mdrndesigns/pegboardlab/plan/layout_v2.pdf

# P E G B O A R D L A B · S T U D I O L A Y O U T P L A N v 2

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

## A · IMPE RI A L · c hi p b o a r d 1 9 · 1 : 7. 5

31 × 50 · Ø7.6 · 23.876 square · studs Ø7.8 × 18 · 30 × 50 holes

Tool bag

HL

End
nippers

HD

Spring clamp L
×2

HD

Spring
clamp S ×2

HD

Combination
square

HJ

GWS 12V grinder

HS

Drill bit case

TR

GKS 12V circular saw HS | Bits · small parts TR

Accessory box

TR

Glue
pen

HD

GSR 12V drill

HS

GRO 12V
rotary

HS

Chisels ×3 +
gouge

RK

Screwdrivers
×2

RK

Marking
knife
HJ

Tool-Check Plus

TR

Ratchet

HJ

Hex keys ×9

RK

Laser level TR | Future Wera ×6 RK

Pliers ×6 + crimper slot

RK

Work light tube

HD

Aviation
snips

HJ

Scissors

HJ

Wrenches ×2 + spare RK | Multitool TR | Spare J ×2 (knife · cutter) HJ

5 M E A S U R E · M A R K ( n e a r e s t t h e b e n c h )
Rules 150 · 300 MG | Digital caliper HS | Micrometer HJ | Protractor HJ | Tape measure HS | Pens · markers ×8 RK | Test leads · cable CL | Zone labels ×6 PL

Spare J
×2
(quick-draw)

HJ

Scriber · feelers RK | Spare (future measure) HJ

### 1 C L A M P S · S Q U A R E · B A G

2 B O S C H 1 2 V S Y S T EM | 3 I RW I N H A N D T O O L S | 4 W E R A · D R I V E · L E V E L

### 6 C U T · G R I P · P OW E R

### 7 B E N C H B I N S ( e x i s t i n g )

C L E A R

## C · M E T RI C · p o r t r ai t ? · 1 : 7. 5

450 × 1850 ? · Ø4.9 · 27.44 / 13.72 · confirm · 16 × 133 holes

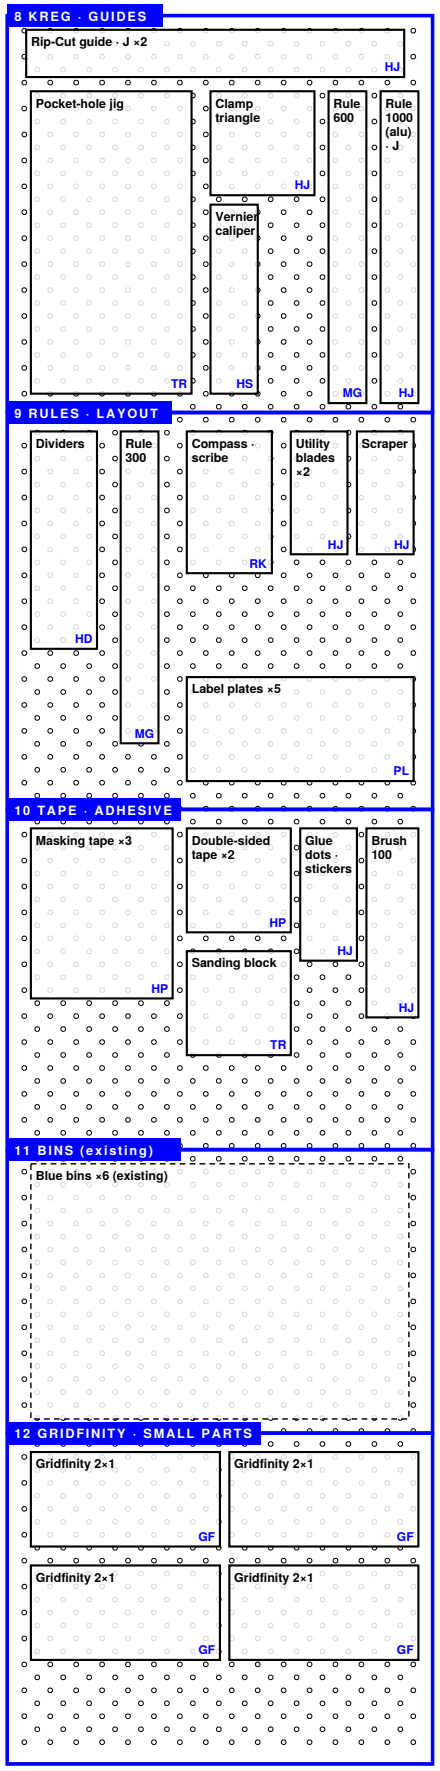
[picture p1: figure]
Rip-Cut guide · J ×2; Pocket-hole jig; Clamp triangle; Vernier caliper; Rule 600; Rule 1000 (alu) · J; Dividers; Rule 300; Compass · scribe; Utility blades ×2; Scraper; Label plates ×5; Masking tape ×3 HP; Double-sided tape ×2 HP; Glue dots · stickers HJ; Brush 100 HJ; Sanding block; Blue bins ×6 (existing); Gridfinity 2×1

1 2 G RI D F I N I T Y · S M A L L P A R T S

## B · M E T RI C · l a n d s c a p e 4 mm · 1 : 1 0

2100 × 530 · Ø4.9 · 27.44 / 13.72 lattice · right 700 kept for the filament boxes ? · 76 × 36 holes

F-clamps ×4

HJ

Straightedge 1000
HJ

Pull saw · hand saws

HJ

Extension cord

HR

Label plates ×3
PL

Gridfinity 4×1

GF

Gridfinity 4×1

GF

Gridfinity 4×1

GF

Gridfinity 4×1

GF

Gridfinity 4×1

GF

Gridfinity 4×1

GF

Gridfinity 4×1

GF

1 3 L O N G T O O L S · S AW S · C L A M P S

1 4 G R I D F I NI T Y S H E L F R OW · h a r d w a r e

F I L A M E N T B O X E S ( b e n c h ) ?

## A C CES S O R Y C O DES

HS Holster · saddle | holster · hs_type=saddle | HR Holster · ring | holster · hs_type=ring
HJ Hook · J | hook · hk_type=j | HD Hook · double prong | hook · hk_type=double
HL Hook · loop | hook · hk_type=loop | HP Hook · peg (rolls) | hook · hk_type=peg
RK Rack · holes / slots | rack · rk_type=… | TR Tray / bin | tray · tr_type=…
MG Magnet strip | magstrip · mg_mode=embed | CL Clip · cables | clip · cl_type=snap
GF Gridfinity shelf | gridfinity · gf_nx × gf_ny | PL Label plate | plate · pl_w × pl_h

## P L A CEME N T R U LE S

Brand clusters: Bosch 12V left column of A (holsters, one grab, no tilt) · Irwin centre · Wera right · Kreg on C.
Reach: measuring nearest the bench (A rows 36–45), then pliers · cutters · drivers · knives above (rows 24–36); clamps and the bag up top. Stability: two-part holders - a spine with ≥2 sized studs (Ø7.8 on A) or a J-hook + stop (C / B), the holder screwed to it with
Ø3.5 × 15 countersunk drywall screws; on A the screws run on into the studs and expand them in their holes. No steel hooks remain. Quick draw: holsters and J-hooks lift straight up; racks open to the front; nothing is stacked behind anything else.
Put-back: every holder carries its label plate (item name, brand) so an empty slot says what is missing.
Board B: long tools and a Gridfinity shelf row for small parts; right 700 mm stays bench space while the filament lives there.
To measure before printing: board C size and lattice, bench height under A (reach), fan / power-strip keep-out on A.

## P RI N T C O U N T ( h ol d e r s )

### 20 Hook · J 11 Gridfinity shelf 9 Rack · holes / slots 8 Tray / bin 7 Holster · saddle 6 Hook · double prong 3 Magnet strip 3 Label plate 2 Hook · peg (rolls) 1 Hook · loop 1 Clip · cables 1 existing / keep 1 Holster · ring

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
