mdrndesigns/pegboardlab/plan/bosch12v/bosch12v_sheet.pdf

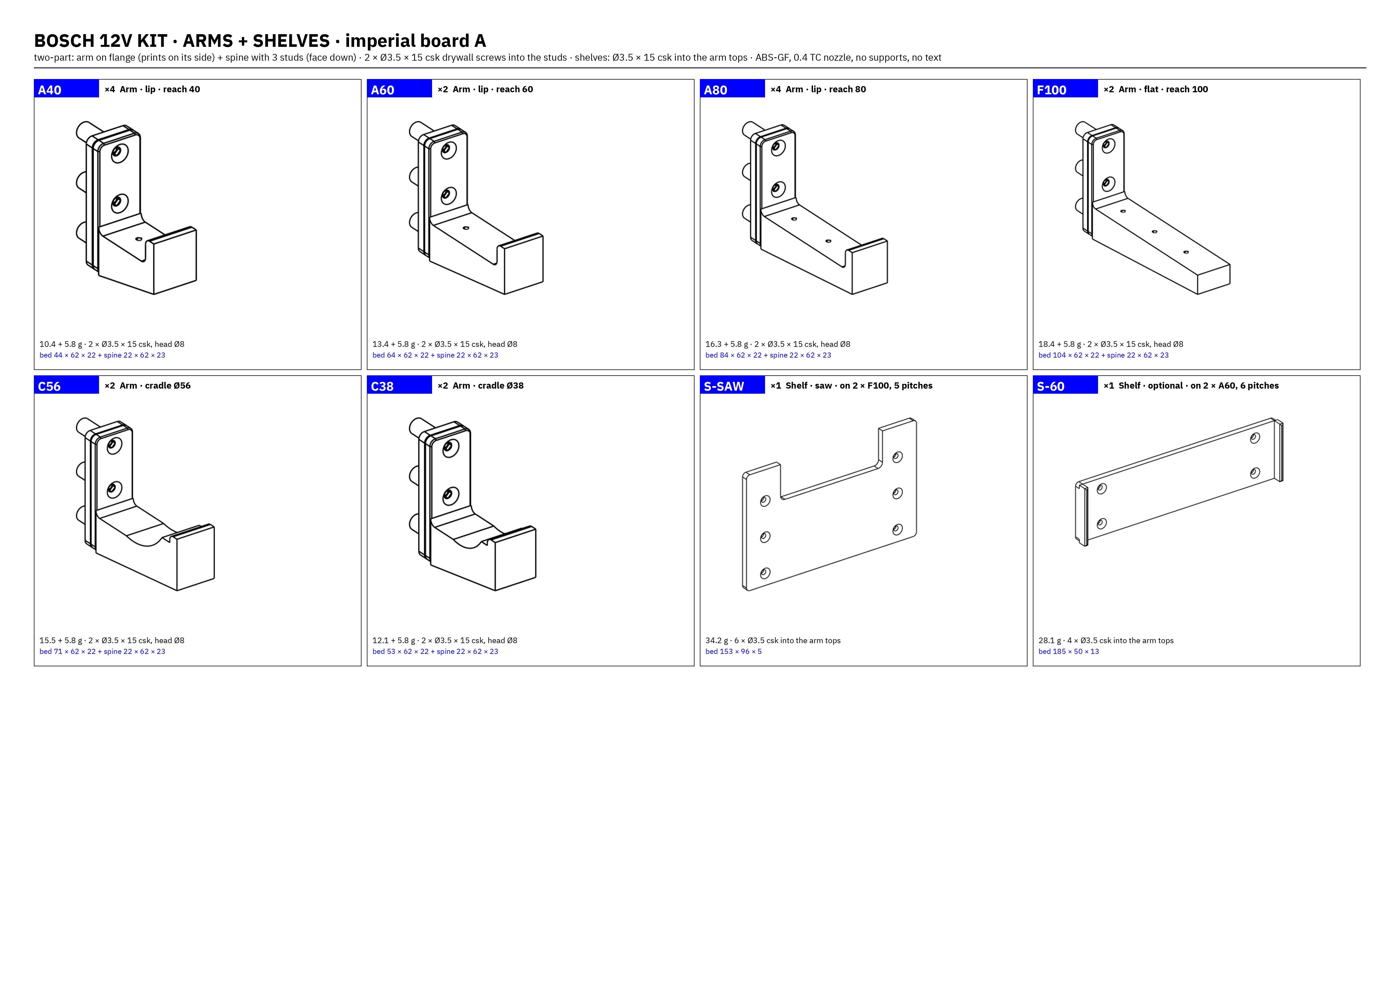
[picture p2: page 1]
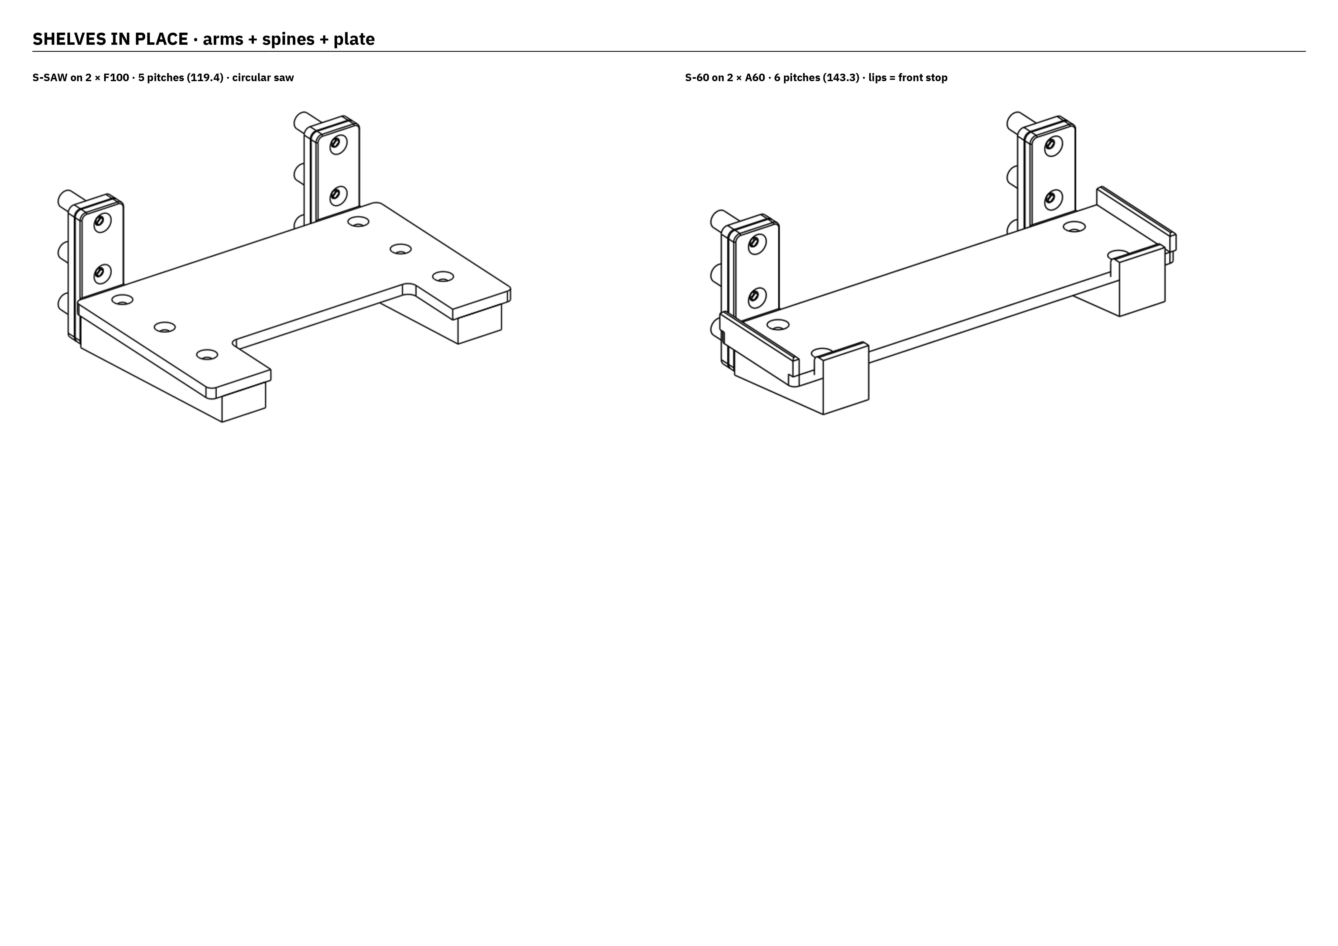
[picture p3: page 2]
