mdrndesigns/pegboardlab/plan/handtools/handtools_sheet.pdf

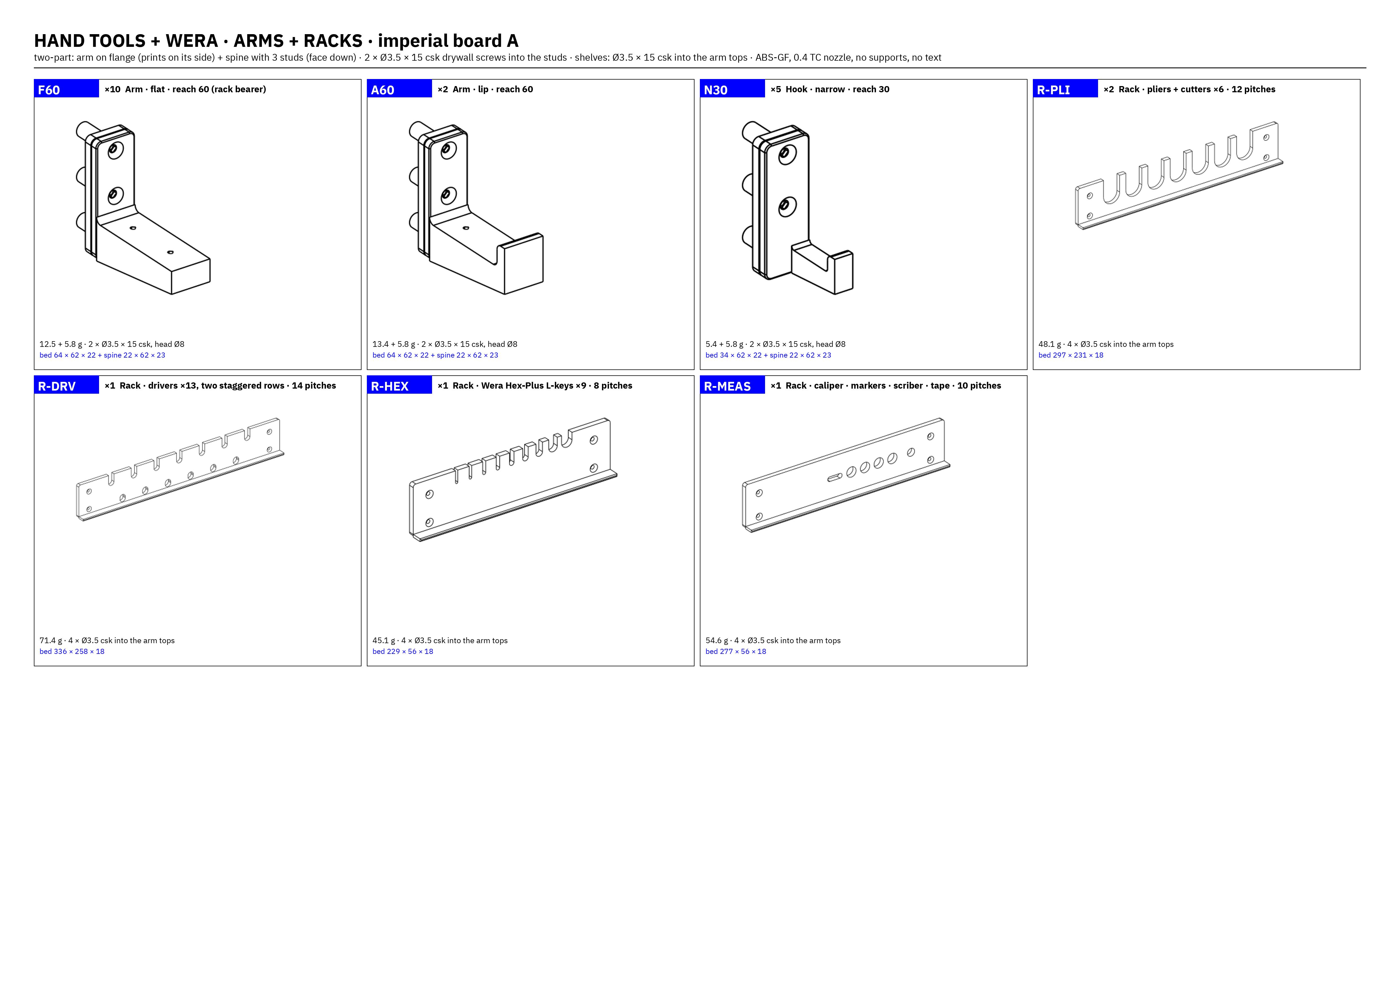
[picture p4: page 1]
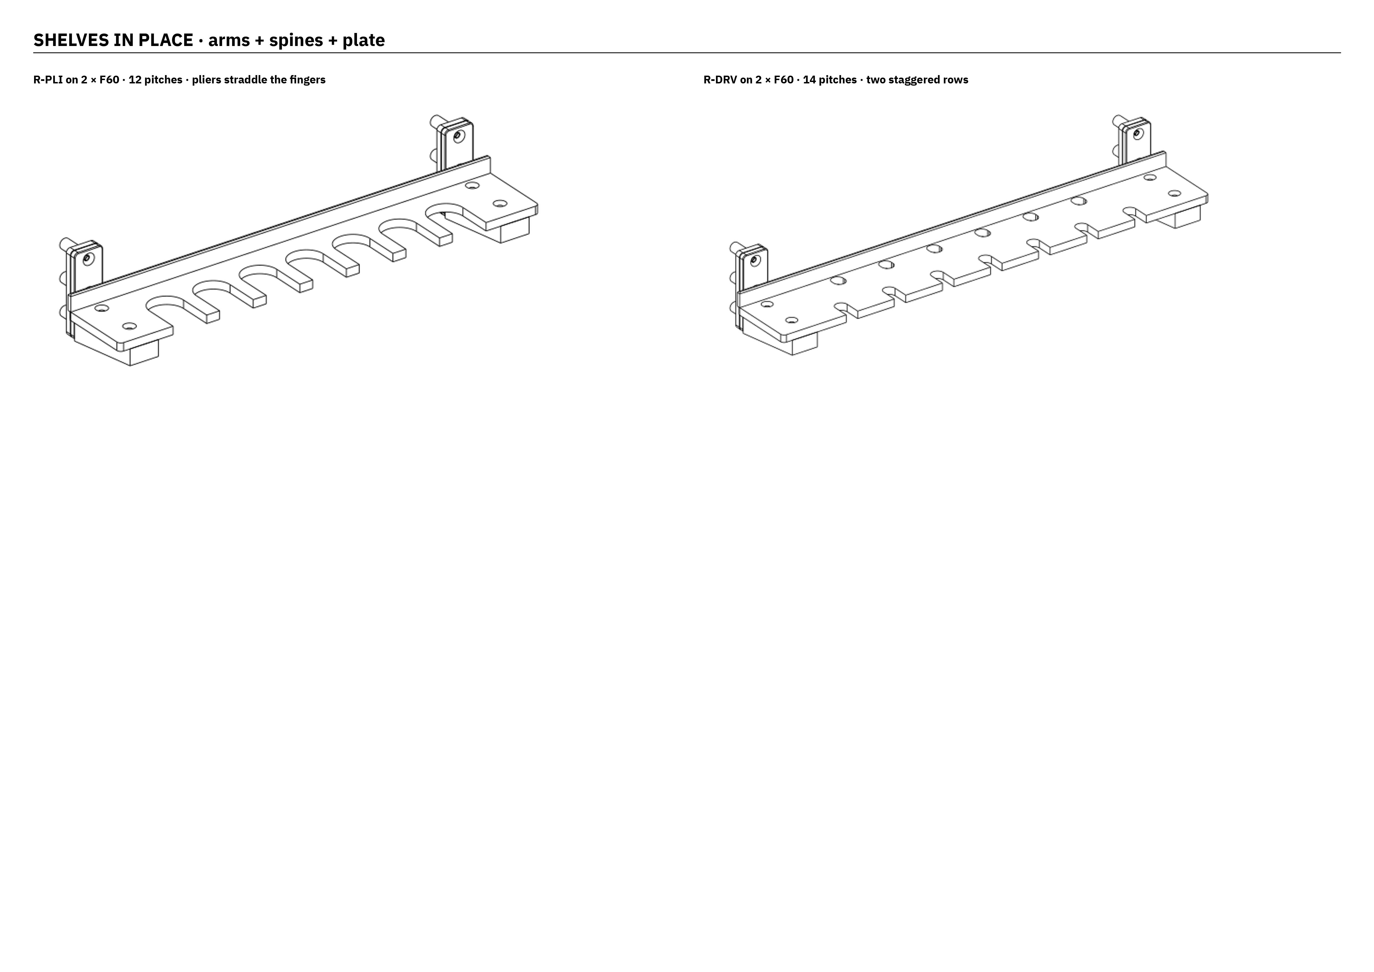
[picture p5: page 2]
