mdrndesigns/pegboardlab/plan/precision/precision_sheet.pdf

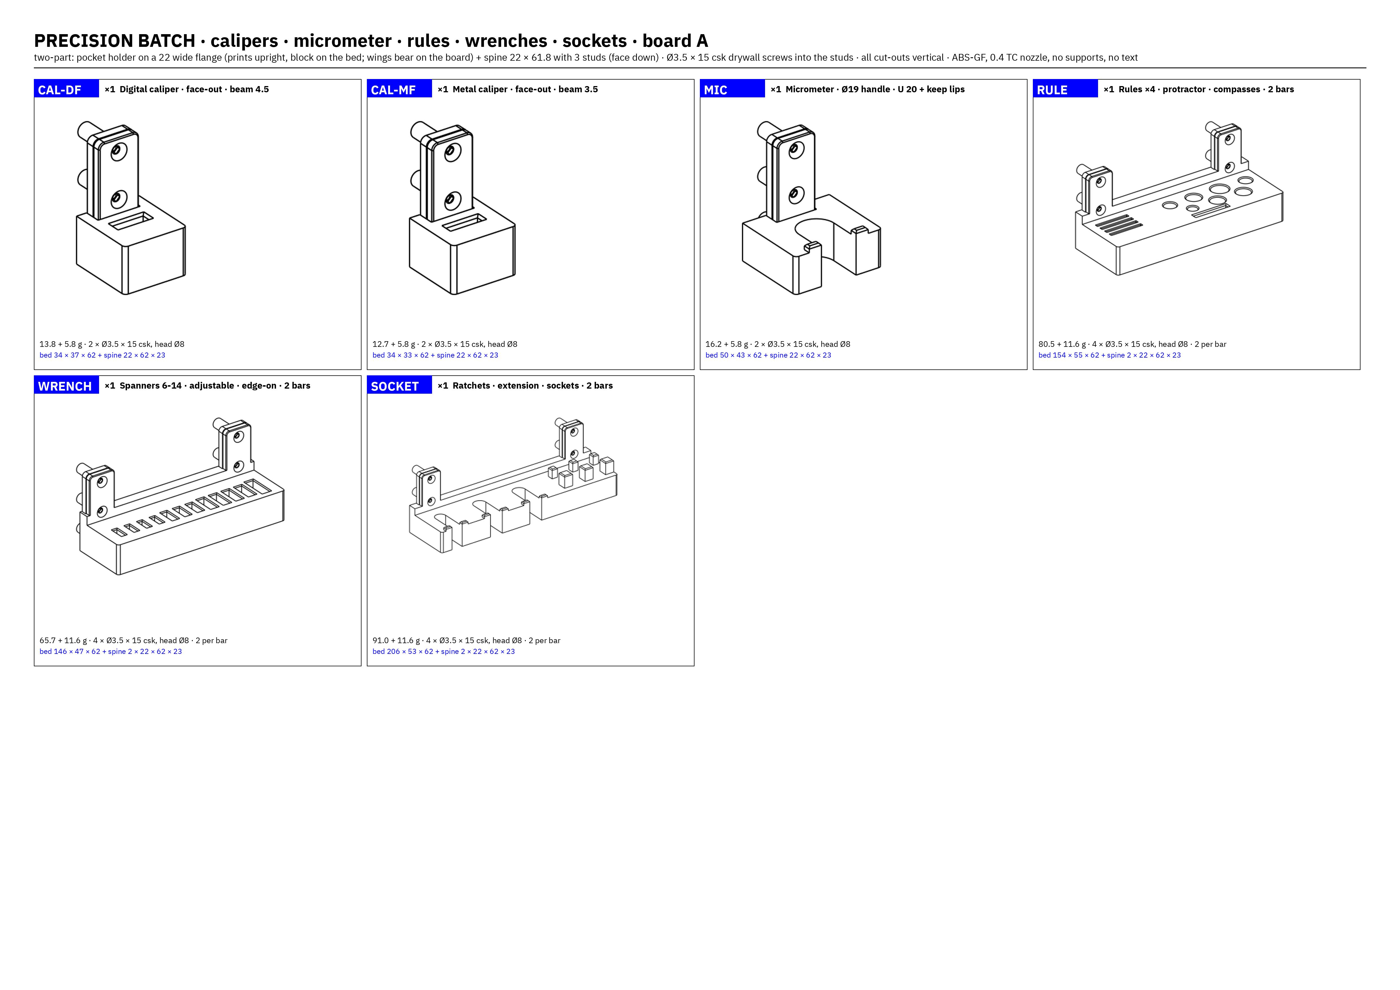
[picture p6: page 1]
