mdrndesigns/pegboardlab/plan/precision_v1_superseded/precision_sheet.pdf

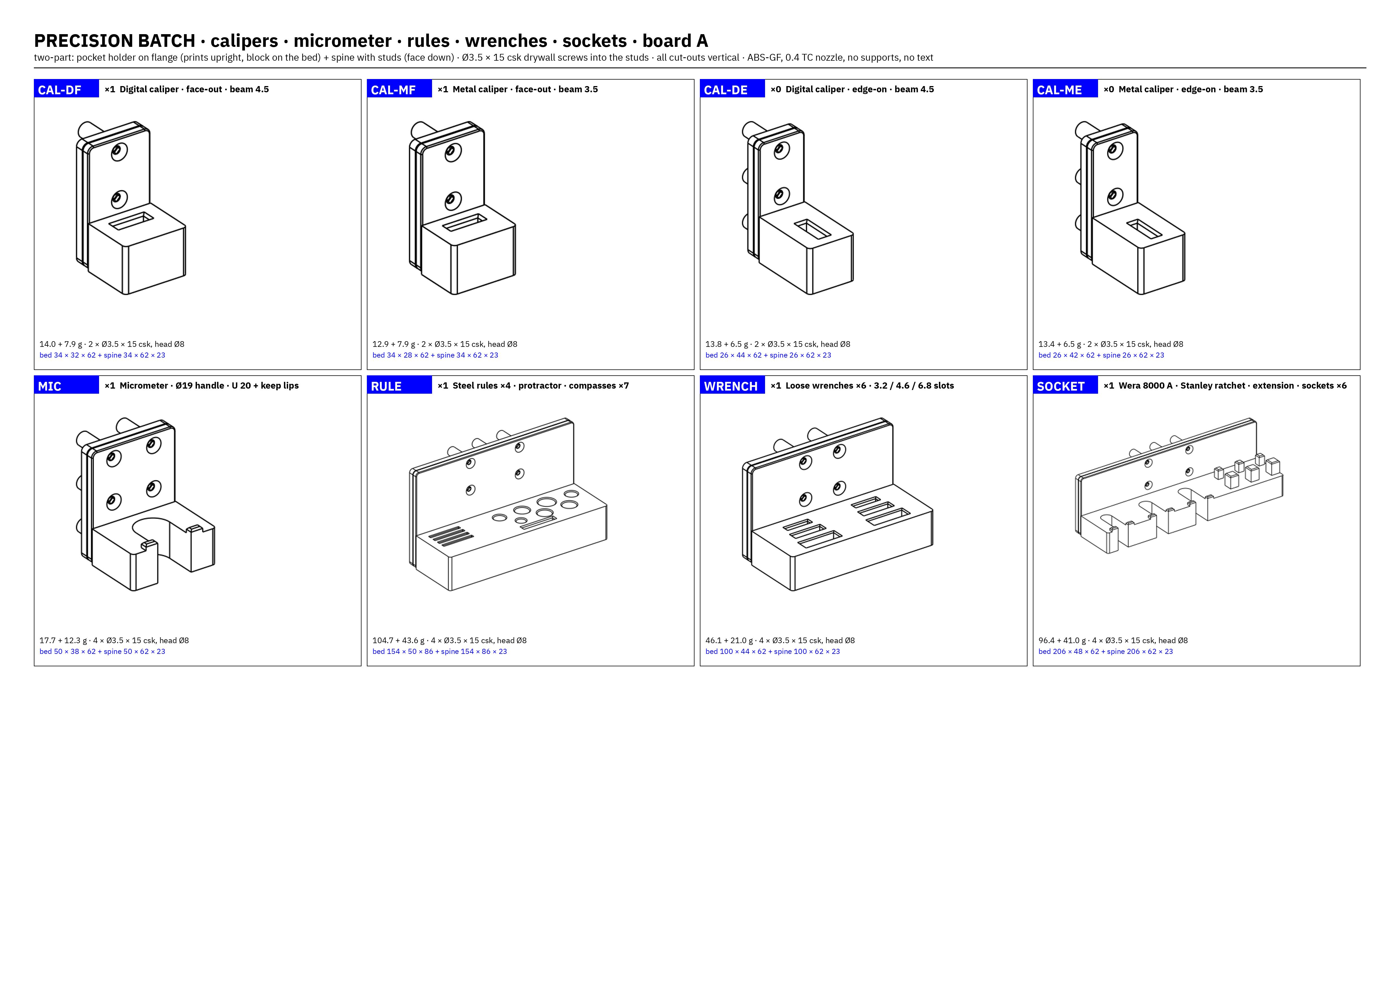
[picture p7: page 1]
