mdrndesigns/pegboardlab/plan/precision_v2_superseded/precision_sheet.pdf

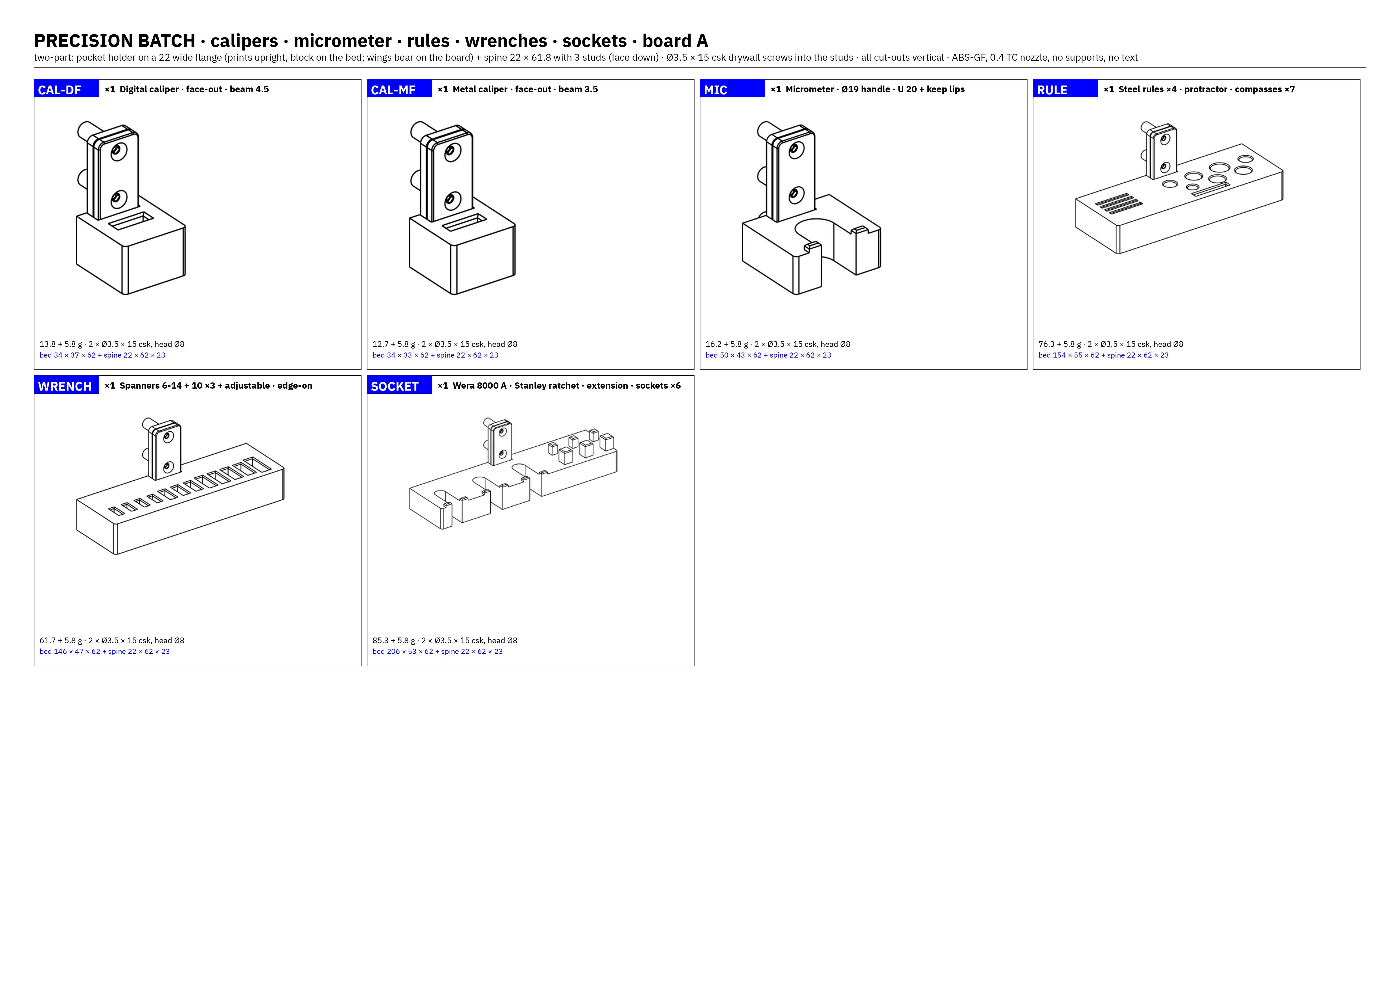
[picture p8: page 1]
