mdrndesigns/pegboardlab/plan/boardA/boardA_map.png

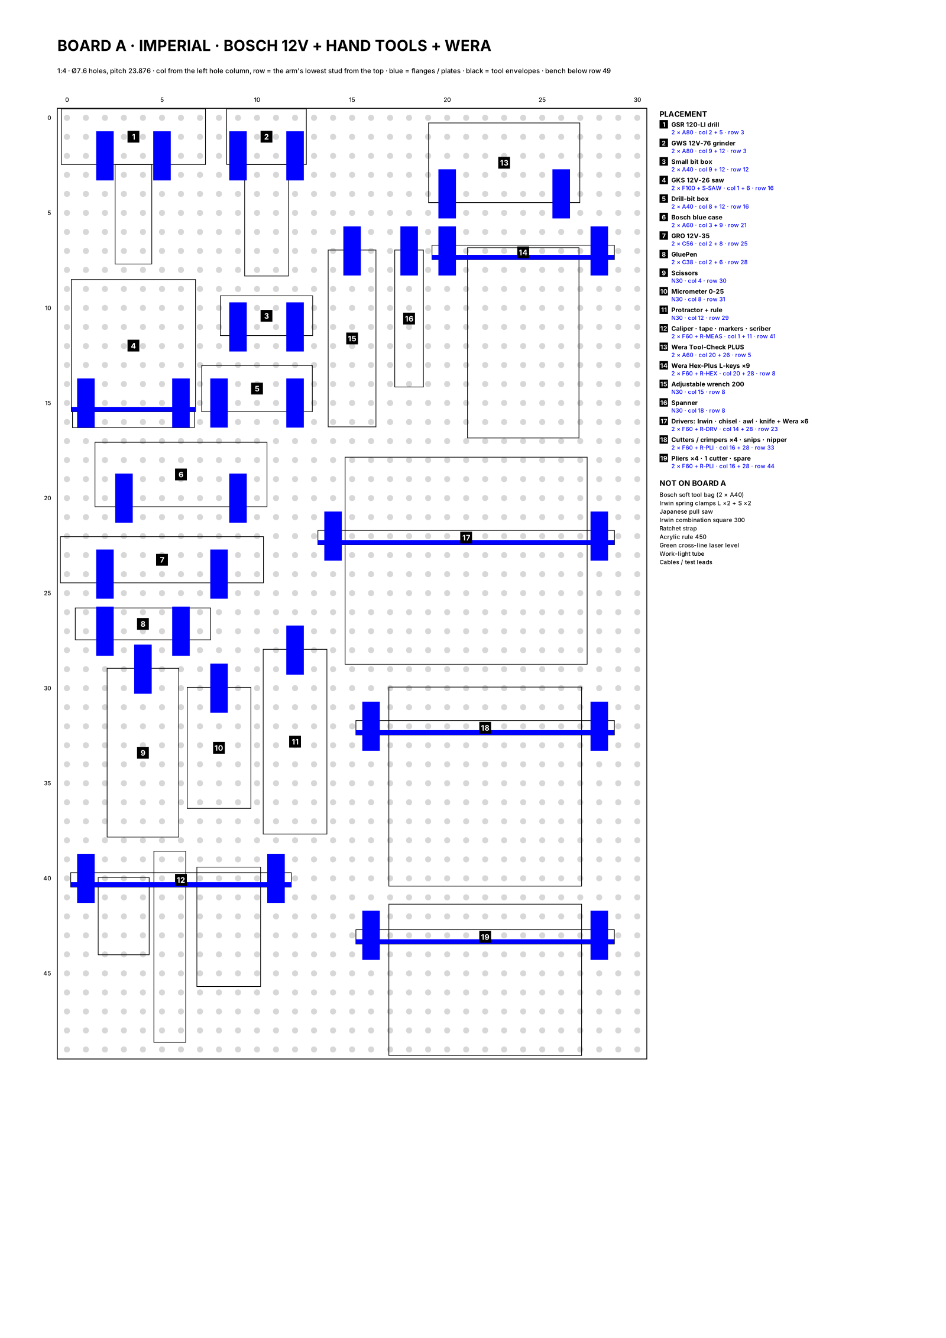
plan/boardA/boardA_map.png
