mdrndesigns/pegboardlab/plan/bosch12v/A40.png

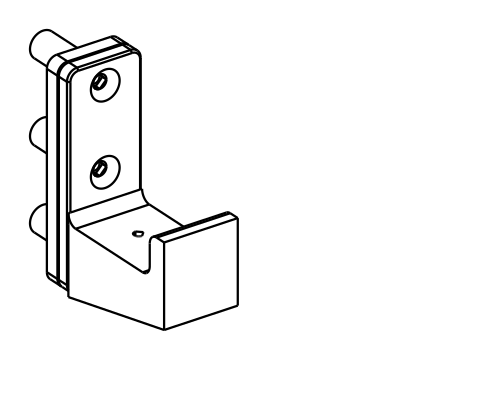
plan/bosch12v/A40.png
