mdrndesigns/pegboardlab/plan/bosch12v/A60.png

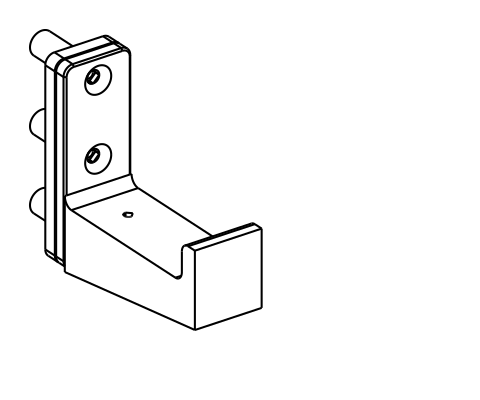
plan/bosch12v/A60.png
