mdrndesigns/pegboardlab/plan/bosch12v/A80.png

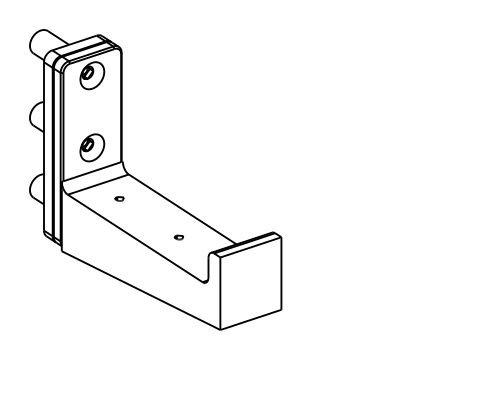
plan/bosch12v/A80.png
