mdrndesigns/pegboardlab/plan/bosch12v/bosch12v_map.png

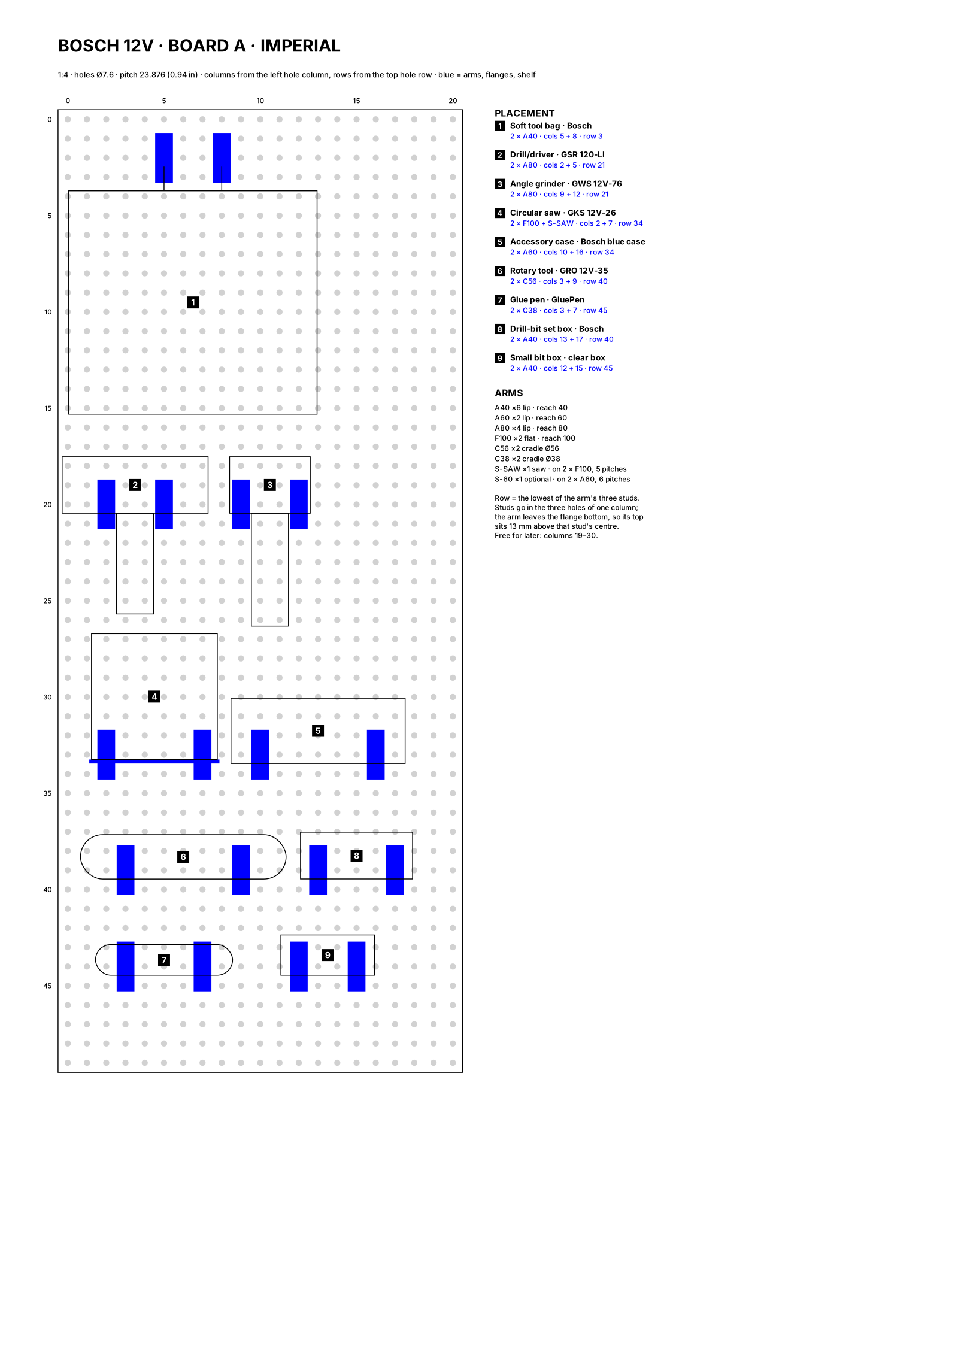
plan/bosch12v/bosch12v_map.png
