mdrndesigns/pegboardlab/plan/bosch12v/C56.png

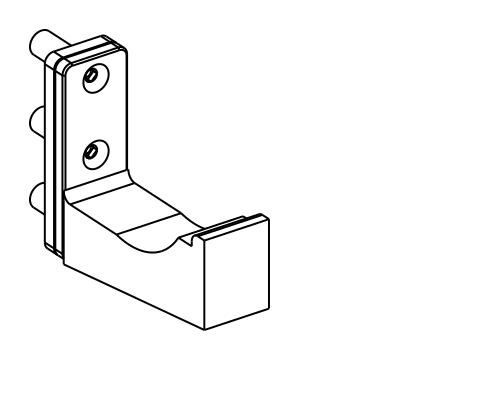
plan/bosch12v/C56.png
