mdrndesigns/pegboardlab/plan/bosch12v/S-60.png

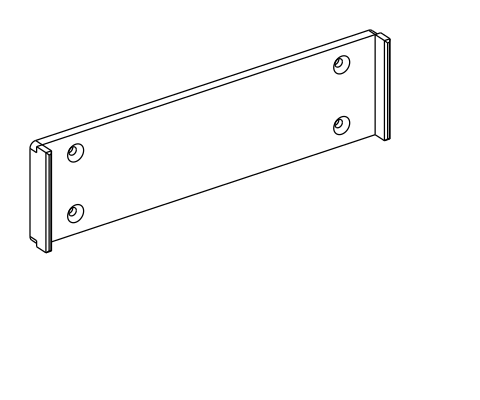
plan/bosch12v/S-60.png
