mdrndesigns/pegboardlab/plan/bosch12v/S-SAW.png

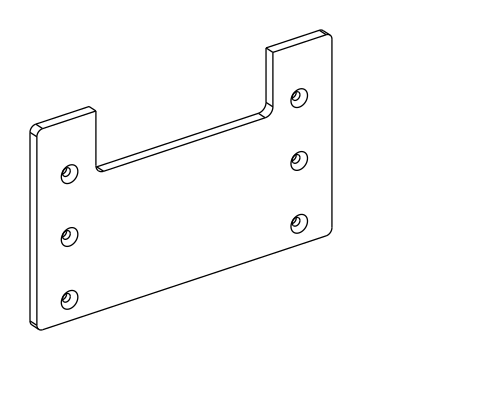
plan/bosch12v/S-SAW.png
