mdrndesigns/pegboardlab/plan/handtools/R-DRV.png

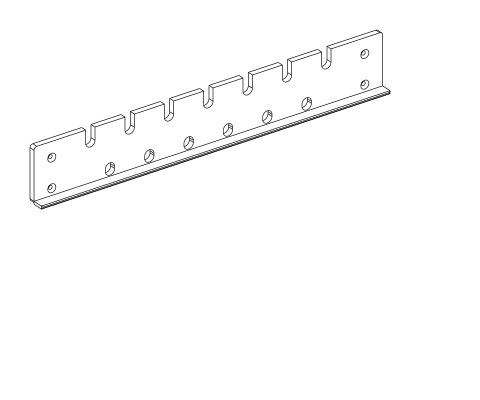
plan/handtools/R-DRV.png
