mdrndesigns/pegboardlab/plan/handtools/R-HEX.png

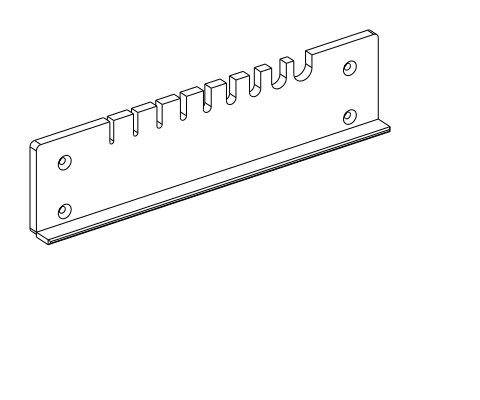
plan/handtools/R-HEX.png
