mdrndesigns/pegboardlab/plan/handtools/R-MEAS.png

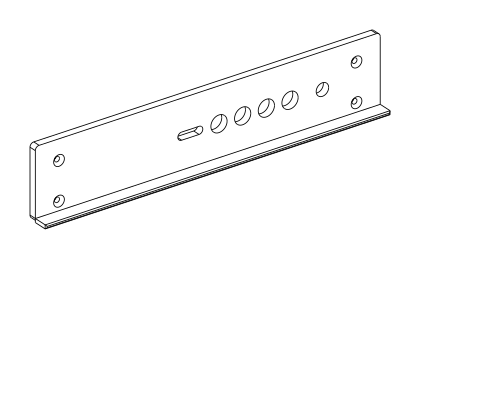
plan/handtools/R-MEAS.png
