mdrndesigns/pegboardlab/plan/handtools/R-PLI.png

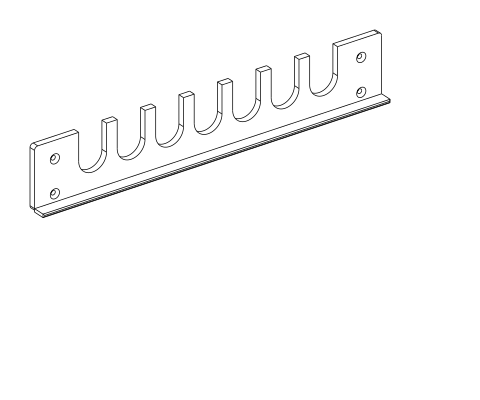
plan/handtools/R-PLI.png
