mdrndesigns/pegboardlab/plan/layout_v1.png

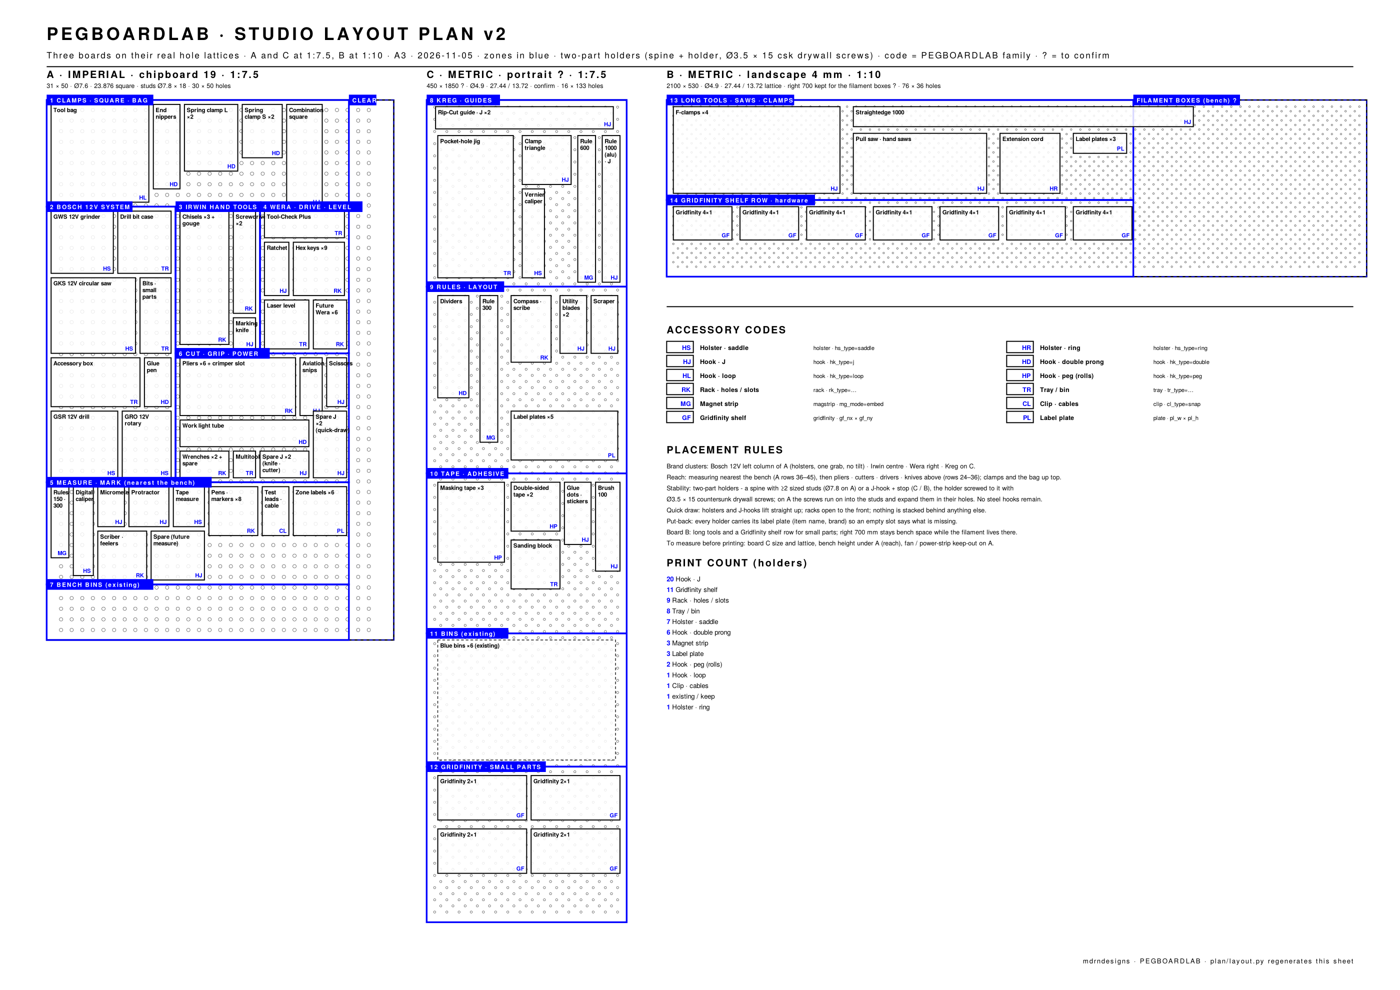
plan/layout_v1.png
