mdrndesigns/pegboardlab/plan/precision/CAL-DF.png

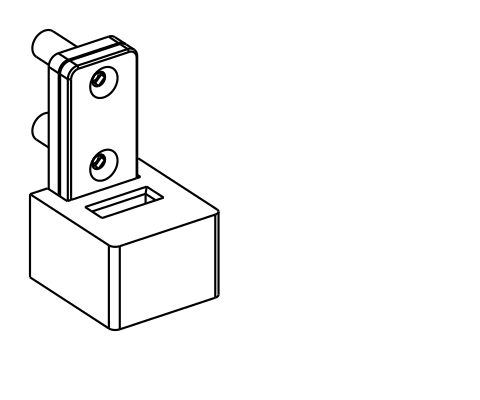
plan/precision/CAL-DF.png
