mdrndesigns/pegboardlab/plan/precision/MIC.png

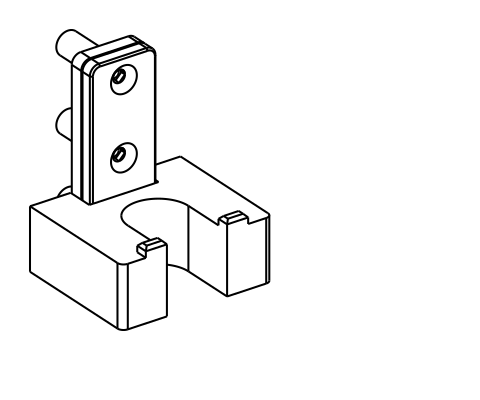
plan/precision/MIC.png
