mdrndesigns/pegboardlab/plan/precision/RULE.png

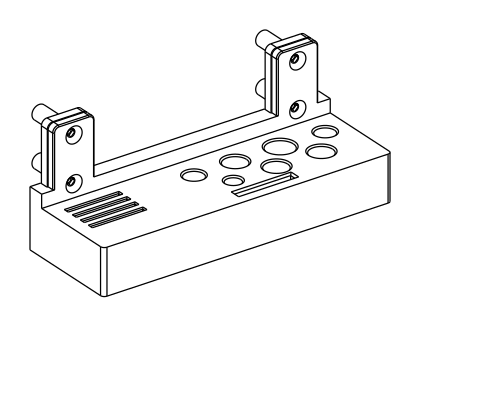
plan/precision/RULE.png
