mdrndesigns/pegboardlab/plan/precision/SOCKET.png

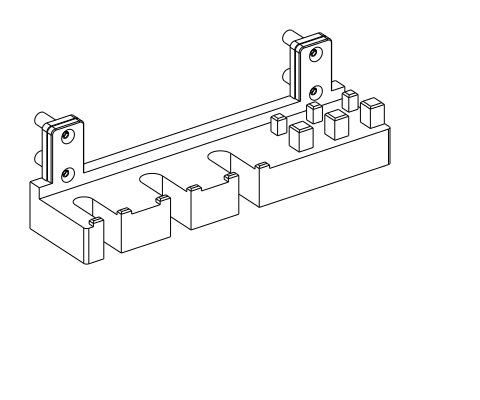
plan/precision/SOCKET.png
