mdrndesigns/pegboardlab/plan/precision/WRENCH.png

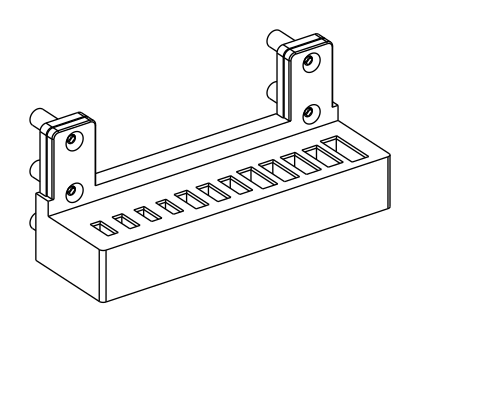
plan/precision/WRENCH.png
