mdrndesigns/pegboardlab/plan/wera_bike12/WERA-BIKE12_empty.png

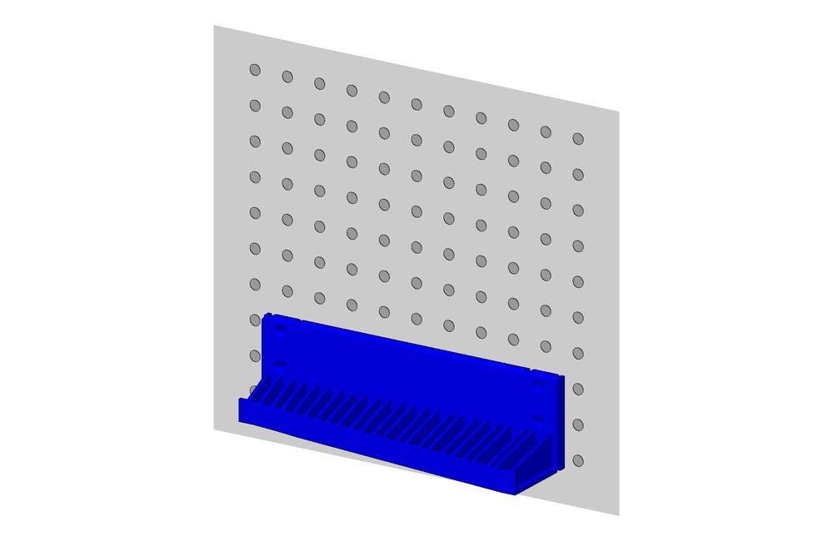
plan/wera_bike12/WERA-BIKE12_empty.png
