mdrndesigns/pegboardlab/plan/wera_bike12/WERA-BIKE12_side.png

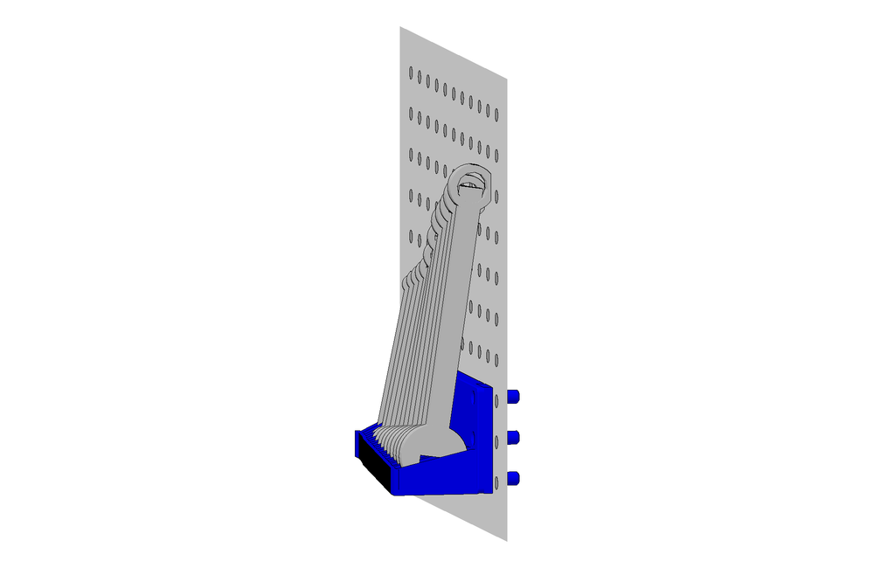
plan/wera_bike12/WERA-BIKE12_side.png
