mdrndesigns/pegboardlab/samples/clip_snap_imperial_preview.png

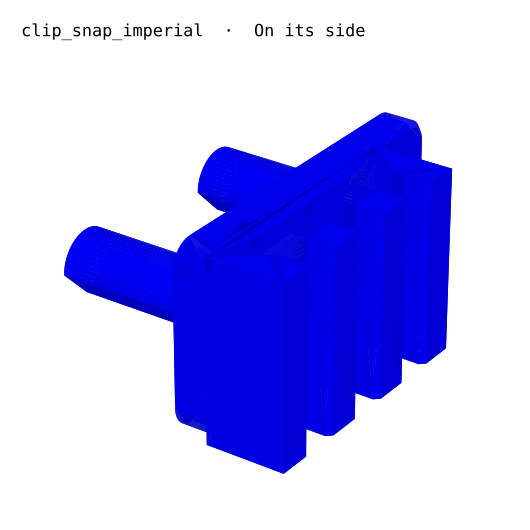
samples/clip_snap_imperial_preview.png
