mdrndesigns/pegboardlab/samples/gridfinity_2x1_tilt_preview.png

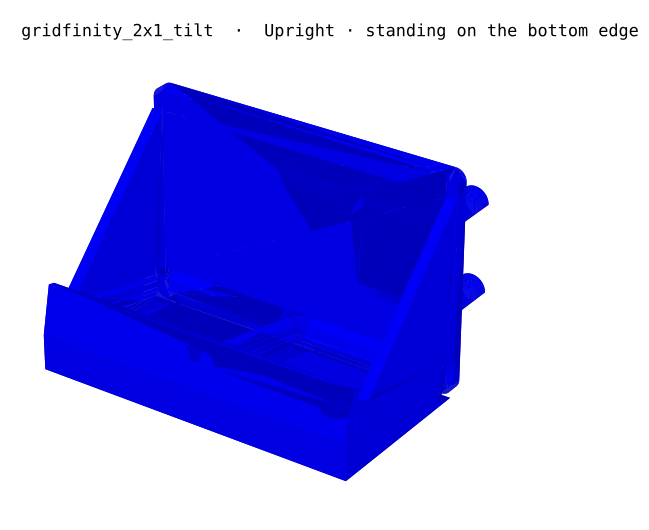
samples/gridfinity_2x1_tilt_preview.png
