mdrndesigns/pegboardlab/samples/holster_drill_imperial_preview.png

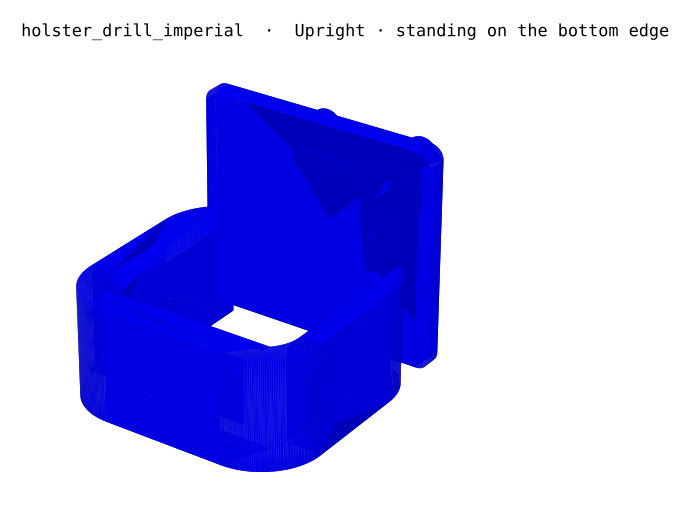
samples/holster_drill_imperial_preview.png
