mdrndesigns/pegboardlab/samples/hook_double_imperial_preview.png

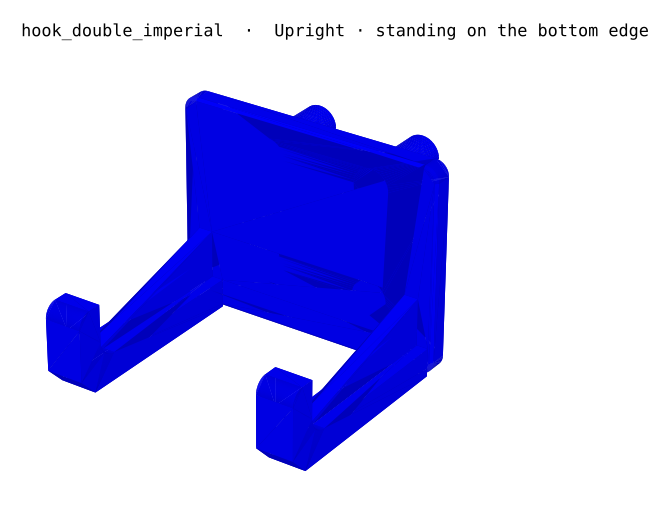
samples/hook_double_imperial_preview.png
