mdrndesigns/pegboardlab/samples/hook_j_imperial_preview.png

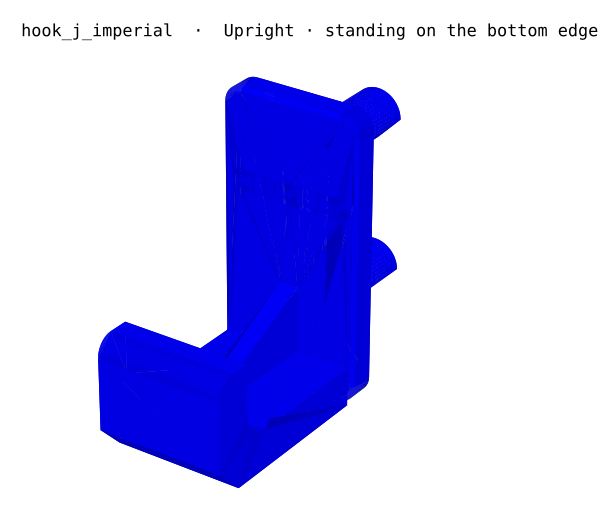
samples/hook_j_imperial_preview.png
