mdrndesigns/pegboardlab/samples/hook_j_metric_jhook_preview.png

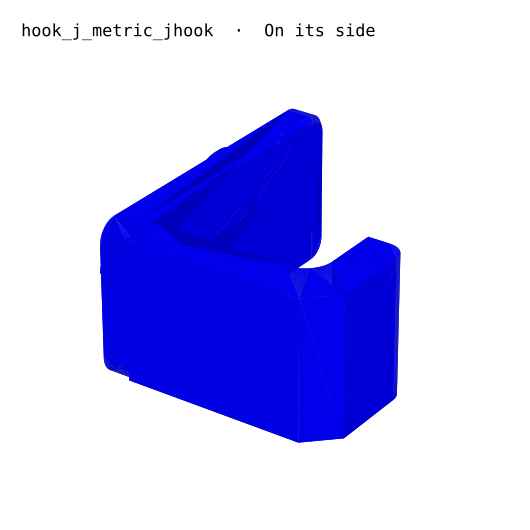
samples/hook_j_metric_jhook_preview.png
