mdrndesigns/pegboardlab/samples/hook_loop_imperial_preview.png

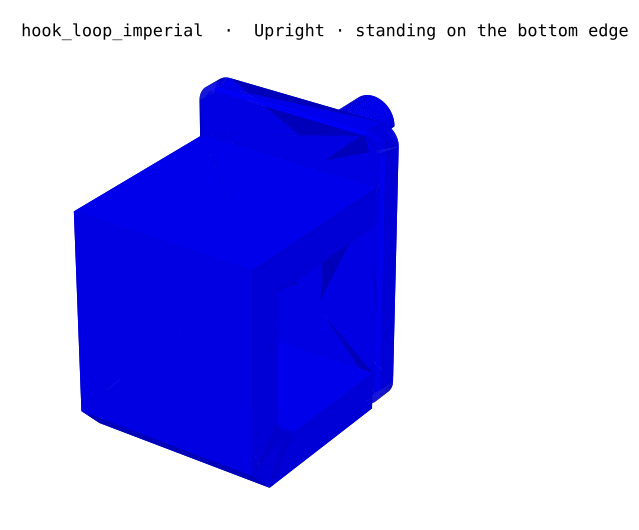
samples/hook_loop_imperial_preview.png
