mdrndesigns/pegboardlab/samples/magstrip_embed_preview.png

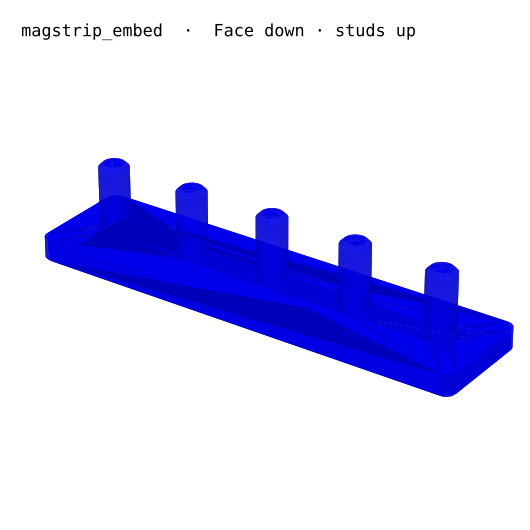
samples/magstrip_embed_preview.png
