mdrndesigns/pegboardlab/samples/nut_knurl_imperial_preview.png

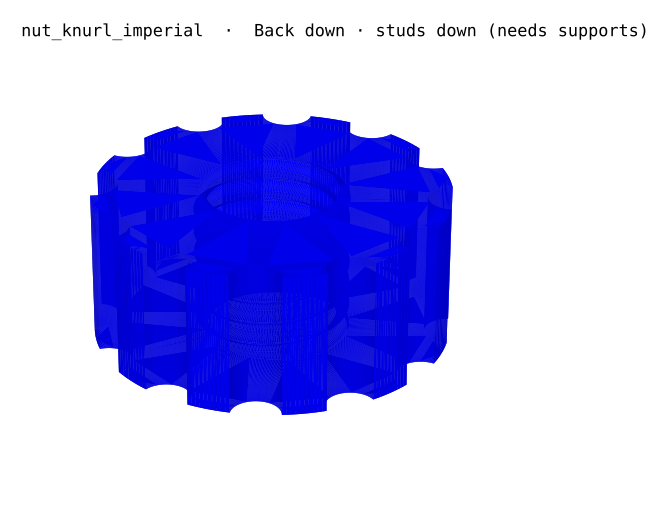
samples/nut_knurl_imperial_preview.png
