mdrndesigns/pegboardlab/samples/plate_label_imperial_preview.png

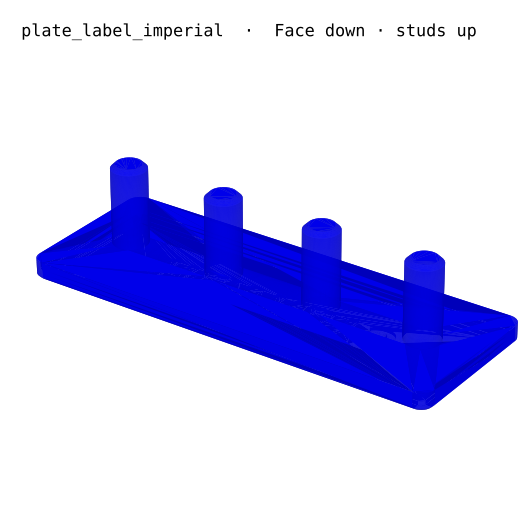
samples/plate_label_imperial_preview.png
