mdrndesigns/pegboardlab/samples/rack_bits_imperial_preview.png

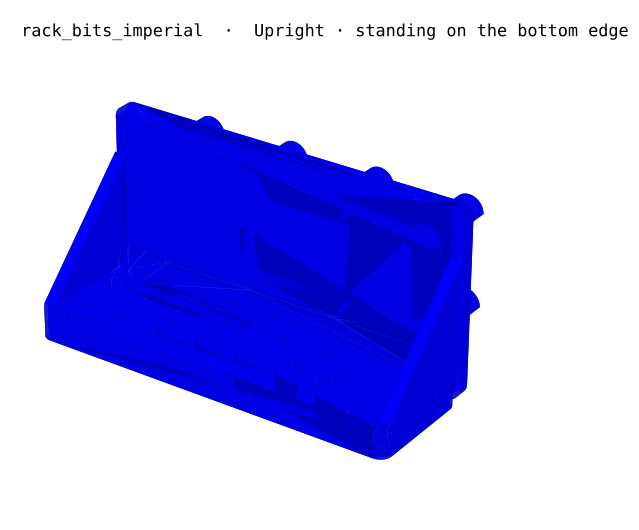
samples/rack_bits_imperial_preview.png
