mdrndesigns/pegboardlab/samples/rack_pens_metric_bore_preview.png

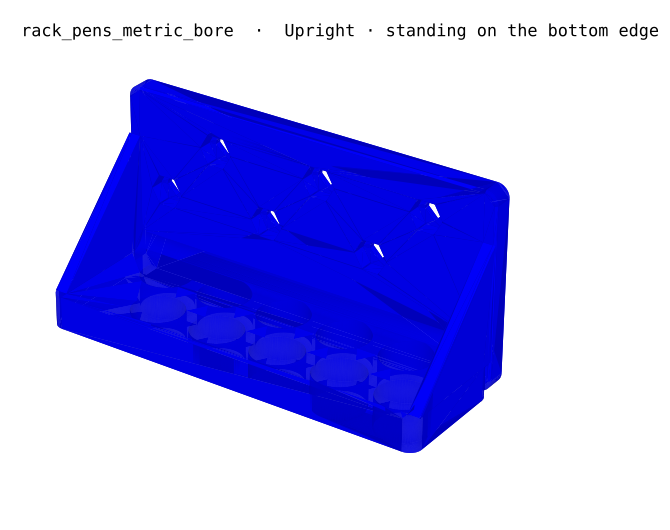
samples/rack_pens_metric_bore_preview.png
