mdrndesigns/pegboardlab/samples/rack_wrenches_imperial_preview.png

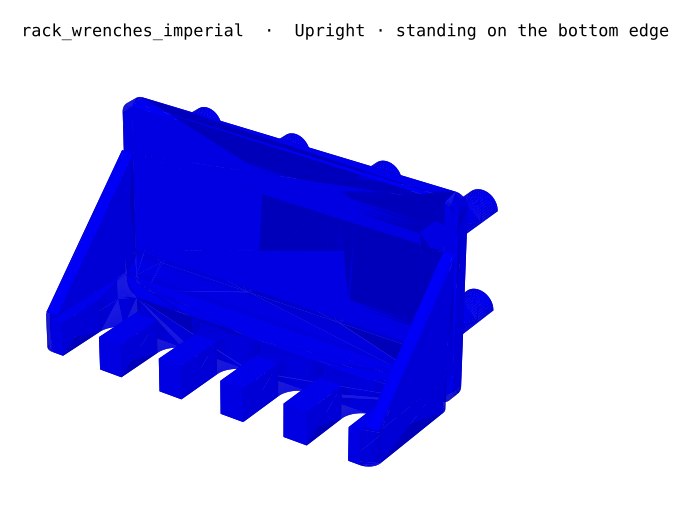
samples/rack_wrenches_imperial_preview.png
