mdrndesigns/pegboardlab/samples/split_clip_exploded.png

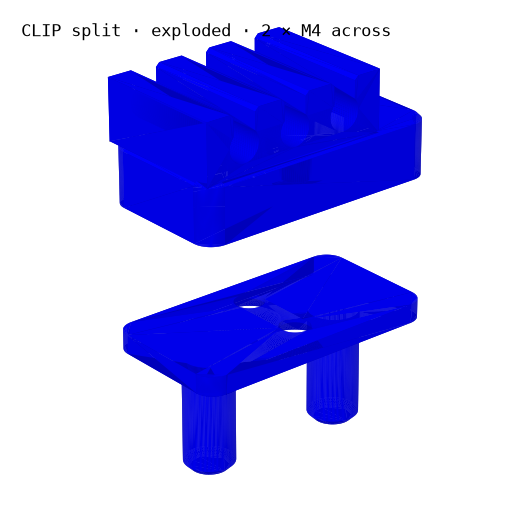
samples/split_clip_exploded.png
