mdrndesigns/pegboardlab/samples/split_magstrip_body_matingface.png

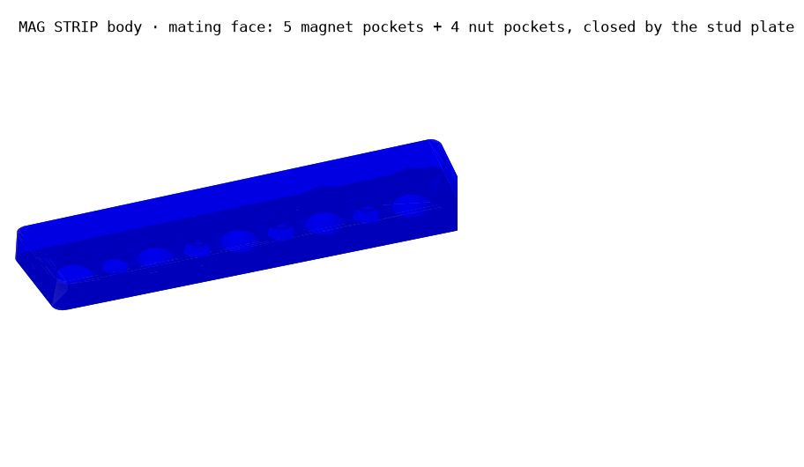
samples/split_magstrip_body_matingface.png
