mdrndesigns/pegboardlab/samples/split_rack_body_matingface.png

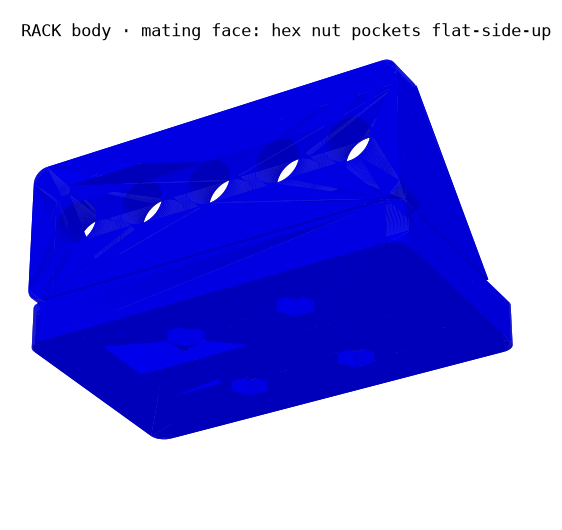
samples/split_rack_body_matingface.png
