mdrndesigns/pegboardlab/samples/split_rack_exploded_back.png

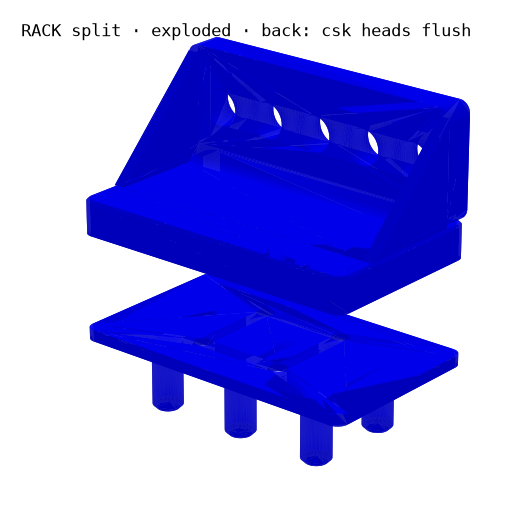
samples/split_rack_exploded_back.png
