mdrndesigns/pegboardlab/samples/split_rack_exploded_front.png

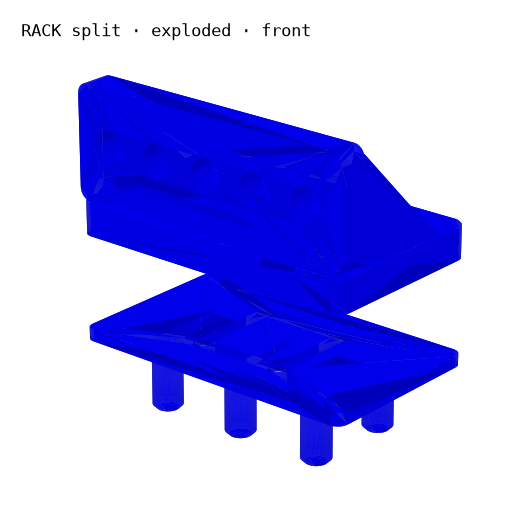
samples/split_rack_exploded_front.png
