mdrndesigns/pegboardlab/samples/split_rack_studplate_upright.png

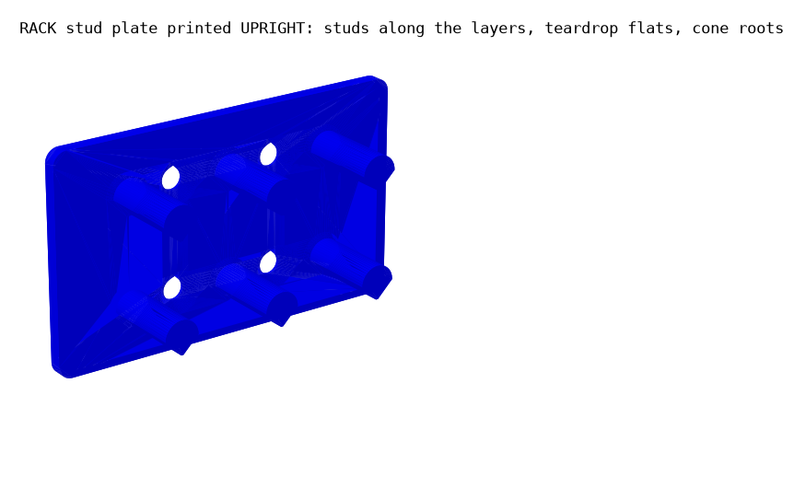
samples/split_rack_studplate_upright.png
