mdrndesigns/pegboardlab/samples/stud_root_options.png

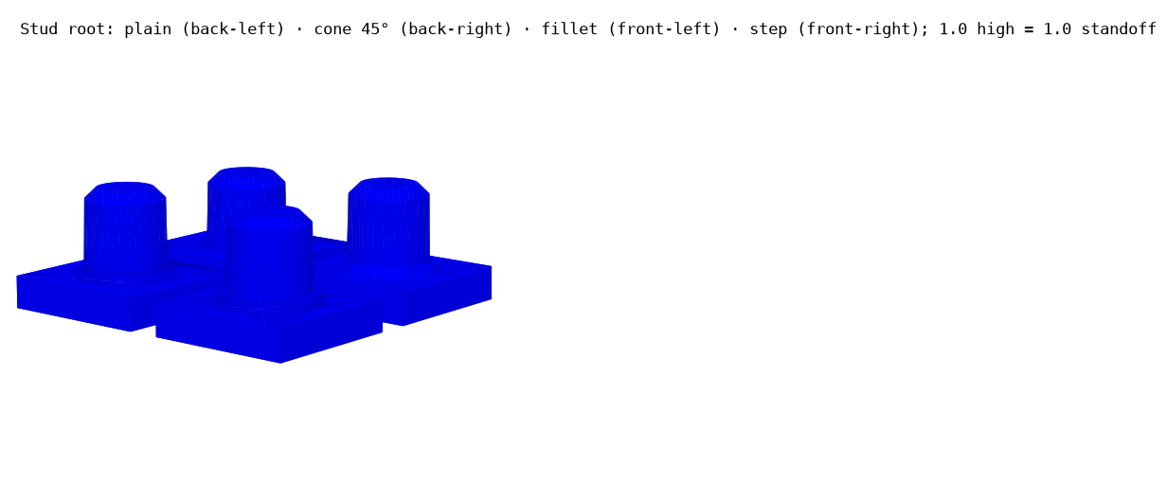
samples/stud_root_options.png
