mdrndesigns/pegboardlab/samples/tray_bin_magnets_preview.png

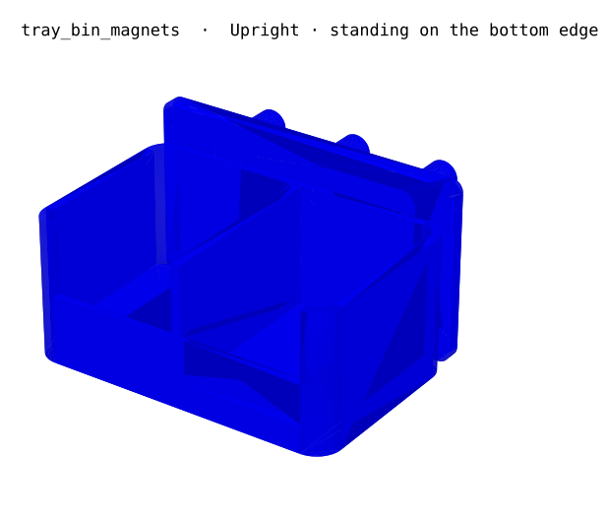
samples/tray_bin_magnets_preview.png
