mdrndesigns/pegboardlab/samples/tray_cup_metric_preview.png

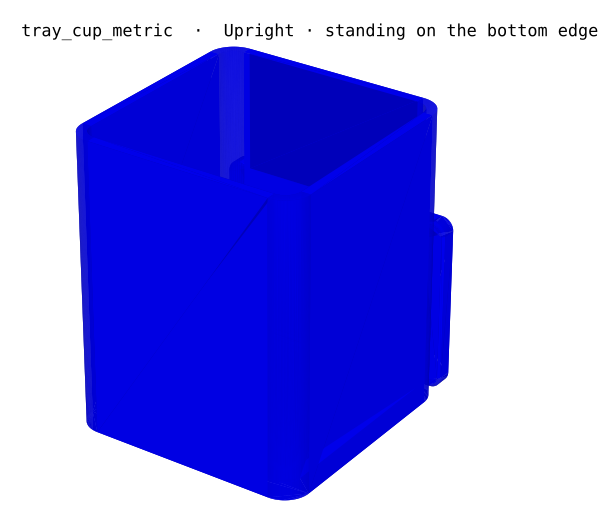
samples/tray_cup_metric_preview.png
