mdrndesigns/pegboardlab/plan/bosch12v/inventory.csv

id | item | n | family | status | holder_g | spine_g | holder_cm3 | spine_cm3 | holder_bed | spine_bed | screws | studs | plate | orient | unsupported | valid | open_edges | interference | warnings
A40 | Arm · lip · reach 40 | 4 | arm | ok | 10.4 | 5.8 | 20.8 | 9.1 | 44 × 62 × 22 | 22 × 62 × 23 | 2 × Ø3.5 × 15 csk, head Ø8 | 3 | 22.0 × 61.8 × 4.0 | On its side | 38.1 | True | 0 | 0.0 | Plate heightened to 61.8 to cover the pattern.
A60 | Arm · lip · reach 60 | 2 | arm | ok | 13.4 | 5.8 | 27.8 | 9.1 | 64 × 62 × 22 | 22 × 62 × 23 | 2 × Ø3.5 × 15 csk, head Ø8 | 3 | 22.0 × 61.8 × 4.0 | On its side | 62.3 | True | 0 | 0.0 | Plate heightened to 61.8 to cover the pattern.
A80 | Arm · lip · reach 80 | 4 | arm | ok | 16.3 | 5.8 | 34.9 | 9.1 | 84 × 62 × 22 | 22 × 62 × 23 | 2 × Ø3.5 × 15 csk, head Ø8 | 3 | 22.0 × 61.8 × 4.0 | On its side | 62.3 | True | 0 | 0.0 | Plate heightened to 61.8 to cover the pattern.
F100 | Arm · flat · reach 100 | 2 | arm | ok | 18.4 | 5.8 | 40.3 | 9.1 | 104 × 62 × 22 | 22 × 62 × 23 | 2 × Ø3.5 × 15 csk, head Ø8 | 3 | 22.0 × 61.8 × 4.0 | On its side | 86.5 | True | 0 | 0.0 | Plate heightened to 61.8 to cover the pattern.
C56 | Arm · cradle Ø56 | 2 | arm | ok | 15.5 | 5.8 | 34.0 | 9.1 | 71 × 62 × 22 | 22 × 62 × 23 | 2 × Ø3.5 × 15 csk, head Ø8 | 3 | 22.0 × 61.8 × 4.0 | On its side | 13.9 | True | 0 | 0.0 | Plate heightened to 61.8 to cover the pattern.
C38 | Arm · cradle Ø38 | 2 | arm | ok | 12.1 | 5.8 | 25.5 | 9.1 | 53 × 62 × 22 | 22 × 62 × 23 | 2 × Ø3.5 × 15 csk, head Ø8 | 3 | 22.0 × 61.8 × 4.0 | On its side | 13.9 | True | 0 | 0.0 | Plate heightened to 61.8 to cover the pattern.
S-SAW | Shelf · saw · on 2 × F100, 5 pitches | 1 | shelf | ok | 34.2 | 0 | 59.2 | 0 | 153 × 96 × 5 | 153 × 96 × 5 | 6 × Ø3.5 csk into the arm tops |  | 0.0 × 0.0 × 4.0 | Back down · studs down (needs supports) | 0.0 | True | 0 | 0.0
S-60 | Shelf · optional · on 2 × A60, 6 pitches | 1 | shelf | ok | 28.1 | 0 | 47.7 | 0 | 185 × 50 × 13 | 185 × 50 × 13 | 4 × Ø3.5 csk into the arm tops |  | 0.0 × 0.0 × 4.0 | Back down · studs down (needs supports) | 7.8 | True | 0 | 0.0
