mdrndesigns/pegboardlab/plan/precision/inventory.csv

id | item | n | status | holder_g | spine_g | holder_bed | spine_bed | screws | unsupported | valid | open_edges | interference
CAL-DF | Digital caliper · face-out · beam 4.5 | 1 | ok | 13.8 | 5.8 | 34 × 37 × 62 | 22 × 62 × 23 | 2 × Ø3.5 × 15 csk, head Ø8 | 14.6 | True | 0 | 0.0
CAL-MF | Metal caliper · face-out · beam 3.5 | 1 | ok | 12.7 | 5.8 | 34 × 33 × 62 | 22 × 62 × 23 | 2 × Ø3.5 × 15 csk, head Ø8 | 14.6 | True | 0 | 0.0
MIC | Micrometer · Ø19 handle · U 20 + keep lips | 1 | ok | 16.2 | 5.8 | 50 × 43 × 62 | 22 × 62 × 23 | 2 × Ø3.5 × 15 csk, head Ø8 | 14.6 | True | 0 | 0.0
RULE | Rules ×4 · protractor · compasses · 2 bars | 1 | ok | 80.5 | 11.6 | 154 × 55 × 62 | 2 × 22 × 62 × 23 | 4 × Ø3.5 × 15 csk, head Ø8 · 2 per bar | 29.3 | True | 0 | 0.0
WRENCH | Spanners 6-14 · adjustable · edge-on · 2 bars | 1 | ok | 65.7 | 11.6 | 146 × 47 × 62 | 2 × 22 × 62 × 23 | 4 × Ø3.5 × 15 csk, head Ø8 · 2 per bar | 29.3 | True | 0 | 0.0
SOCKET | Ratchets · extension · sockets · 2 bars | 1 | ok | 91.0 | 11.6 | 206 × 53 × 62 | 2 × 22 × 62 × 23 | 4 × Ø3.5 × 15 csk, head Ø8 · 2 per bar | 29.3 | True | 0 | 0.0
