mdrndesigns/pegboardlab/plan/prints_inventory.csv

board | brand | family | id | item | n | status | zone | holder_bed | holder_cm3 | holder_g | interference | open_edges | orient | plate | screws | secs | spine | spine_bed | spine_cm3 | spine_g | studs | unsupported | valid | warnings
imperial_19 | Bosch | hook | A1-01 | Tool bag | 1 | ok | 1 | 34 × 46 × 92 | 27.1 | 15.8 | 0.0 | 0 | Upright · standing on the bottom edge | 34.0 × 92.0 × 4.0 | 2 × Ø3.5 × 15 csk, head Ø8 | 5.2 | 34 × 92 × 5 · pilot Ø2.8 × 11.5: 6.5 into the studs | 34 × 92 × 23 | 18.0 | 10.9 | 3 | 31.7 | True
imperial_19 | — | hook | A1-02 | End nippers | 1 | ok | 1 | 22 × 39 × 70 | 11.8 | 7.6 | 0.0 | 0 | Upright · standing on the bottom edge | 22.0 × 70.0 × 4.0 | 2 × Ø3.5 × 15 csk, head Ø8 | 3.2 | 22 × 70 × 5 · pilot Ø2.8 × 11.5: 6.5 into the studs | 22 × 70 × 23 | 9.2 | 5.8 | 2 | 25.8 | True
imperial_19 | Irwin | hook | A1-03 | Spring clamps L ×2 | 1 | ok | 1 | 74 × 54 × 48 | 54.9 | 26.6 | 0.0 | 0 | Upright · standing on the bottom edge | 74.0 × 48.0 × 4.0 | 2 × Ø3.5 × 15 csk, head Ø8 | 2.5 | 74 × 48 × 5 · pilot Ø2.8 × 11.5: 6.5 into the studs | 74 × 48 × 23 | 19.2 | 11.5 | 2 | 38.0 | True
imperial_19 | Irwin | hook | A1-04 | Spring clamps S ×2 | 1 | ok | 1 | 62 × 49 × 48 | 36.5 | 19.3 | 0.0 | 0 | Upright · standing on the bottom edge | 62.0 × 48.0 × 4.0 | 2 × Ø3.5 × 15 csk, head Ø8 | 3.2 | 62 × 48 × 5 · pilot Ø2.8 × 11.5: 6.5 into the studs | 62 × 48 × 23 | 16.4 | 9.8 | 2 | 38.2 | True
imperial_19 | Irwin | hook | A1-05 | Combination square | 1 | ok | 1 | 32 × 39 × 70 | 17.0 | 10.5 | 0.0 | 0 | Upright · standing on the bottom edge | 32.0 × 70.0 × 4.0 | 2 × Ø3.5 × 15 csk, head Ø8 | 3.5 | 32 × 70 × 5 · pilot Ø2.8 × 11.5: 6.5 into the studs | 32 × 70 × 23 | 12.7 | 7.8 | 2 | 30.2 | True
imperial_19 | Bosch | holster | A2-01 | GWS 12V-76 grinder | 1 | ok | 2 | 64 × 74 × 72 | 74.0 | 37.5 | 0.0 | 0 | Upright · standing on the bottom edge | 64.0 × 72.0 × 4.0 | 2 × Ø3.5 × 15 csk, head Ø8 | 3.8 | 64 × 72 × 5 · pilot Ø2.8 × 11.5: 6.5 into the studs | 64 × 72 × 23 | 26.2 | 15.5 | 4 | 42.5 | True
imperial_19 | Bosch | tray | A2-02 | Drill bit case | 1 | ok | 2 | 172 × 46 × 51 | 85.6 | 56.5 | 0.0 | 0 | Upright · standing on the bottom edge | 172.0 × 51.0 × 4.0 | 4 × Ø3.5 × 15 csk, head Ø8 | 5.6 | 172 × 51 × 5 · pilot Ø2.8 × 11.5: 6.5 into the studs | 172 × 51 × 23 | 49.4 | 29.0 | 7 | 44.9 | True
imperial_19 | Bosch | holster | A2-03 | GKS 12V-26 circular saw | 1 | ok | 2 | 76 × 91 × 72 | 116.1 | 54.6 | 0.0 | 0 | Upright · standing on the bottom edge | 76.0 × 72.0 × 4.0 | 2 × Ø3.5 × 15 csk, head Ø8 | 3.8 | 76 × 72 × 5 · pilot Ø2.8 × 11.5: 6.5 into the studs | 76 × 72 × 23 | 30.5 | 17.9 | 4 | 49.0 | True
imperial_19 | Bosch | tray | A2-04 | Bits · small parts box | 1 | ok | 2 | 80 × 40 × 51 | 35.1 | 25.0 | 0.0 | 0 | Upright · standing on the bottom edge | 80.0 × 51.0 × 4.0 | 2 × Ø3.5 × 15 csk, head Ø8 | 3.2 | 80 × 51 × 5 · pilot Ø2.8 × 11.5: 6.5 into the studs | 80 × 51 × 23 | 21.9 | 13.0 | 2 | 48.9 | True
imperial_19 | Bosch | tray | A2-05 | Accessory box | 1 | ok | 2 | 215 × 70 × 51 | 124.9 | 83.7 | 0.0 | 0 | Upright · standing on the bottom edge | 215.0 × 51.0 × 4.0 | 4 × Ø3.5 × 15 csk, head Ø8 | 5.6 | 215 × 51 × 5 · pilot Ø2.8 × 11.5: 6.5 into the studs | 215 × 51 × 23 | 62.0 | 36.2 | 9 | 44.7 | True
imperial_19 | Bosch | holster | A2-06 | Glue pen | 1 | ok | 2 | 54 × 62 × 94 | 50.3 | 28.4 | 0.0 | 0 | Upright · standing on the bottom edge | 54.0 × 94.0 × 4.0 | 2 × Ø3.5 × 15 csk, head Ø8 | 3.4 | 54 × 94 × 5 · pilot Ø2.8 × 11.5: 6.5 into the studs | 54 × 94 × 23 | 27.7 | 16.3 | 3 | 39.5 | True
imperial_19 | Bosch | holster | A2-07 | GSR 12V-35 drill | 1 | ok | 2 | 64 × 76 × 72 | 75.4 | 38.1 | 0.0 | 0 | Upright · standing on the bottom edge | 64.0 × 72.0 × 4.0 | 2 × Ø3.5 × 15 csk, head Ø8 | 4.3 | 64 × 72 × 5 · pilot Ø2.8 × 11.5: 6.5 into the studs | 64 × 72 × 23 | 26.2 | 15.5 | 4 | 46.3 | True
imperial_19 | Bosch | holster | A2-08 | GRO 12V-35 rotary | 1 | ok | 2 | 50 × 53 × 72 | 41.0 | 21.7 | 0.0 | 0 | Upright · standing on the bottom edge | 50.0 × 72.0 × 4.0 | 2 × Ø3.5 × 15 csk, head Ø8 | 3.8 | 50 × 72 × 5 · pilot Ø2.8 × 11.5: 6.5 into the studs | 50 × 72 × 23 | 21.2 | 12.7 | 4 | 36.7 | True
imperial_19 | Irwin | rack | A3-01 | Chisels ×3 + gouge | 1 | ok | 3 | 160 × 40 × 56 | 78.4 | 45.0 | 0.0 | 0 | Upright · standing on the bottom edge | 160.0 × 56.0 × 4.0 | 4 × Ø3.5 × 15 csk, head Ø8 | 7.4 | 160 × 56 × 5 · pilot Ø2.8 × 11.5: 6.5 into the studs | 160 × 56 × 23 | 50.3 | 29.4 | 7 | 105.7 | True
imperial_19 | Irwin | rack | A3-02 | Screwdrivers ×2 + spare | 1 | ok | 3 | 105 × 36 × 56 | 51.1 | 29.1 | 0.0 | 0 | Upright · standing on the bottom edge | 105.0 × 56.0 × 4.0 | 4 × Ø3.5 × 15 csk, head Ø8 | 6.1 | 105 × 56 × 5 · pilot Ø2.8 × 11.5: 6.5 into the studs | 105 × 56 × 23 | 32.4 | 19.2 | 4 | 77.0 | True
imperial_19 | — | hook | A3-03 | Marking knife · sheath | 1 | ok | 3 | 27 × 34 × 70 | 13.5 | 8.5 | 0.0 | 0 | Upright · standing on the bottom edge | 27.0 × 70.0 × 4.0 | 2 × Ø3.5 × 15 csk, head Ø8 | 2.5 | 27 × 70 × 5 · pilot Ø2.8 × 11.5: 6.5 into the studs | 27 × 70 × 23 | 10.9 | 6.8 | 2 | 26.1 | True
imperial_19 | Wera | tray | A4-01 | Tool-Check Plus | 1 | ok | 4 | 200 × 52 × 51 | 89.5 | 59.9 | 0.0 | 0 | Upright · standing on the bottom edge | 200.0 × 51.0 × 4.0 | 4 × Ø3.5 × 15 csk, head Ø8 | 7.0 | 200 × 51 × 5 · pilot Ø2.8 × 11.5: 6.5 into the studs | 200 × 51 × 23 | 57.4 | 33.5 | 8 | 70.1 | True
imperial_19 | Wera | hook | A4-02 | Ratchet | 1 | ok | 4 | 22 × 34 × 70 | 9.9 | 6.5 | 0.0 | 0 | Upright · standing on the bottom edge | 21.8 × 70.0 × 4.0 | 2 × Ø3.5 × 15 csk, head Ø8 | 2.8 | 22 × 70 × 5 · pilot Ø2.8 × 11.5: 6.5 into the studs | 22 × 70 × 23 | 9.1 | 5.8 | 2 | 24.2 | True
imperial_19 | Wera | rack | A4-03 | Hex keys ×9 | 1 | ok | 4 | 137 × 30 × 58 | 64.3 | 36.1 | 0.0 | 0 | Upright · standing on the bottom edge | 136.8 × 58.0 × 4.0 | 4 × Ø3.5 × 15 csk, head Ø8 | 6.3 | 137 × 58 × 5 · pilot Ø2.8 × 11.5: 6.5 into the studs | 137 × 58 × 23 | 44.4 | 26.0 | 6 | 93.4 | True
imperial_19 | — | tray | A4-04 | Laser level | 1 | ok | 4 | 112 × 116 × 51 | 72.1 | 51.1 | 0.0 | 0 | Upright · standing on the bottom edge | 112.0 × 51.0 × 4.0 | 4 × Ø3.5 × 15 csk, head Ø8 | 4.3 | 112 × 51 × 5 · pilot Ø2.8 × 11.5: 6.5 into the studs | 112 × 51 × 23 | 32.4 | 19.2 | 5 | 66.1 | True
imperial_19 | Wera | rack | A4-05 | Future Wera drivers ×6 (spare) | 1 | ok | 4 | 146 × 36 × 56 | 68.3 | 39.0 | 0.0 | 0 | Upright · standing on the bottom edge | 146.0 × 56.0 × 4.0 | 4 × Ø3.5 × 15 csk, head Ø8 | 5.4 | 146 × 56 × 5 · pilot Ø2.8 × 11.5: 6.5 into the studs | 146 × 56 × 23 | 45.6 | 26.7 | 6 | 69.1 | True
imperial_19 | — | hook | A4-06 | Spare quickdraw J ×2 | 2 | ok | 4 | 22 × 39 × 70 | 11.8 | 7.6 | 0.0 | 0 | Upright · standing on the bottom edge | 22.0 × 70.0 × 4.0 | 2 × Ø3.5 × 15 csk, head Ø8 | 3.0 | 22 × 70 × 5 · pilot Ø2.8 × 11.5: 6.5 into the studs | 22 × 70 × 23 | 9.2 | 5.8 | 2 | 26.2 | True
imperial_19 | — | rack | A6-01 | Pliers ×6 + crimper slot | 1 | ok | 6 | 256 × 46 × 58 | 135.7 | 74.5 | 0.0 | 0 | Upright · standing on the bottom edge | 256.0 × 58.0 × 4.0 | 4 × Ø3.5 × 15 csk, head Ø8 | 7.2 | 256 × 58 × 5 · pilot Ø2.8 × 11.5: 6.5 into the studs | 256 × 58 × 23 | 83.1 | 48.1 | 11 | 156.2 | True
imperial_19 | — | hook | A6-02 | Aviation snips | 1 | ok | 6 | 27 × 39 × 70 | 14.6 | 9.1 | 0.0 | 0 | Upright · standing on the bottom edge | 27.0 × 70.0 × 4.0 | 2 × Ø3.5 × 15 csk, head Ø8 | 3.2 | 27 × 70 × 5 · pilot Ø2.8 × 11.5: 6.5 into the studs | 27 × 70 × 23 | 10.9 | 6.8 | 2 | 28.9 | True
imperial_19 | — | hook | A6-03 | Scissors | 1 | ok | 6 | 22 × 34 × 70 | 10.9 | 7.0 | 0.0 | 0 | Upright · standing on the bottom edge | 22.0 × 70.0 × 4.0 | 2 × Ø3.5 × 15 csk, head Ø8 | 4.9 | 22 × 70 × 5 · pilot Ø2.8 × 11.5: 6.5 into the studs | 22 × 70 × 23 | 9.2 | 5.8 | 2 | 28.1 | True
imperial_19 | — | rack | A6-04 | Wrenches: adjustable + spanner + spare | 1 | ok | 6 | 86 × 46 × 58 | 49.2 | 28.1 | 0.0 | 0 | Upright · standing on the bottom edge | 86.0 × 58.0 × 4.0 | 4 × Ø3.5 × 15 csk, head Ø8 | 5.1 | 86 × 58 × 5 · pilot Ø2.8 × 11.5: 6.5 into the studs | 86 × 58 × 23 | 28.0 | 16.6 | 4 | 73.3 | True
imperial_19 | — | hook | A6-05 | Work light tube Ø50 × 300 | 1 | ok | 6 | 278 × 59 × 48 | 69.3 | 43.5 | 0.0 | 0 | Upright · standing on the bottom edge | 278.0 × 48.0 × 4.0 | 4 × Ø3.5 × 15 csk, head Ø8 | 5.6 | 278 × 48 × 5 · pilot Ø2.8 × 11.5: 6.5 into the studs | 278 × 48 × 23 | 76.5 | 44.6 | 12 | 72.9 | True
imperial_19 | — | tray | A6-06 | Multitool (stands) | 1 | ok | 6 | 42 × 28 × 53 | 23.0 | 17.1 | 0.0 | 0 | Upright · standing on the bottom edge | 42.0 × 51.0 × 4.0 | 2 × Ø3.5 × 15 csk, head Ø8 | 2.0 | 42 × 51 × 5 · pilot Ø2.8 × 11.5: 6.5 into the studs | 42 × 51 × 23 | 12.2 | 7.5 | 2 | 20.9 | True | No free face for branding.
imperial_19 | — | hook | A6-07 | Spare knife / cutter J ×2 | 2 | ok | 6 | 22 × 34 × 70 | 10.9 | 7.0 | 0.0 | 0 | Upright · standing on the bottom edge | 22.0 × 70.0 × 4.0 | 2 × Ø3.5 × 15 csk, head Ø8 | 2.9 | 22 × 70 × 5 · pilot Ø2.8 × 11.5: 6.5 into the studs | 22 × 70 × 23 | 9.2 | 5.8 | 2 | 26.2 | True
imperial_19 | — | magstrip | A5-01 | Steel rules 150 · 300 | 1 | ok | 5 | 40 × 160 × 6 | 36.7 | 21.0 | 0.0 | 0 | Face down · studs up | 40.0 × 160.0 × 6.0 | 4 × Ø3.5 × 15 csk, head Ø8 | 4.2 | 40 × 160 × 5 · pilot Ø2.8 × 9.5: 4.5 into the studs | 40 × 160 × 23 | 37.6 | 22.3 | 7 | 332.0 | True
imperial_19 | — | holster | A5-02 | Digital caliper 150 | 1 | ok | 5 | 32 × 37 × 94 | 27.0 | 16.1 | 0.0 | 0 | Upright · standing on the bottom edge | 32.0 × 94.0 × 4.0 | 2 × Ø3.5 × 15 csk, head Ø8 | 3.2 | 32 × 94 × 5 · pilot Ø2.8 × 11.5: 6.5 into the studs | 32 × 94 × 23 | 17.4 | 10.6 | 3 | 29.6 | True
imperial_19 | — | hook | A5-03 | Micrometer 0-25 | 1 | ok | 5 | 22 × 34 × 70 | 10.9 | 7.0 | 0.0 | 0 | Upright · standing on the bottom edge | 22.0 × 70.0 × 4.0 | 2 × Ø3.5 × 15 csk, head Ø8 | 2.9 | 22 × 70 × 5 · pilot Ø2.8 × 11.5: 6.5 into the studs | 22 × 70 × 23 | 9.2 | 5.8 | 2 | 23.5 | True
imperial_19 | — | hook | A5-04 | Protractor | 1 | ok | 5 | 22 × 34 × 70 | 10.9 | 7.0 | 0.0 | 0 | Upright · standing on the bottom edge | 22.0 × 70.0 × 4.0 | 2 × Ø3.5 × 15 csk, head Ø8 | 4.0 | 22 × 70 × 5 · pilot Ø2.8 × 11.5: 6.5 into the studs | 22 × 70 × 23 | 9.2 | 5.8 | 2 | 23.8 | True
imperial_19 | — | rack | A5-05 | Scriber · feelers · punches | 1 | ok | 5 | 74 × 30 × 56 | 31.6 | 18.9 | 0.0 | 0 | Upright · standing on the bottom edge | 74.0 × 56.0 × 4.0 | 2 × Ø3.5 × 15 csk, head Ø8 | 4.2 | 74 × 56 × 5 · pilot Ø2.8 × 11.5: 6.5 into the studs | 74 × 56 × 23 | 22.2 | 13.1 | 2 | 64.4 | True
imperial_19 | Stanley | holster | A5-06 | Tape measure 8 m | 1 | ok | 5 | 62 × 90 × 70 | 71.5 | 37.9 | 0.0 | 0 | Upright · standing on the bottom edge | 62.0 × 70.0 × 4.0 | 2 × Ø3.5 × 15 csk, head Ø8 | 2.8 | 62 × 70 × 5 · pilot Ø2.8 × 11.5: 6.5 into the studs | 62 × 70 × 23 | 24.9 | 14.7 | 4 | 43.1 | True
imperial_19 | — | rack | A5-07 | Pens · markers ×8 | 1 | ok | 5 | 97 × 56 × 62 | 75.0 | 44.0 | 0.0 | 0 | Upright · standing on the bottom edge | 97.0 × 62.0 × 4.0 | 4 × Ø3.5 × 15 csk, head Ø8 | 5.0 | 97 × 62 × 5 · pilot Ø2.8 × 11.5: 6.5 into the studs | 97 × 62 × 23 | 33.1 | 19.5 | 4 | 85.7 | True
imperial_19 | — | clip | A5-08 | Test leads · cables | 1 | ok | 5 | 14 × 96 × 24 | 13.8 | 8.8 | 0.0 | 0 | On its side | 24.0 × 96.0 × 4.0 | 2 × Ø3.5 × 15 csk, head Ø8 | 2.9 | 24 × 96 × 5 · pilot Ø2.8 × 11.5: 6.5 into the studs | 24 × 96 × 23 | 13.8 | 8.6 | 3 | 28.1 | True
imperial_19 | mdrn | plate | A0-01 | Zone label plates ×6 | 6 | ok | 0 | 120 × 28 × 4 | 13.1 | 8.9 | 0.0 | 0 | Face down · studs up | 120.0 × 28.0 × 4.0 | 2 × Ø3.5 × 15 csk, head Ø8 | 2.1 | 120 × 28 × 5 · pilot Ø2.8 × 11.5: 6.5 into the studs | 120 × 28 × 23 | 18.3 | 11.1 | 2 | 0.0 | True
metric_4 | Kreg | hook | C8-01 | Rip-Cut rail · hooks ×2 | 2 | ok | 8 | 54 × 70 × 32 | 20.8 | 12.6 | 0.0 | 0 | On its side | 32.0 × 70.0 × 4.0 | 2 × Ø3.5 × 15 csk, head Ø8 | 5.3 | 32 × 70 × 5 · pilot Ø2.8 through; screws bite the panel, tip 2.0 proud behind | 32 × 70 × 18 | 11.4 | 7.0 | 2 | 247.0 | True
metric_4 | Kreg | tray | C8-02 | Pocket-hole jig | 1 | ok | 8 | 142 × 76 × 53 | 93.8 | 63.4 | 0.0 | 0 | Upright · standing on the bottom edge | 142.0 × 53.0 × 4.0 | 4 × Ø3.5 × 15 csk, head Ø8 | 14.2 | 142 × 53 × 5 · pilot Ø2.8 through; screws bite the panel, tip 2.0 proud behind | 142 × 53 × 18 | 38.5 | 22.6 | 5 | 65.2 | True
metric_4 | Kreg | hook | C8-03 | Clamp triangle | 1 | ok | 8 | 34 × 70 × 22 | 10.9 | 7.0 | 0.0 | 0 | On its side | 22.0 × 70.0 × 4.0 | 2 × Ø3.5 × 15 csk, head Ø8 | 4.7 | 22 × 70 × 5 · pilot Ø2.8 through; screws bite the panel, tip 2.0 proud behind | 22 × 70 × 18 | 7.9 | 5.0 | 2 | 143.1 | True
metric_4 | — | holster | C8-04 | Vernier caliper | 1 | ok | 8 | 32 × 37 × 94 | 27.0 | 16.1 | 0.0 | 0 | Upright · standing on the bottom edge | 32.0 × 94.0 × 4.0 | 2 × Ø3.5 × 15 csk, head Ø8 | 5.3 | 32 × 94 × 5 · pilot Ø2.8 through; screws bite the panel, tip 2.0 proud behind | 32 × 94 × 18 | 15.3 | 9.3 | 3 | 29.3 | True
metric_4 | — | magstrip | C8-05 | Rule 600 · strips ×2 | 2 | ok | 8 | 40 × 120 × 6 | 27.6 | 15.9 | 0.0 | 0 | Face down · studs up | 40.0 × 120.0 × 6.0 | 2 × Ø3.5 × 15 csk, head Ø8 | 6.1 | 40 × 120 × 5 · pilot Ø2.8 through; screws bite the panel, tip 0.0 proud behind | 40 × 120 × 18 | 24.1 | 14.3 | 2 | 249.0 | True
metric_4 | — | hook | C8-06 | Rule 1000 aluminium · hooks ×2 | 2 | ok | 8 | 39 × 70 × 37 | 20.1 | 12.2 | 0.0 | 0 | On its side | 37.0 × 70.0 × 4.0 | 2 × Ø3.5 × 15 csk, head Ø8 | 5.5 | 37 × 70 × 5 · pilot Ø2.8 through; screws bite the panel, tip 2.0 proud behind | 37 × 70 × 18 | 13.1 | 7.9 | 2 | 177.3 | True
metric_4 | — | hook | C9-01 | Dividers | 1 | ok | 9 | 34 × 70 × 19 | 9.1 | 6.0 | 0.0 | 0 | On its side | 18.8 × 70.0 × 4.0 | 2 × Ø3.5 × 15 csk, head Ø8 | 5.0 | 19 × 70 × 5 · pilot Ø2.8 through; screws bite the panel, tip 2.0 proud behind | 19 × 70 × 18 | 6.8 | 4.4 | 2 | 374.2 | True
metric_4 | — | magstrip | C9-02 | Rule 300 | 1 | ok | 9 | 40 × 120 × 6 | 27.6 | 15.9 | 0.0 | 0 | Face down · studs up | 40.0 × 120.0 × 6.0 | 2 × Ø3.5 × 15 csk, head Ø8 | 6.2 | 40 × 120 × 5 · pilot Ø2.8 through; screws bite the panel, tip 0.0 proud behind | 40 × 120 × 18 | 24.1 | 14.3 | 2 | 249.0 | True
metric_4 | — | rack | C9-03 | Compass · scribe · awl | 1 | ok | 9 | 66 × 32 × 72 | 33.4 | 20.2 | 0.0 | 0 | Upright · standing on the bottom edge | 66.0 × 72.0 × 4.0 | 4 × Ø3.5 × 15 csk, head Ø8 | 9.4 | 66 × 72 × 5 · pilot Ø2.8 through; screws bite the panel, tip 2.0 proud behind | 66 × 72 × 18 | 24.6 | 14.7 | 10 | 54.0 | True
metric_4 | Sky | hook | C9-04 | Utility blade packs ×2 | 1 | ok | 9 | 34 × 70 × 27 | 13.8 | 8.6 | 0.0 | 0 | On its side | 27.0 × 70.0 × 4.0 | 2 × Ø3.5 × 15 csk, head Ø8 | 5.2 | 27 × 70 × 5 · pilot Ø2.8 through; screws bite the panel, tip 2.0 proud behind | 27 × 70 × 18 | 9.6 | 6.0 | 2 | 144.3 | True
metric_4 | — | hook | C9-05 | Scraper | 1 | ok | 9 | 34 × 70 × 22 | 10.9 | 7.0 | 0.0 | 0 | On its side | 22.0 × 70.0 × 4.0 | 2 × Ø3.5 × 15 csk, head Ø8 | 5.6 | 22 × 70 × 5 · pilot Ø2.8 through; screws bite the panel, tip 2.0 proud behind | 22 × 70 × 18 | 7.9 | 5.0 | 2 | 141.4 | True
metric_4 | — | hook | C10-01 | Masking tape rolls ×3 | 1 | ok | 10 | 114 × 70 × 26 | 41.8 | 20.4 | 0.0 | 0 | On its side | 26.0 × 70.0 × 4.0 | 2 × Ø3.5 × 15 csk, head Ø8 | 4.3 | 26 × 70 × 5 · pilot Ø2.8 through; screws bite the panel, tip 2.0 proud behind | 26 × 70 × 18 | 9.3 | 5.8 | 2 | 389.1 | True
metric_4 | — | hook | C10-02 | Double-sided tape ×2 | 1 | ok | 10 | 74 × 70 × 26 | 30.0 | 15.2 | 0.0 | 0 | On its side | 26.0 × 70.0 × 4.0 | 2 × Ø3.5 × 15 csk, head Ø8 | 4.8 | 26 × 70 × 5 · pilot Ø2.8 through; screws bite the panel, tip 2.0 proud behind | 26 × 70 × 18 | 9.3 | 5.8 | 2 | 312.5 | True
metric_4 | Bostik | hook | C10-03 | Glue dots · sticker packs | 1 | ok | 10 | 34 × 70 × 22 | 10.9 | 7.0 | 0.0 | 0 | On its side | 22.0 × 70.0 × 4.0 | 2 × Ø3.5 × 15 csk, head Ø8 | 4.4 | 22 × 70 × 5 · pilot Ø2.8 through; screws bite the panel, tip 2.0 proud behind | 22 × 70 × 18 | 7.9 | 5.0 | 2 | 142.0 | True
metric_4 | — | hook | C10-04 | Brush 100 | 1 | ok | 10 | 39 × 70 × 27 | 14.6 | 9.1 | 0.0 | 0 | On its side | 27.0 × 70.0 × 4.0 | 2 × Ø3.5 × 15 csk, head Ø8 | 5.1 | 27 × 70 × 5 · pilot Ø2.8 through; screws bite the panel, tip 2.0 proud behind | 27 × 70 × 18 | 9.6 | 6.0 | 2 | 171.4 | True
metric_4 | — | tray | C10-05 | Sanding block | 1 | ok | 10 | 78 × 40 × 53 | 35.0 | 24.9 | 0.0 | 0 | Upright · standing on the bottom edge | 78.0 × 53.0 × 4.0 | 2 × Ø3.5 × 15 csk, head Ø8 | 7.3 | 78 × 53 × 5 · pilot Ø2.8 through; screws bite the panel, tip 2.0 proud behind | 78 × 53 × 18 | 21.0 | 12.4 | 2 | 46.4 | True
metric_4 | mdrn | plate | C0-01 | Zone label plates ×5 | 5 | ok | 0 | 120 × 28 × 4 | 13.1 | 8.9 | 0.0 | 0 | Face down · studs up | 120.0 × 28.0 × 4.0 | 2 × Ø3.5 × 15 csk, head Ø8 | 5.5 | 120 × 28 × 5 · pilot Ø2.8 through; screws bite the panel, tip 2.0 proud behind | 120 × 28 × 18 | 17.1 | 10.4 | 2 | 0.0 | True
metric_4 | — | gridfinity | C12-01 | Gridfinity 2×1 shelf ×4 | 4 | ok | 12 | 88 × 49 × 51 | 52.4 | 30.8 | 0.0 | 0 | Upright · standing on the bottom edge | 88.0 × 51.0 × 4.0 | 3 × Ø3.5 × 15 csk, head Ø8 | 10.0 | 88 × 51 × 5 · pilot Ø2.8 through; screws bite the panel, tip 2.0 proud behind | 88 × 51 × 18 | 22.9 | 13.6 | 3 | 62.0 | True
metric_4 | — | hook | B13-01 | F-clamps ×4 | 4 | ok | 13 | 54 × 70 × 32 | 23.8 | 13.7 | 0.0 | 0 | On its side | 32.0 × 70.0 × 4.0 | 2 × Ø3.5 × 15 csk, head Ø8 | 4.5 | 32 × 70 × 5 · pilot Ø2.8 through; screws bite the panel, tip 2.0 proud behind | 32 × 70 × 18 | 11.4 | 7.0 | 2 | 245.9 | True
metric_4 | — | hook | B13-02 | Straightedge 1000 · hooks ×2 | 2 | ok | 13 | 39 × 70 × 37 | 20.1 | 12.2 | 0.0 | 0 | On its side | 37.0 × 70.0 × 4.0 | 2 × Ø3.5 × 15 csk, head Ø8 | 5.6 | 37 × 70 × 5 · pilot Ø2.8 through; screws bite the panel, tip 2.0 proud behind | 37 × 70 × 18 | 13.1 | 7.9 | 2 | 176.1 | True
metric_4 | — | hook | B13-03 | Pull saw · hand saws ×2 | 2 | ok | 13 | 44 × 70 × 32 | 18.7 | 11.4 | 0.0 | 0 | On its side | 32.0 × 70.0 × 4.0 | 2 × Ø3.5 × 15 csk, head Ø8 | 4.8 | 32 × 70 × 5 · pilot Ø2.8 through; screws bite the panel, tip 2.0 proud behind | 32 × 70 × 18 | 11.4 | 7.0 | 2 | 203.3 | True
metric_4 | — | hook | B13-04 | Extension cord (coiled) | 1 | ok | 13 | 47 × 64 × 96 | 45.1 | 25.5 | 0.0 | 0 | Upright · standing on the bottom edge | 47.0 × 96.0 × 4.0 | 3 × Ø3.5 × 15 csk, head Ø8 | 6.1 | 47 × 96 × 5 · pilot Ø2.8 through; screws bite the panel, tip 2.0 proud behind | 47 × 96 × 18 | 22.8 | 13.4 | 3 | 43.9 | True
metric_4 | mdrn | plate | B0-01 | Zone label plates ×3 | 3 | ok | 0 | 150 × 36 × 4 | 21.2 | 14.1 | 0.0 | 0 | Face down · studs up | 150.0 × 36.0 × 4.0 | 2 × Ø3.5 × 15 csk, head Ø8 | 6.5 | 150 × 36 × 5 · pilot Ø2.8 through; screws bite the panel, tip 2.0 proud behind | 150 × 36 × 18 | 27.3 | 16.2 | 2 | 0.0 | True
metric_4 | — | gridfinity | B14-01 | Gridfinity 4×1 shelf ×7 | 7 | ok | 14 | 172 × 50 × 53 | 80.2 | 51.8 | 0.0 | 0 | Upright · standing on the bottom edge | 172.0 × 52.5 × 4.0 | 4 × Ø3.5 × 15 csk, head Ø8 | 18.9 | 172 × 52 × 5 · pilot Ø2.8 through; screws bite the panel, tip 2.0 proud behind | 172 × 53 × 18 | 46.2 | 27.1 | 6 | 153.9 | True
