mdrndesigns/pegboardlab/plan/boardA/placement.csv

n | id | tool | parts | columns | row
1 | B-GSR | GSR 120-LI drill | 2 × A80 | 2 + 5 | 3
2 | B-GWS | GWS 12V-76 grinder | 2 × A80 | 9 + 12 | 3
3 | B-SMALL | Small bit box | 2 × A40 | 9 + 12 | 12
4 | B-GKS | GKS 12V-26 saw | 2 × F100 + S-SAW | 1 + 6 | 16
5 | B-BITS | Drill-bit box | 2 × A40 | 8 + 12 | 16
6 | B-CASE | Bosch blue case | 2 × A60 | 3 + 9 | 21
7 | B-GRO | GRO 12V-35 | 2 × C56 | 2 + 8 | 25
8 | B-GLUE | GluePen | 2 × C38 | 2 + 6 | 28
9 | SCISS | Scissors | N30 | 4 | 30
10 | MICRO | Micrometer 0-25 | N30 | 8 | 31
11 | PROTR | Protractor + rule | N30 | 12 | 29
12 | R-MEAS | Caliper · tape · markers · scriber | 2 × F60 + R-MEAS | 1 + 11 | 41
13 | TOOLCHK | Wera Tool-Check PLUS | 2 × A60 | 20 + 26 | 5
14 | R-HEX | Wera Hex-Plus L-keys ×9 | 2 × F60 + R-HEX | 20 + 28 | 8
15 | WRENCH | Adjustable wrench 200 | N30 | 15 | 8
16 | SPAN | Spanner | N30 | 18 | 8
17 | R-DRV | Drivers: Irwin · chisel · awl · knife + Wera ×6 | 2 × F60 + R-DRV | 14 + 28 | 23
18 | R-PLI-2 | Cutters / crimpers ×4 · snips · nipper | 2 × F60 + R-PLI | 16 + 28 | 33
19 | R-PLI-1 | Pliers ×4 · 1 cutter · spare | 2 × F60 + R-PLI | 16 + 28 | 44
