mdrndesigns/pegboardlab/plan/wera_bike12/WERA-BIKE12_assembly.step

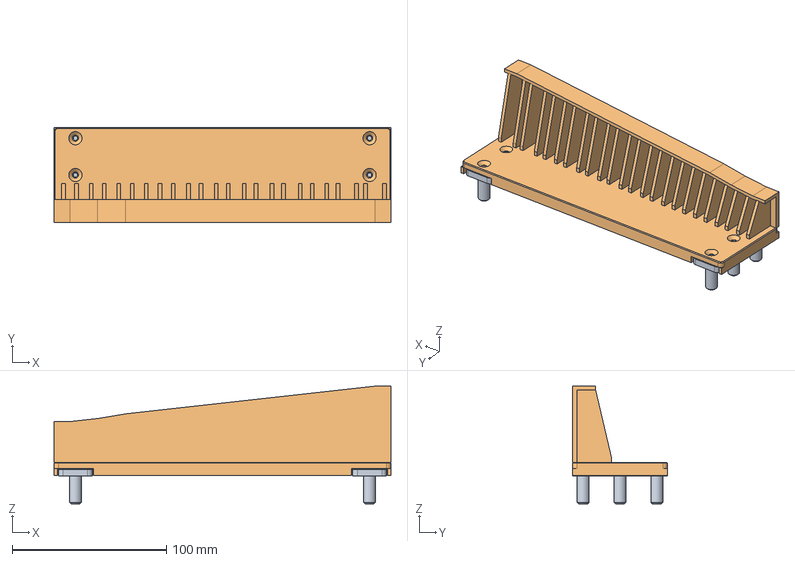
[picture p51: CAD file, 2026-11-13]
plan/wera_bike12/WERA-BIKE12_assembly.step
218.8 x 61.8 x 76.4 mm
