mdrndesigns/pegboardlab/plan/handtools/R-DRV_assembly.step

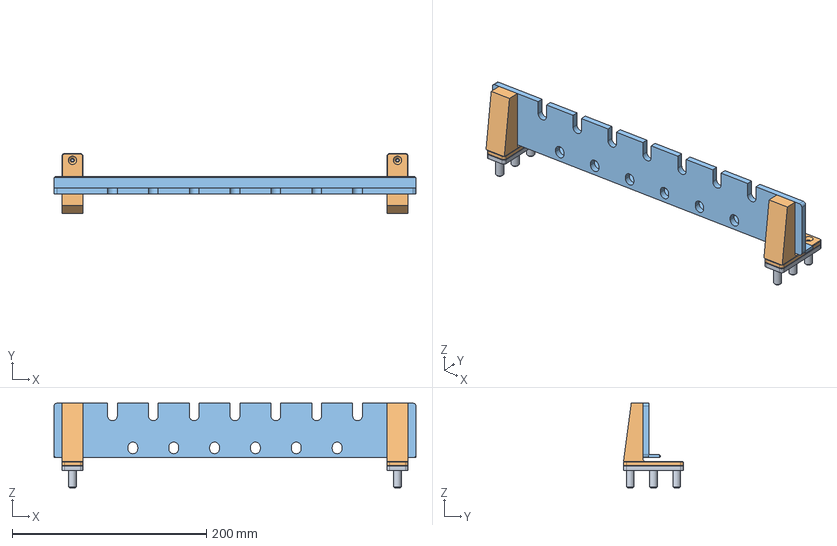
[picture p52: CAD file, 2026-11-13]
plan/handtools/R-DRV_assembly.step
372.3 x 61.8 x 87.0 mm
