mdrndesigns/pegboardlab/plan/precision/SOCKET_assembly.step

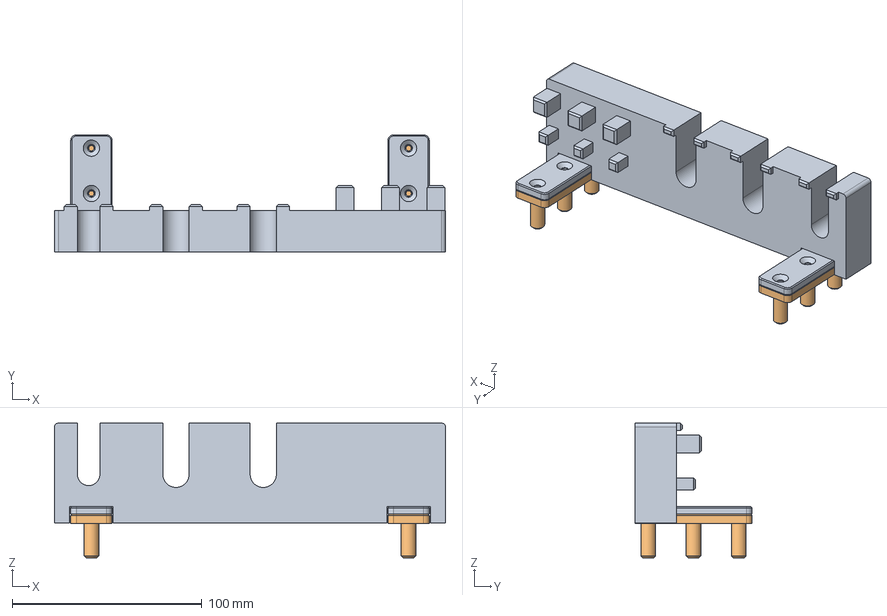
[picture p53: CAD file, 2026-11-13]
plan/precision/SOCKET_assembly.step
206.0 x 61.8 x 71.0 mm
