mdrndesigns/pegboardlab/plan/handtools/R-PLI_assembly.step

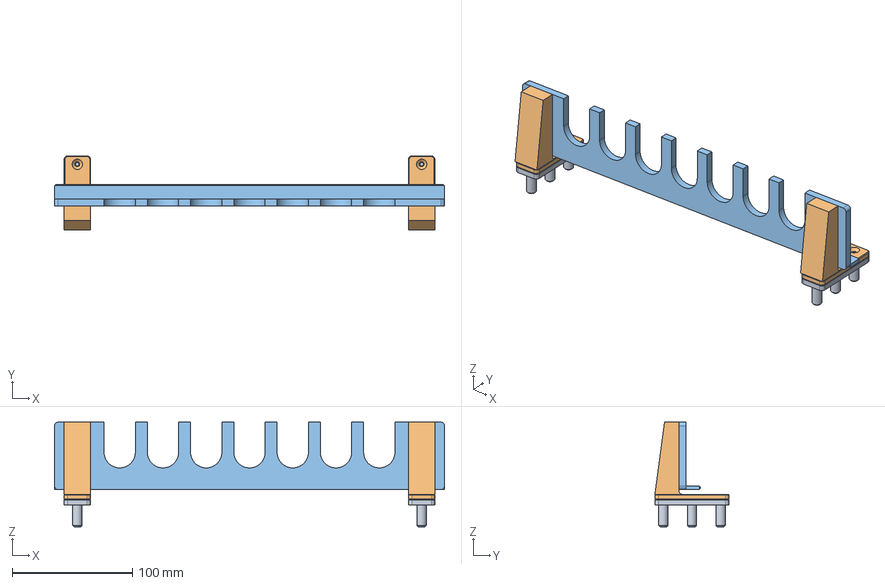
[picture p54: CAD file, 2026-11-13]
plan/handtools/R-PLI_assembly.step
324.5 x 61.8 x 87.0 mm
