mdrndesigns/pegboardlab/plan/precision/RULE_assembly.step

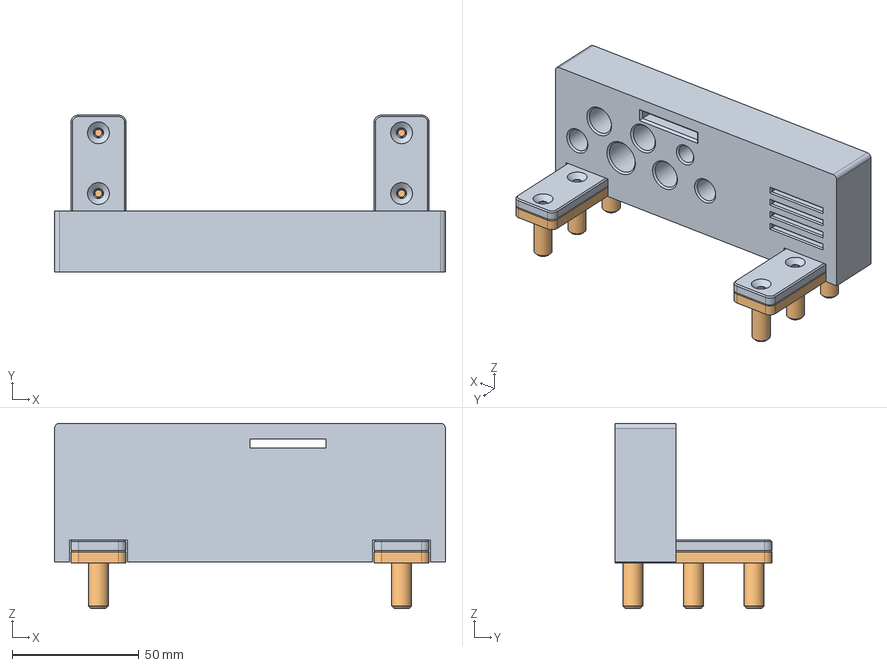
[picture p55: CAD file, 2026-11-13]
plan/precision/RULE_assembly.step
154.0 x 61.8 x 73.0 mm
