mdrndesigns/pegboardlab/plan/precision/WRENCH_assembly.step

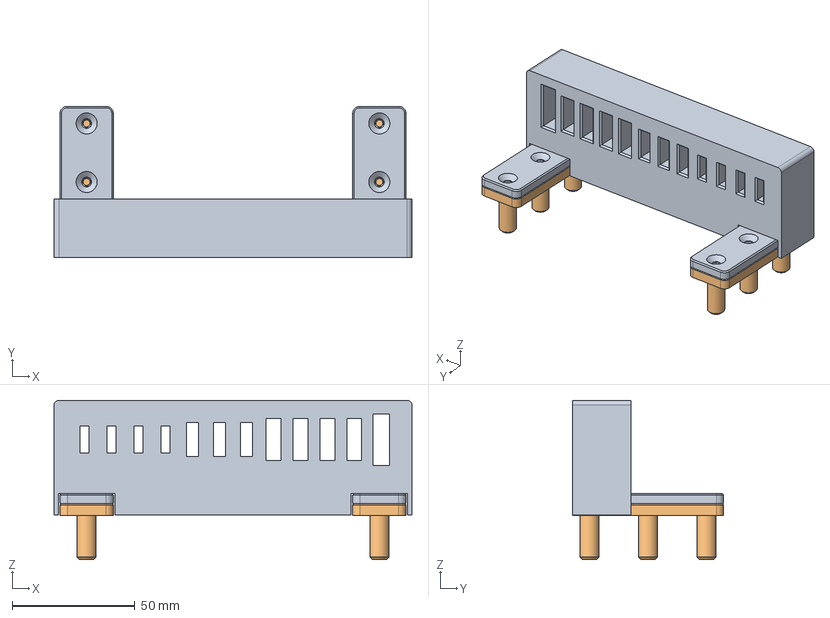
[picture p56: CAD file, 2026-11-13]
plan/precision/WRENCH_assembly.step
146.0 x 61.8 x 65.0 mm
