mdrndesigns/pegboardlab/plan/bosch12v/S-SAW_assembly.step

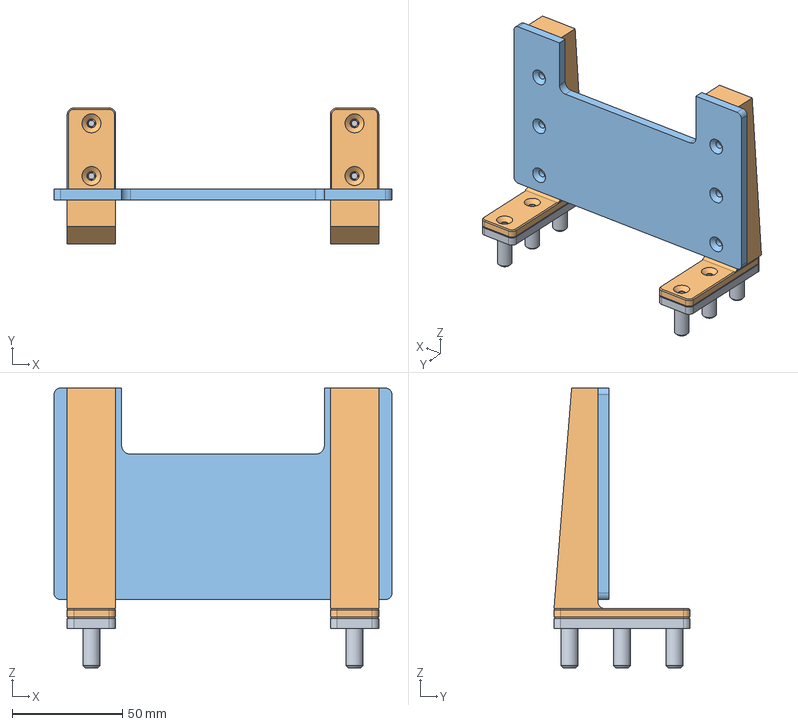
[picture p57: CAD file, 2026-11-13]
plan/bosch12v/S-SAW_assembly.step
153.4 x 61.8 x 127.0 mm
