mdrndesigns/pegboardlab/plan/bosch12v/S-60_assembly.step

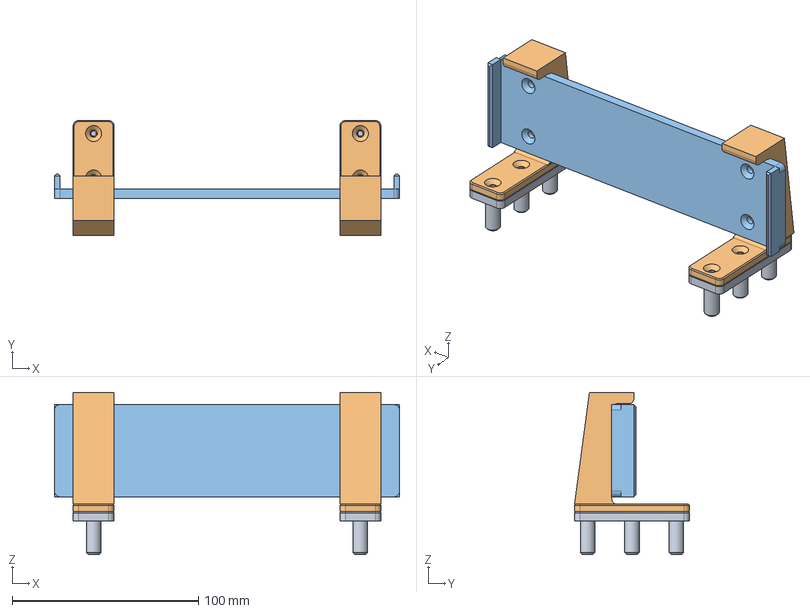
[picture p58: CAD file, 2026-11-13]
plan/bosch12v/S-60_assembly.step
185.3 x 61.8 x 87.0 mm
