mdrndesigns/pegboardlab/plan/bosch12v/F100.3mf

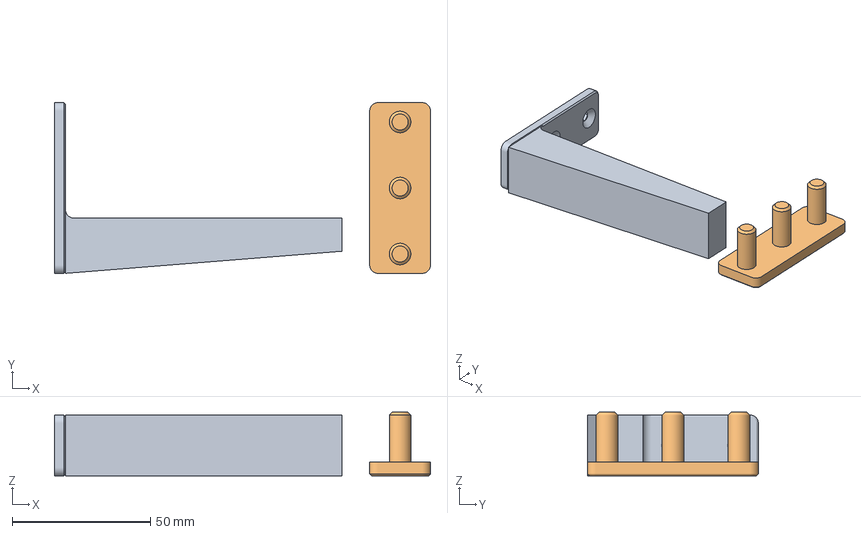
[picture p59: CAD file, 2026-11-13]
plan/bosch12v/F100.3mf
136.0 x 61.8 x 23.0 mm
F100_holder
F100_spine
