mdrndesigns/pegboardlab/plan/handtools/R-HEX_base.stl

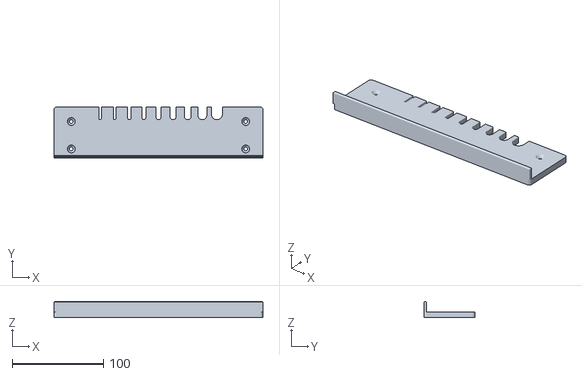
[picture p60: CAD file, 2026-11-13]
plan/handtools/R-HEX_base.stl
229.0 x 56.0 x 18.0
