mdrndesigns/pegboardlab/plan/precision/WRENCH.3mf

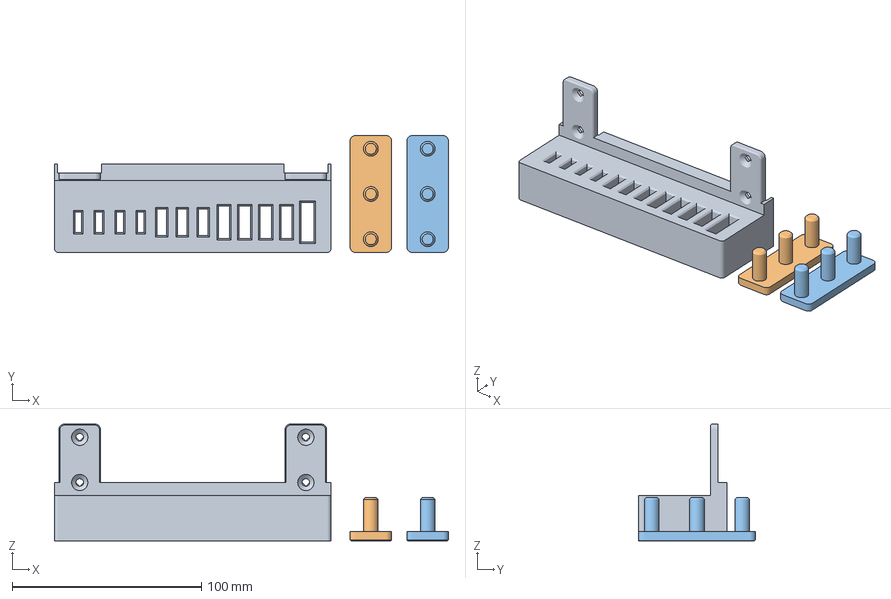
[picture p61: CAD file, 2026-11-13]
plan/precision/WRENCH.3mf
208.0 x 61.8 x 61.8 mm
WRENCH_holder
WRENCH_spine1
WRENCH_spine2
