mdrndesigns/pegboardlab/samples/split_rack_driver.3mf

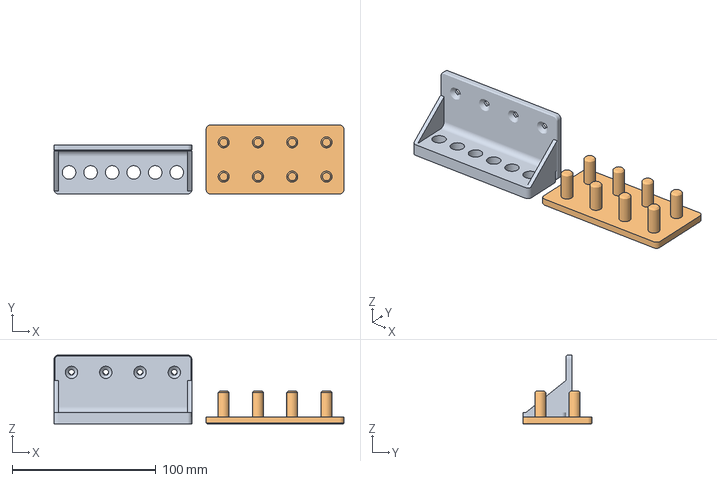
[picture p62: CAD file, 2026-11-13]
samples/split_rack_driver.3mf
202.0 x 48.0 x 48.0 mm
split_rack_holder
split_rack_spine
