mdrndesigns/pegboardlab/plan/bosch12v/C56.3mf

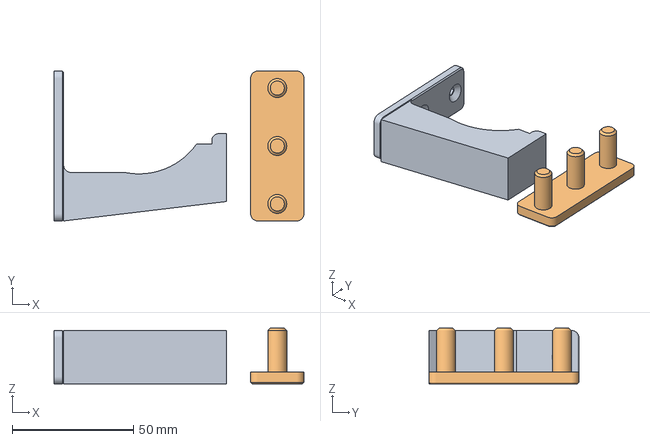
[picture p63: CAD file, 2026-11-13]
plan/bosch12v/C56.3mf
103.0 x 61.8 x 23.0 mm
C56_holder
C56_spine
