mdrndesigns/pegboardlab/plan/handtools/R-DRV.3mf

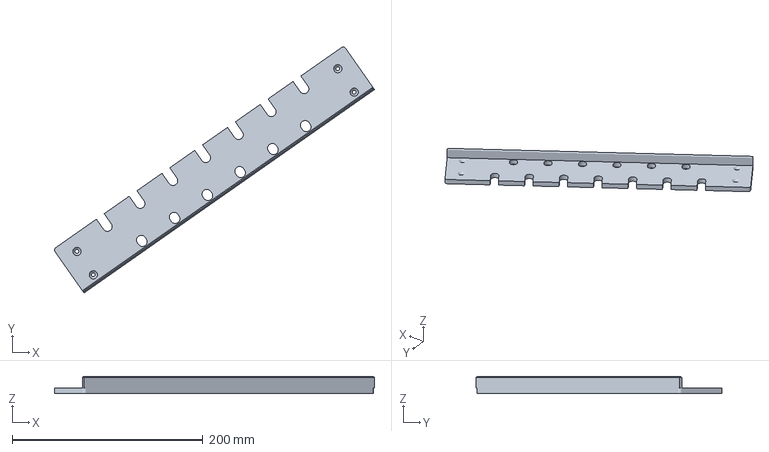
[picture p64: CAD file, 2026-11-13]
plan/handtools/R-DRV.3mf
335.9 x 258.2 x 18.0 mm
