mdrndesigns/pegboardlab/plan/precision/RULE.3mf

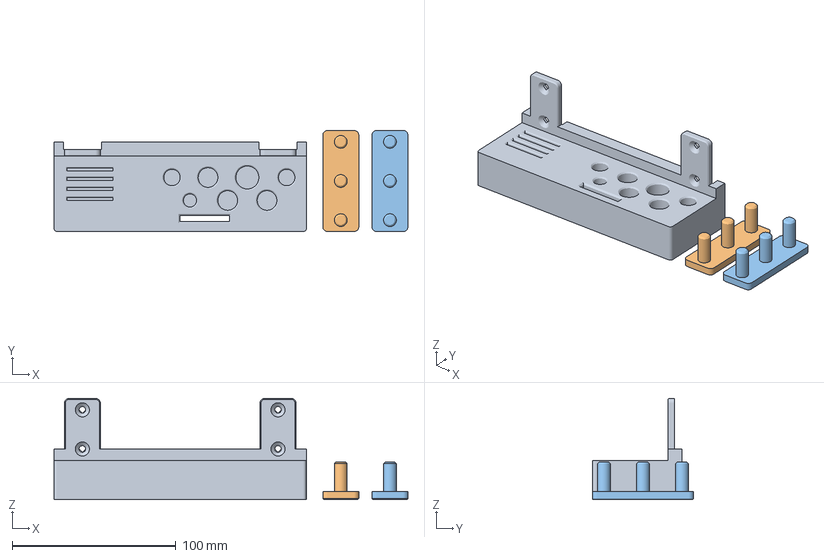
[picture p65: CAD file, 2026-11-13]
plan/precision/RULE.3mf
216.0 x 61.8 x 61.8 mm
RULE_holder
RULE_spine1
RULE_spine2
