mdrndesigns/pegboardlab/plan/wera_bike12/WERA-BIKE12_holder.stl

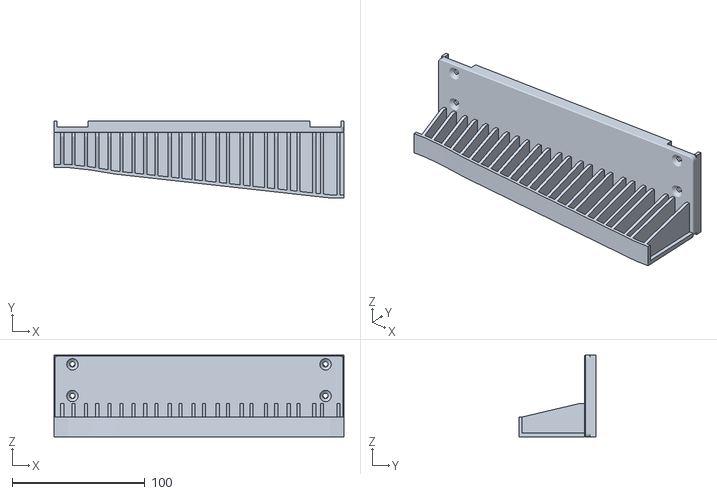
[picture p66: CAD file, 2026-11-13]
plan/wera_bike12/WERA-BIKE12_holder.stl
218.8 x 58.1 x 61.8
