mdrndesigns/pegboardlab/plan/bosch12v/C38.3mf

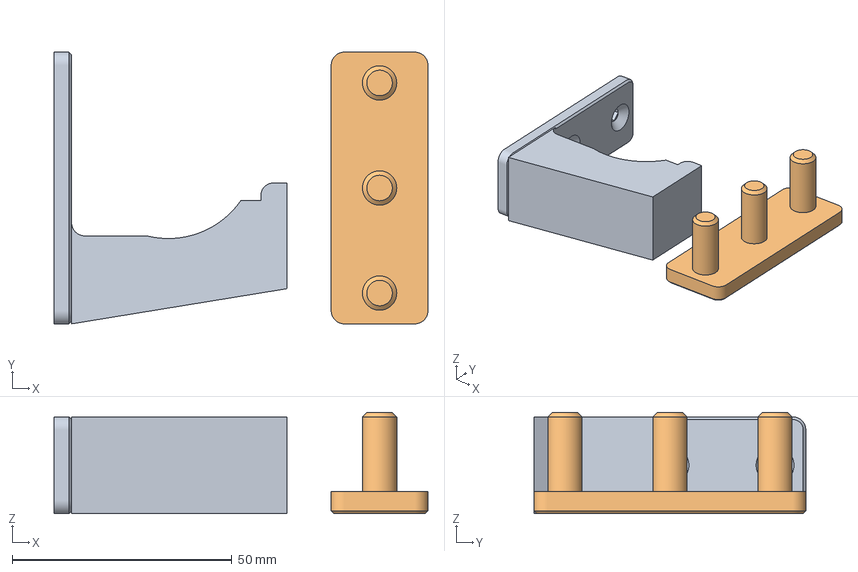
[picture p67: CAD file, 2026-11-13]
plan/bosch12v/C38.3mf
85.0 x 61.8 x 23.0 mm
C38_holder
C38_spine
