mdrndesigns/pegboardlab/plan/handtools/A60_spine.stl

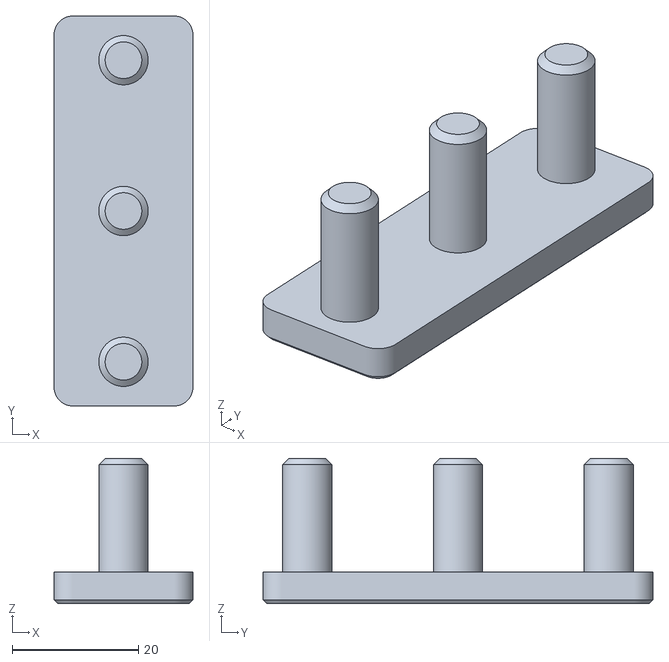
[picture p68: CAD file, 2026-11-13]
plan/handtools/A60_spine.stl
22.0 x 61.8 x 23.0
