mdrndesigns/pegboardlab/plan/precision/CAL-MF.3mf

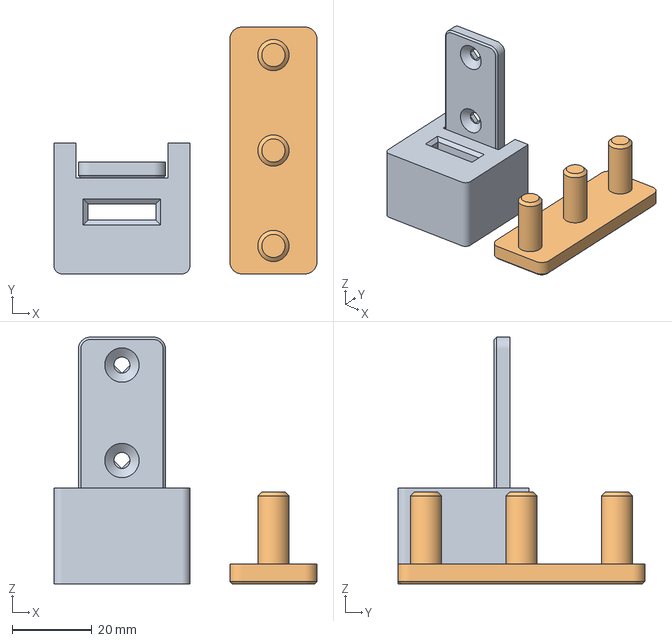
[picture p69: CAD file, 2026-11-13]
plan/precision/CAL-MF.3mf
65.8 x 61.8 x 61.8 mm
CAL-MF_holder
CAL-MF_spine
