mdrndesigns/pegboardlab/plan/wera_bike12/WERA-BIKE12.3mf

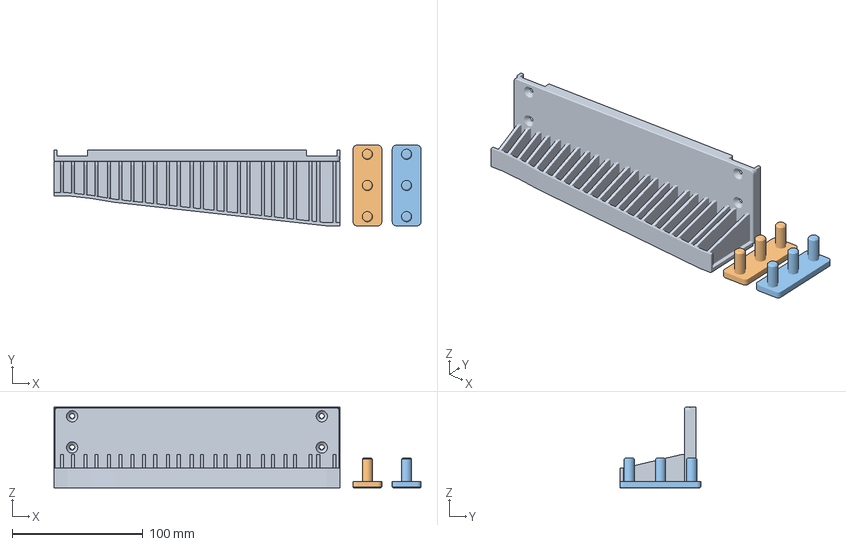
[picture p70: CAD file, 2026-11-13]
plan/wera_bike12/WERA-BIKE12.3mf
280.8 x 61.8 x 61.8 mm
WERA-BIKE12_holder
WERA-BIKE12_spine1
WERA-BIKE12_spine2
