mdrndesigns/pegboardlab/plan/bosch12v/C38_holder.stl

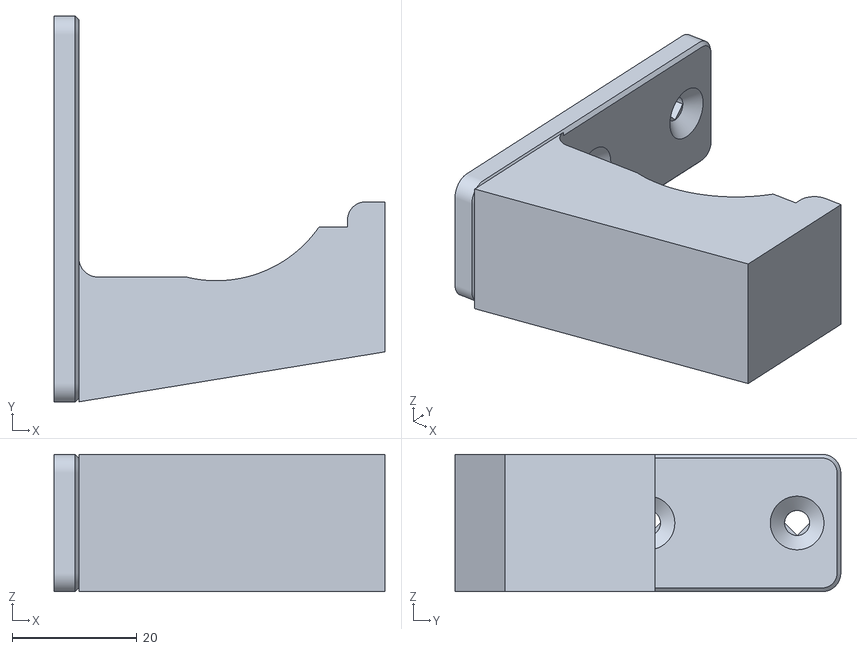
[picture p71: CAD file, 2026-11-13]
plan/bosch12v/C38_holder.stl
53.0 x 61.8 x 22.0
