mdrndesigns/pegboardlab/plan/handtools/A60.3mf

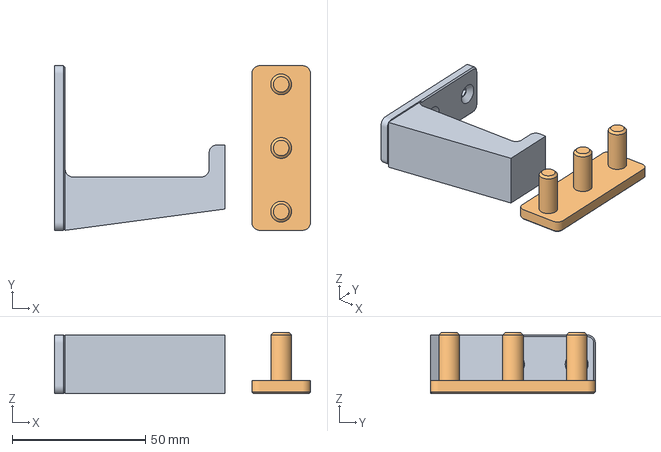
[picture p72: CAD file, 2026-11-13]
plan/handtools/A60.3mf
96.0 x 61.8 x 23.0 mm
A60_holder
A60_spine
