mdrndesigns/pegboardlab/plan/precision/CAL-MF_holder.stl

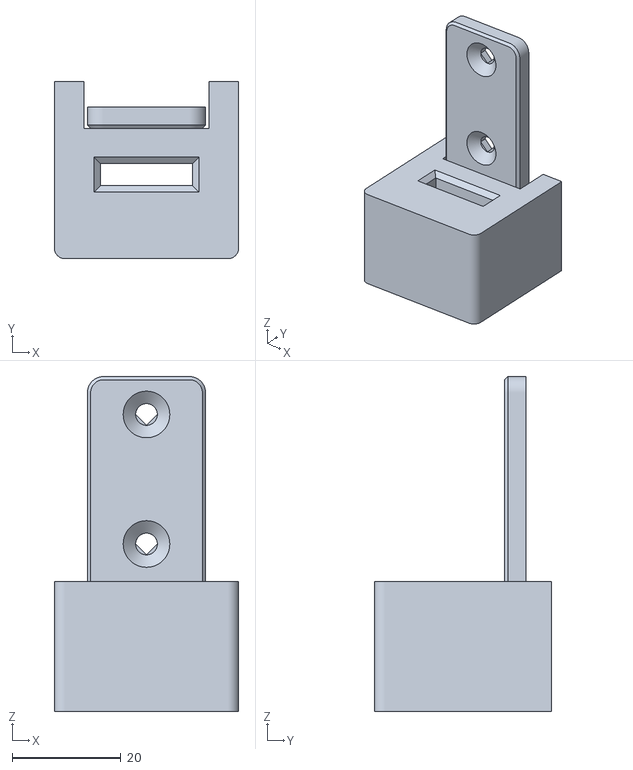
[picture p73: CAD file, 2026-11-13]
plan/precision/CAL-MF_holder.stl
34.0 x 32.7 x 61.8
