mdrndesigns/pegboardlab/plan/precision/WRENCH_holder.stl

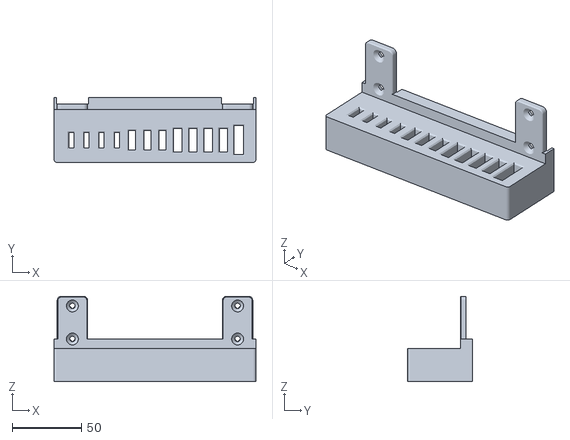
[picture p74: CAD file, 2026-11-13]
plan/precision/WRENCH_holder.stl
146.0 x 46.7 x 61.8
