mdrndesigns/pegboardlab/plan/handtools/A60_holder.stl

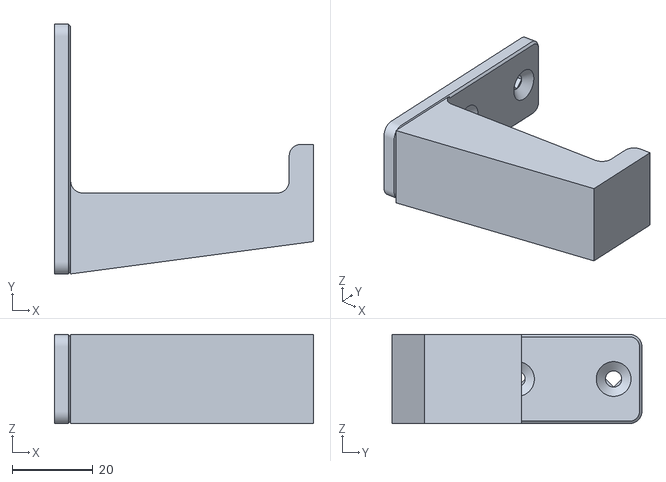
[picture p75: CAD file, 2026-11-13]
plan/handtools/A60_holder.stl
64.0 x 61.8 x 22.0
