mdrndesigns/pegboardlab/plan/bosch12v/A80.3mf

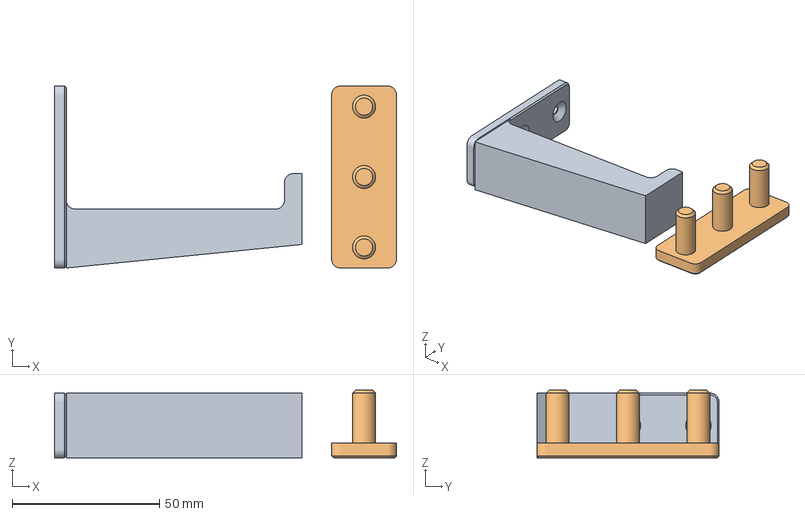
[picture p76: CAD file, 2026-11-13]
plan/bosch12v/A80.3mf
116.0 x 61.8 x 23.0 mm
A80_holder
A80_spine
