mdrndesigns/pegboardlab/plan/handtools/N30_holder.stl

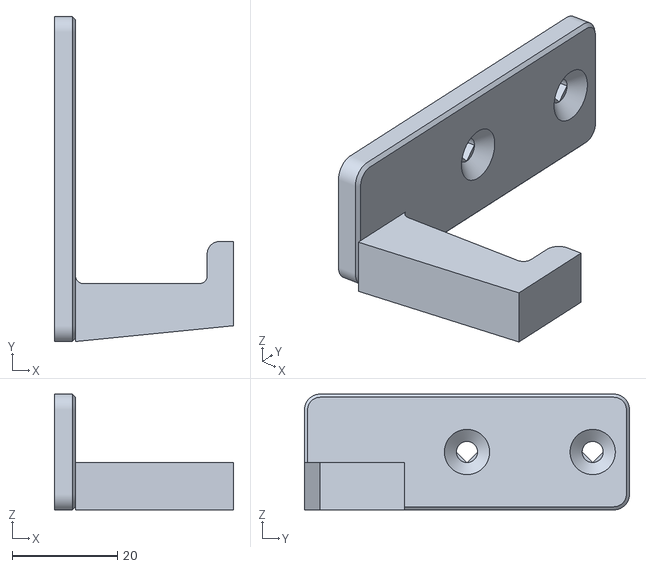
[picture p77: CAD file, 2026-11-13]
plan/handtools/N30_holder.stl
34.0 x 61.8 x 22.0
