mdrndesigns/pegboardlab/plan/precision/MIC.3mf

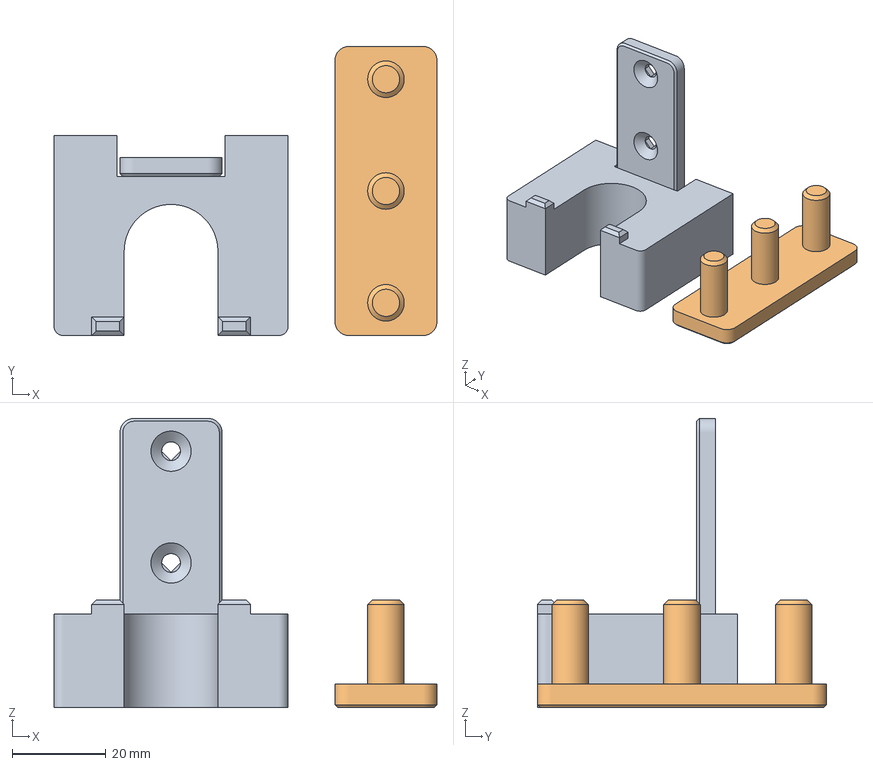
[picture p78: CAD file, 2026-11-13]
plan/precision/MIC.3mf
81.8 x 61.8 x 61.8 mm
MIC_holder
MIC_spine
