mdrndesigns/pegboardlab/plan/bosch12v/A40_holder.stl

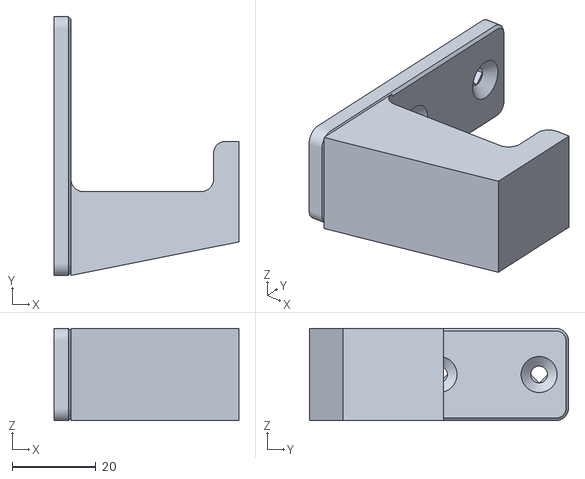
[picture p79: CAD file, 2026-11-13]
plan/bosch12v/A40_holder.stl
44.0 x 61.8 x 22.0
