mdrndesigns/pegboardlab/plan/handtools/F60.3mf

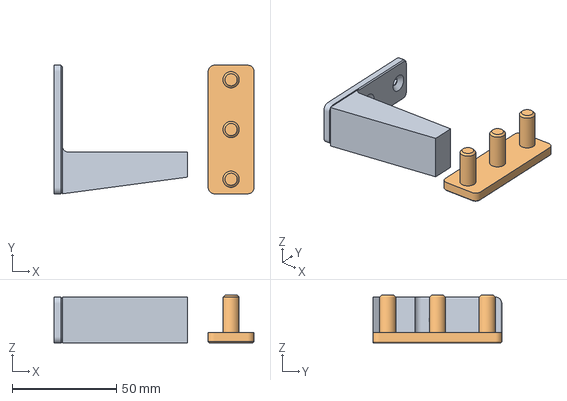
[picture p80: CAD file, 2026-11-13]
plan/handtools/F60.3mf
96.0 x 61.8 x 23.0 mm
F60_holder
F60_spine
