mdrndesigns/pegboardlab/plan/bosch12v/A80_holder.stl

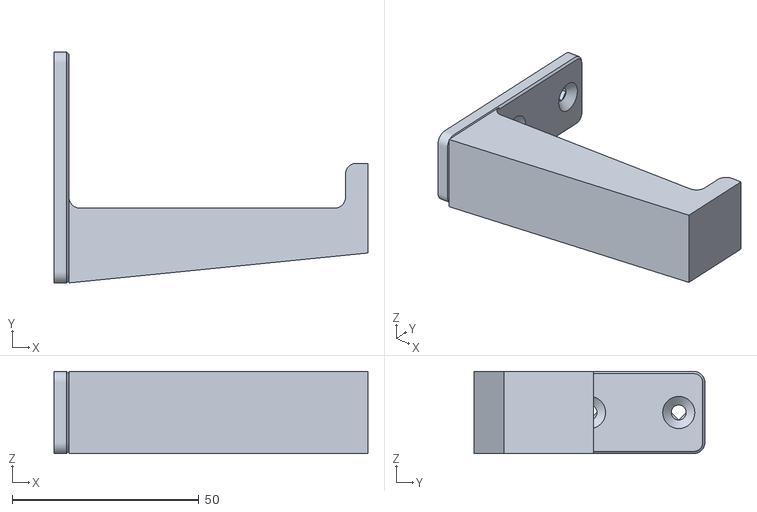
[picture p81: CAD file, 2026-11-13]
plan/bosch12v/A80_holder.stl
84.0 x 61.8 x 22.0
