mdrndesigns/pegboardlab/plan/precision/CAL-DF_holder.stl

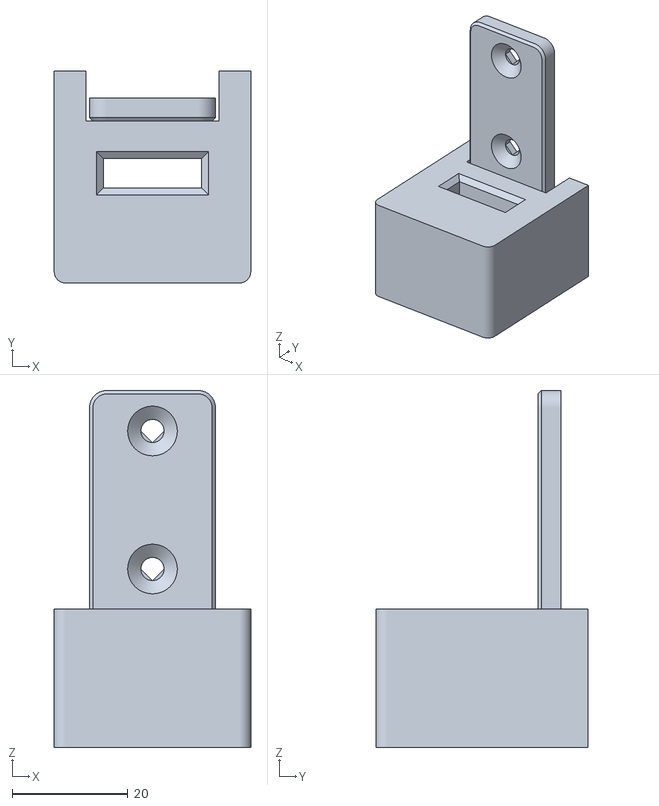
[picture p82: CAD file, 2026-11-13]
plan/precision/CAL-DF_holder.stl
34.0 x 36.7 x 61.8
