mdrndesigns/pegboardlab/plan/bosch12v/S-SAW_base.stl

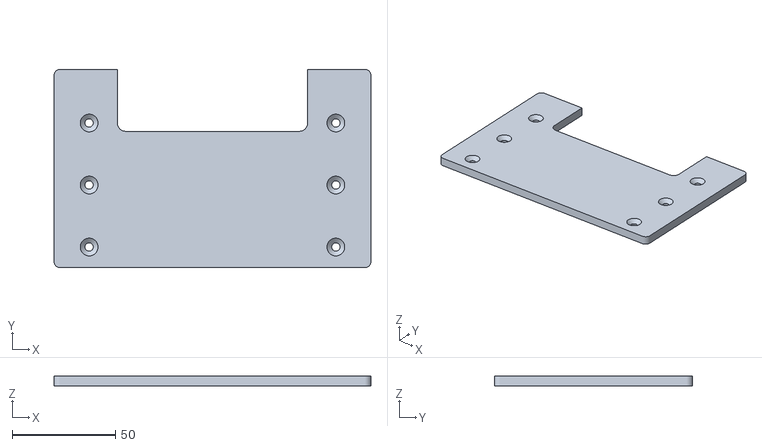
[picture p83: CAD file, 2026-11-13]
plan/bosch12v/S-SAW_base.stl
153.4 x 96.0 x 5.00
