mdrndesigns/pegboardlab/plan/precision/SOCKET.3mf

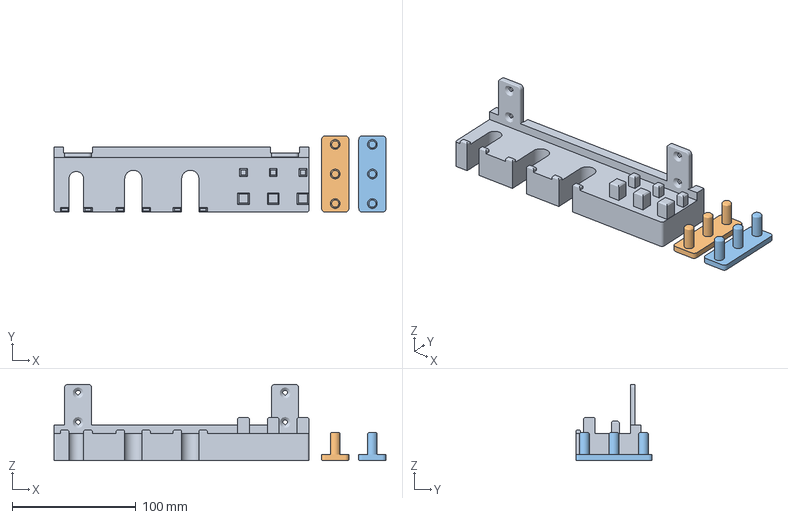
[picture p84: CAD file, 2026-11-13]
plan/precision/SOCKET.3mf
268.0 x 61.8 x 61.8 mm
SOCKET_holder
SOCKET_spine1
SOCKET_spine2
