mdrndesigns/pegboardlab/plan/handtools/R-MEAS_base.stl

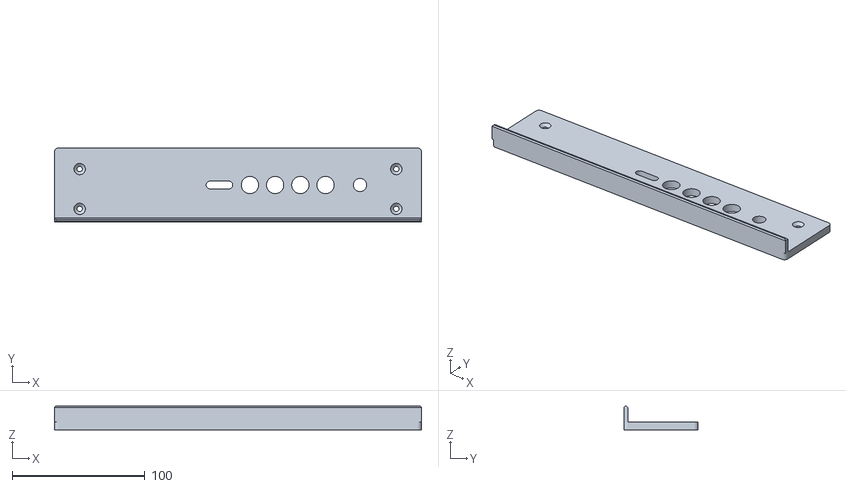
[picture p85: CAD file, 2026-11-13]
plan/handtools/R-MEAS_base.stl
276.8 x 56.0 x 18.0
