mdrndesigns/pegboardlab/plan/precision/MIC_holder.stl

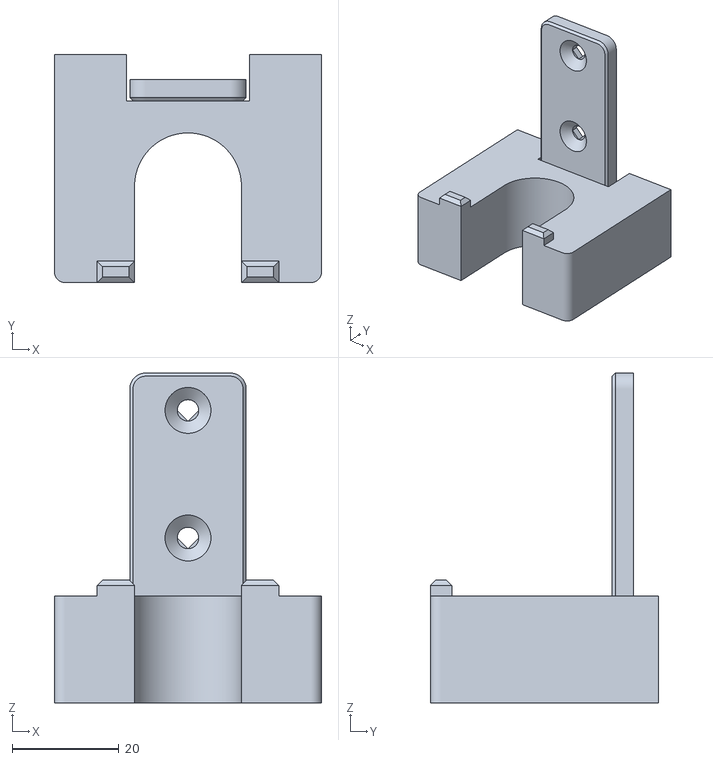
[picture p86: CAD file, 2026-11-13]
plan/precision/MIC_holder.stl
50.0 x 42.7 x 61.8
