mdrndesigns/pegboardlab/plan/bosch12v/S-60_base.stl

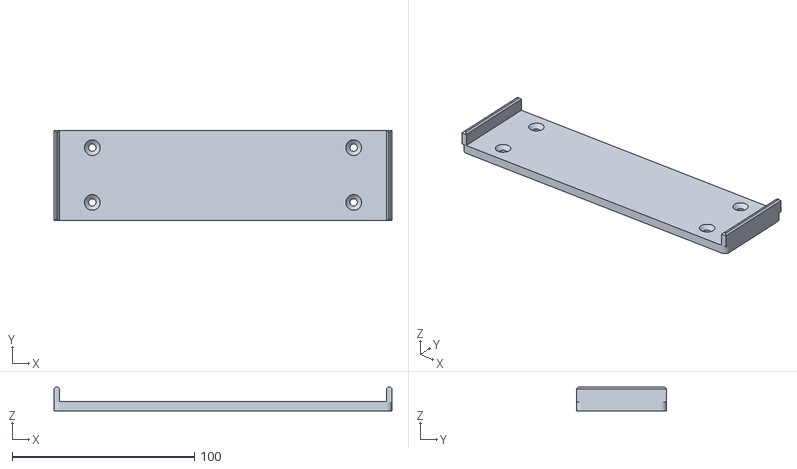
[picture p87: CAD file, 2026-11-13]
plan/bosch12v/S-60_base.stl
185.3 x 49.5 x 13.0
