mdrndesigns/pegboardlab/plan/handtools/N30.3mf

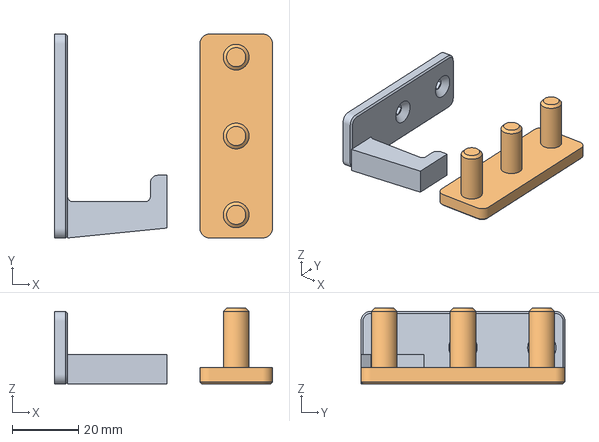
[picture p88: CAD file, 2026-11-13]
plan/handtools/N30.3mf
66.0 x 61.8 x 23.0 mm
N30_holder
N30_spine
