mdrndesigns/pegboardlab/plan/bosch12v/F100_holder.stl

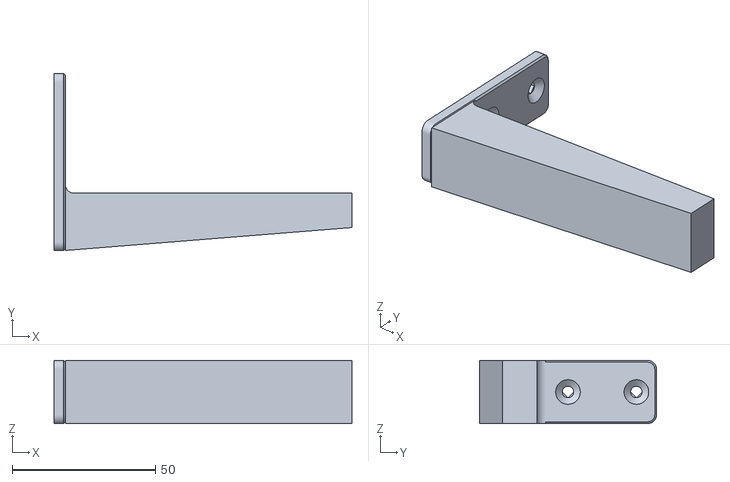
[picture p89: CAD file, 2026-11-13]
plan/bosch12v/F100_holder.stl
104.0 x 61.8 x 22.0
