mdrndesigns/pegboardlab/plan/precision/SOCKET_holder.stl

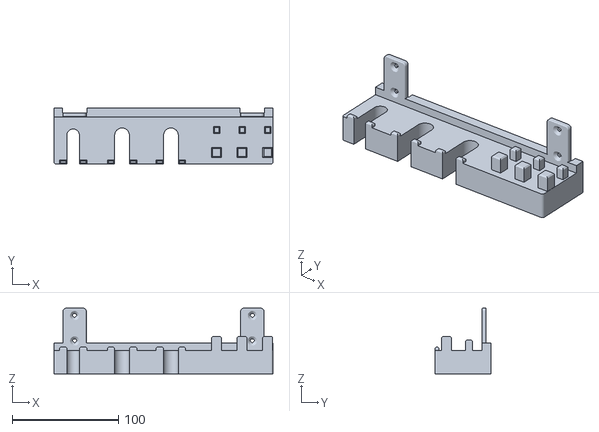
[picture p90: CAD file, 2026-11-13]
plan/precision/SOCKET_holder.stl
206.0 x 52.7 x 61.8
