mdrndesigns/pegboardlab/plan/bosch12v/A40.3mf

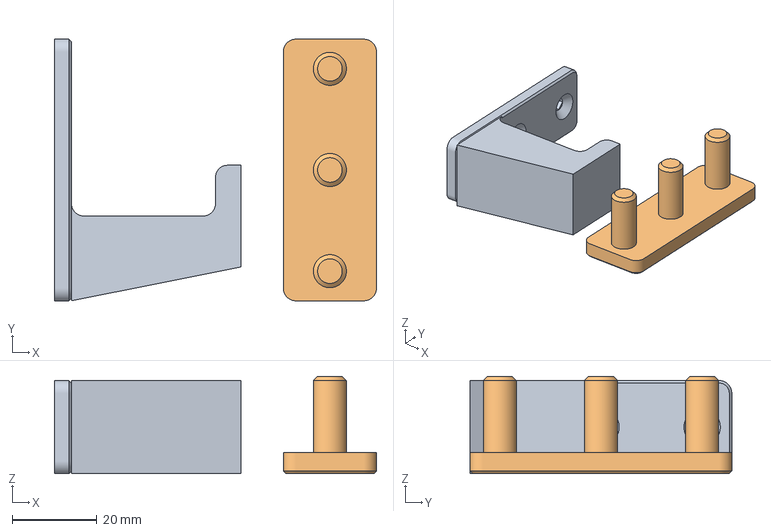
[picture p91: CAD file, 2026-11-13]
plan/bosch12v/A40.3mf
76.0 x 61.8 x 23.0 mm
A40_holder
A40_spine
