mdrndesigns/pegboardlab/plan/handtools/R-PLI_base.stl

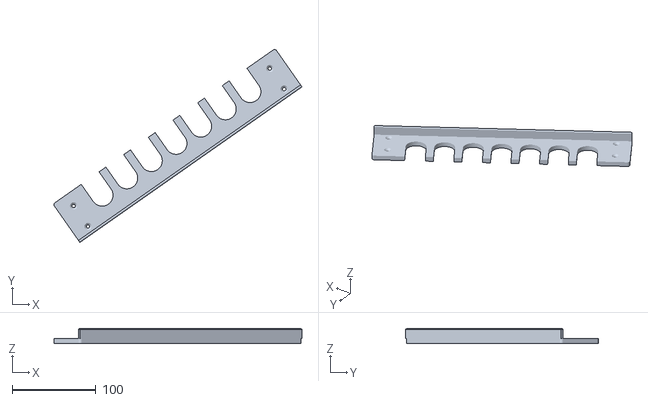
[picture p92: CAD file, 2026-11-13]
plan/handtools/R-PLI_base.stl
296.8 x 230.8 x 18.0
