mdrndesigns/pegboardlab/plan/precision/CAL-DF.3mf

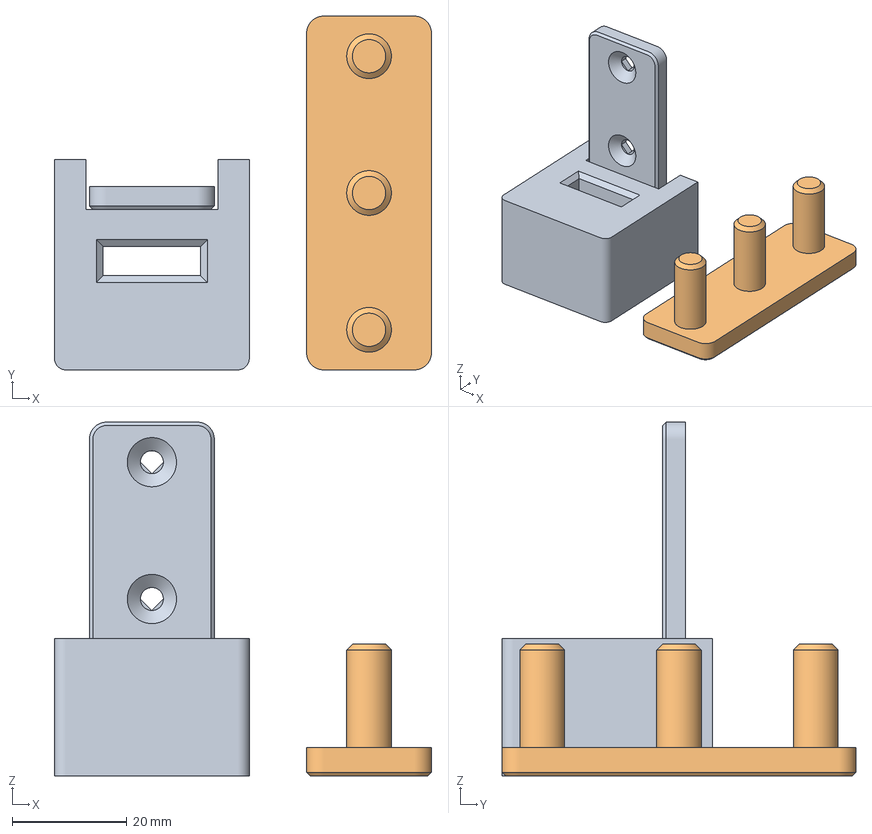
[picture p93: CAD file, 2026-11-13]
plan/precision/CAL-DF.3mf
65.8 x 61.8 x 61.8 mm
CAL-DF_holder
CAL-DF_spine
