mdrndesigns/pegboardlab/plan/precision/RULE_holder.stl

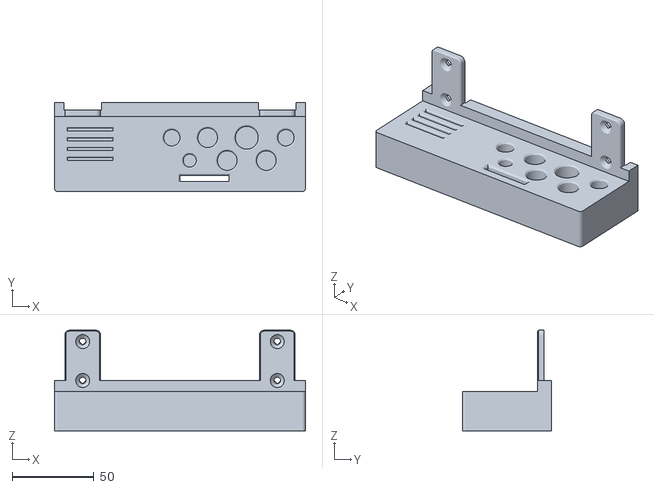
[picture p95: CAD file, 2026-11-13]
plan/precision/RULE_holder.stl
154.0 x 54.7 x 61.8
