mdrndesigns/pegboardlab/plan/bosch12v/C56_holder.stl

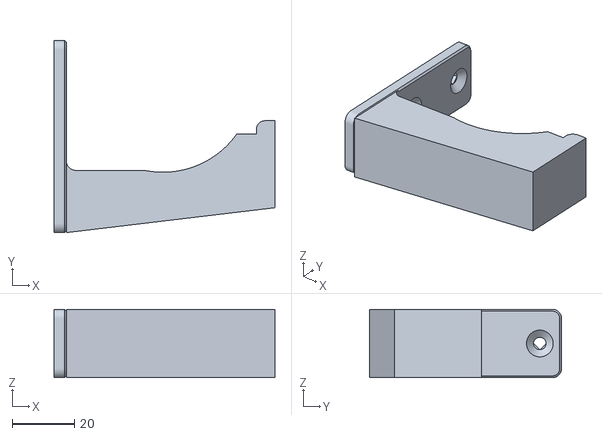
[picture p96: CAD file, 2026-11-13]
plan/bosch12v/C56_holder.stl
71.0 x 61.8 x 22.0
