mdrndesigns/pegboardlab/(list of files, cad)

Other CAD files:
plan/wera_bike12/WERA-BIKE12_spine.stl
plan/bosch12v/C38_spine.stl
plan/handtools/N30_spine.stl
plan/bosch12v/A60.3mf
plan/precision/CAL-MF_spine.stl
plan/precision/CAL-DF_spine.stl
plan/handtools/R-DRV_base.stl
plan/bosch12v/A80_spine.stl
plan/handtools/R-HEX.3mf
plan/precision/WRENCH_spine.stl
plan/bosch12v/S-SAW.3mf
plan/bosch12v/C56_spine.stl
plan/handtools/R-MEAS.3mf
plan/precision/MIC_spine.stl
plan/bosch12v/S-60.3mf
plan/handtools/R-PLI.3mf
plan/bosch12v/A40_spine.stl
plan/precision/RULE_spine.stl
plan/bosch12v/F100_spine.stl
plan/precision/SOCKET_spine.stl
plan/precision_v1_superseded/CAL-DE.3mf
plan/precision_v1_superseded/CAL-DE_holder.stl
plan/precision_v1_superseded/CAL-DE_spine.stl
plan/precision_v1_superseded/CAL-DF.3mf
plan/precision_v1_superseded/CAL-DF_holder.stl
plan/precision_v1_superseded/CAL-DF_spine.stl
plan/precision_v1_superseded/CAL-ME.3mf
plan/precision_v1_superseded/CAL-ME_holder.stl
plan/precision_v1_superseded/CAL-ME_spine.stl
plan/precision_v1_superseded/CAL-MF.3mf
plan/precision_v1_superseded/CAL-MF_holder.stl
plan/precision_v1_superseded/CAL-MF_spine.stl
plan/precision_v1_superseded/MIC.3mf
plan/precision_v1_superseded/MIC_holder.stl
plan/precision_v1_superseded/MIC_spine.stl
plan/precision_v1_superseded/RULE.3mf
plan/precision_v1_superseded/RULE_holder.stl
plan/precision_v1_superseded/RULE_spine.stl
plan/precision_v1_superseded/SOCKET.3mf
plan/precision_v1_superseded/SOCKET_holder.stl
plan/precision_v1_superseded/SOCKET_spine.stl
plan/precision_v1_superseded/WRENCH.3mf
plan/precision_v1_superseded/WRENCH_holder.stl
plan/precision_v1_superseded/WRENCH_spine.stl
plan/precision_v2_superseded/CAL-DF.3mf
plan/precision_v2_superseded/CAL-DF_spine.stl
plan/precision_v2_superseded/CAL-MF.3mf
plan/precision_v2_superseded/CAL-MF_spine.stl
plan/precision_v2_superseded/MIC.3mf
plan/precision_v2_superseded/MIC_spine.stl
plan/precision_v2_superseded/RULE.3mf
plan/precision_v2_superseded/RULE_holder.stl
plan/precision_v2_superseded/RULE_spine.stl
plan/precision_v2_superseded/SOCKET.3mf
plan/precision_v2_superseded/SOCKET_holder.stl
plan/precision_v2_superseded/SOCKET_spine.stl
plan/precision_v2_superseded/WRENCH.3mf
plan/precision_v2_superseded/WRENCH_holder.stl
plan/precision_v2_superseded/WRENCH_spine.stl
