mdrndesigns/pegboardlab/plan/prints_contact_sheet.pdf

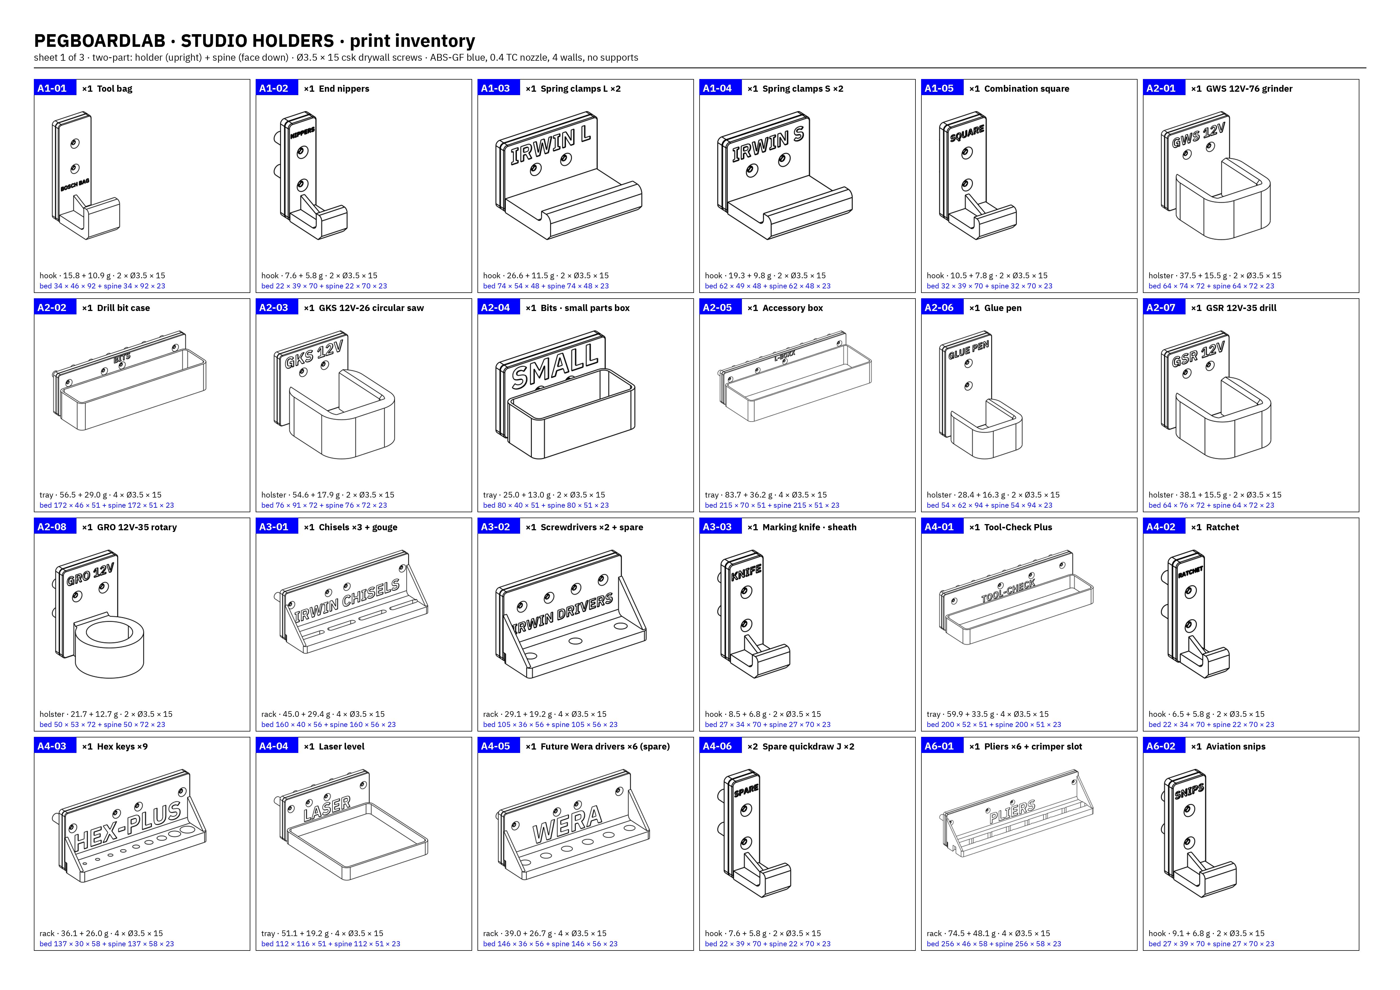
[picture p97: page 1]
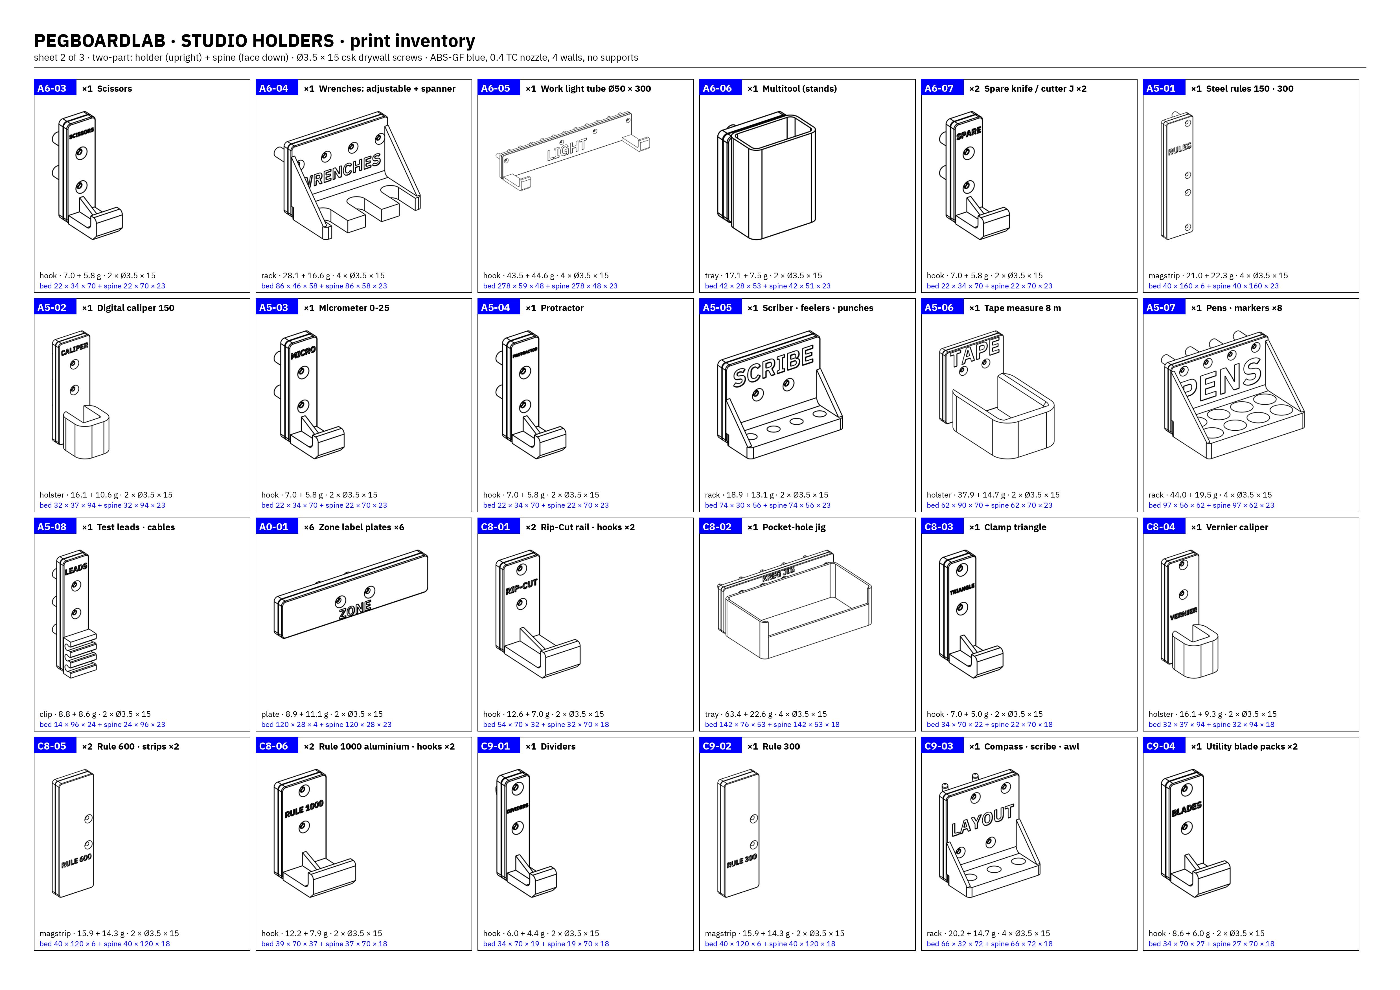
[picture p98: page 2]
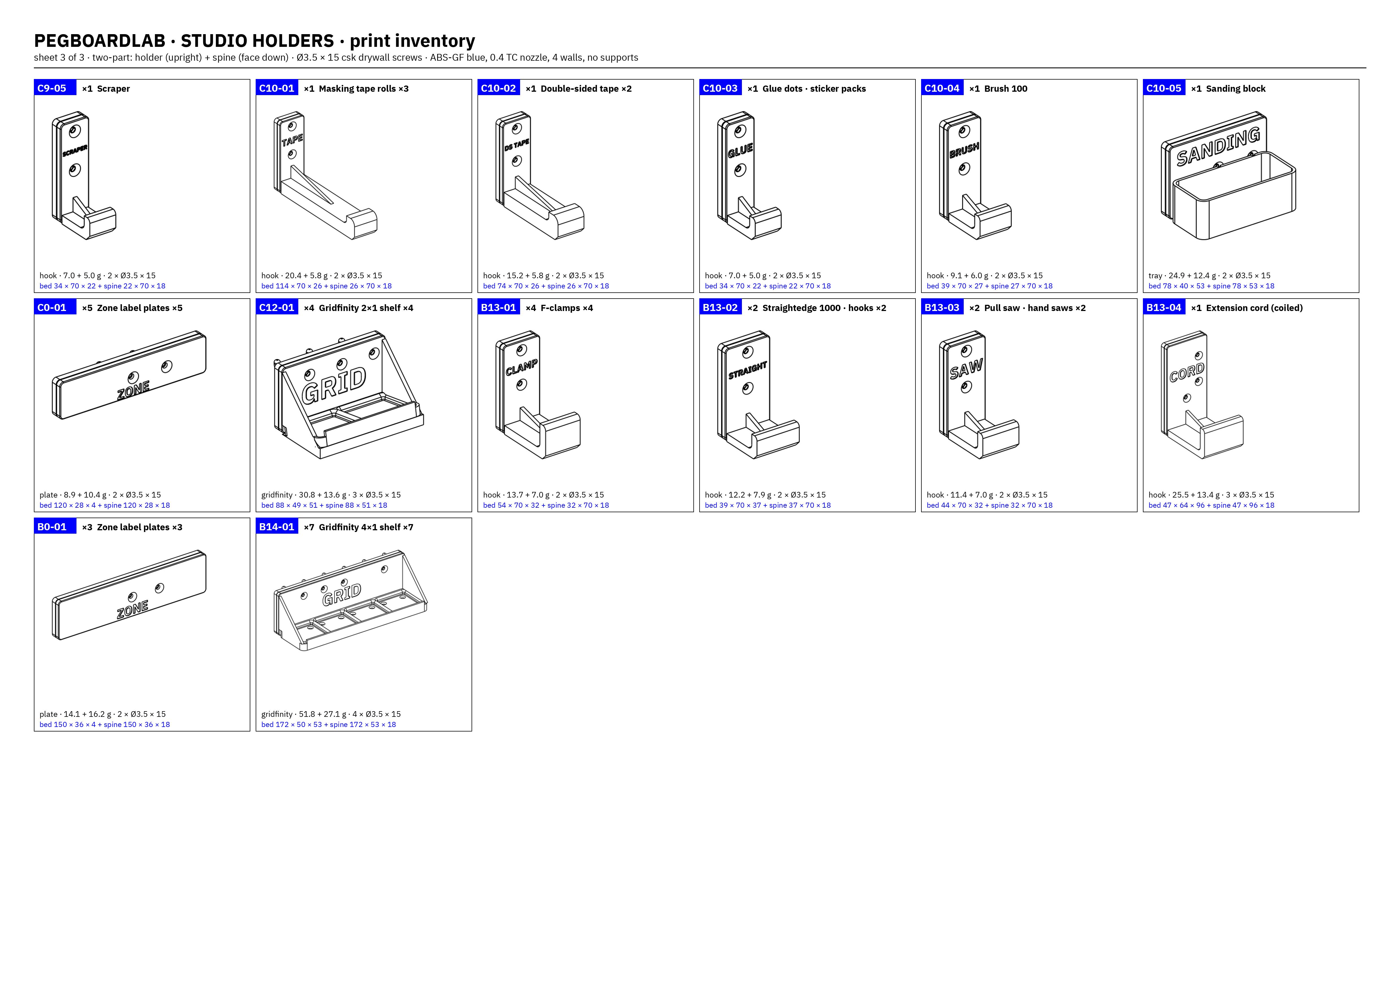
[picture p99: page 3]
