mdrndesigns/pegboardlab/plan/bosch12v/S-60_assembly.png

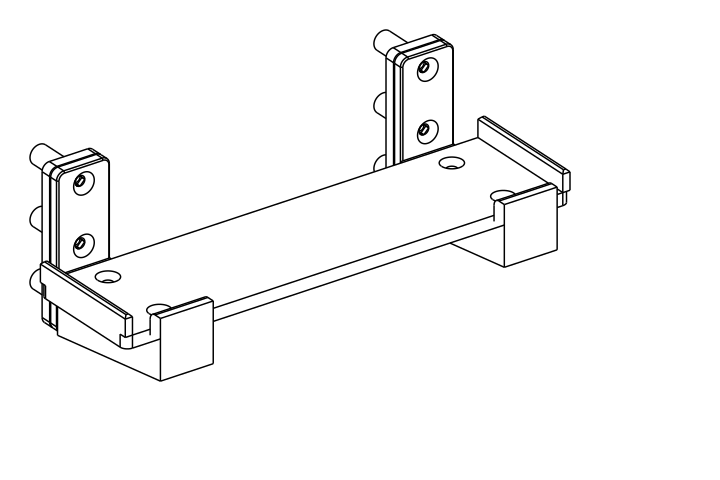
plan/bosch12v/S-60_assembly.png
