mdrndesigns/pegboardlab/plan/bosch12v/S-SAW_assembly.png

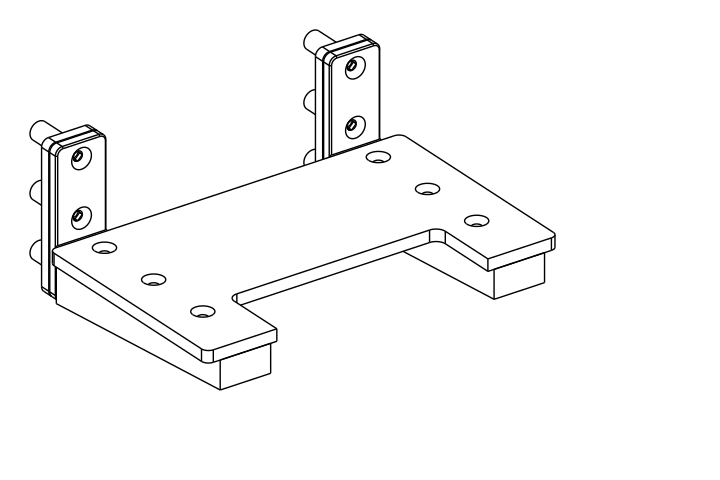
plan/bosch12v/S-SAW_assembly.png
