mdrndesigns/pegboardlab/plan/handtools/R-DRV_assembly.png

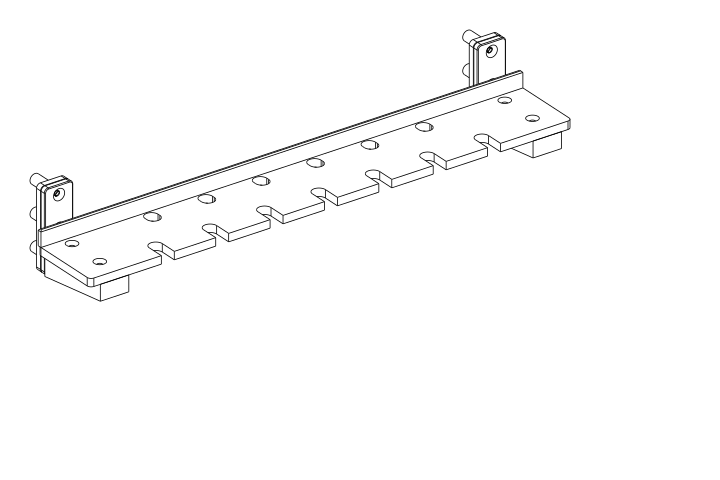
plan/handtools/R-DRV_assembly.png
