mdrndesigns/pegboardlab/plan/handtools/R-PLI_assembly.png

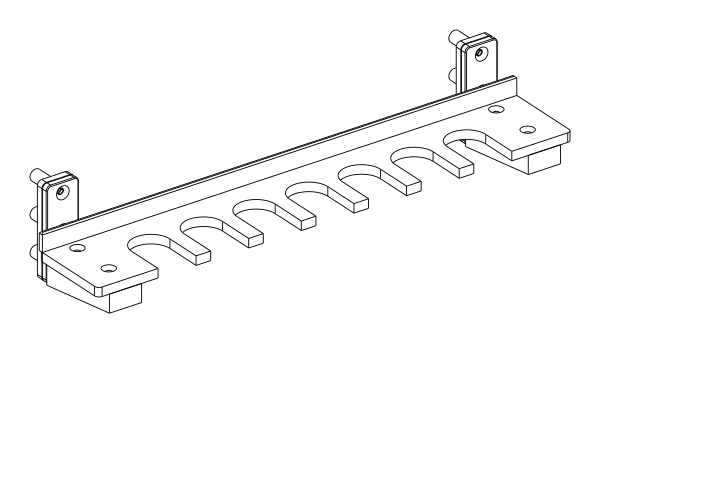
plan/handtools/R-PLI_assembly.png
