mdrndesigns/pegboardlab/samples/split_rack_print_bed.png

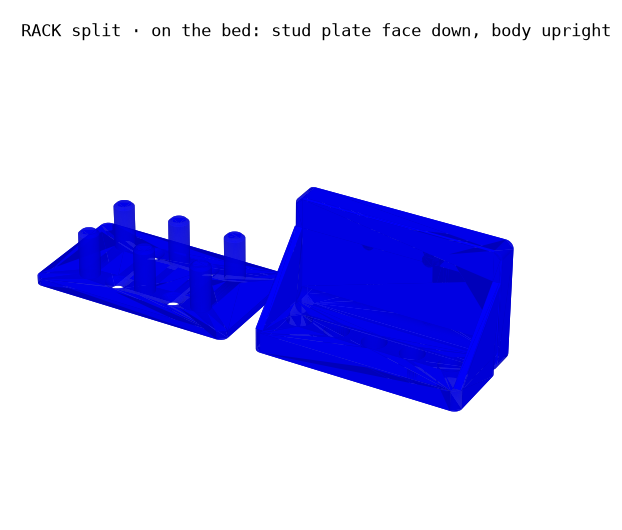
samples/split_rack_print_bed.png
