mdrndesigns/pegboardlab/plan/boardA/boardA_map.pdf

1 2

3

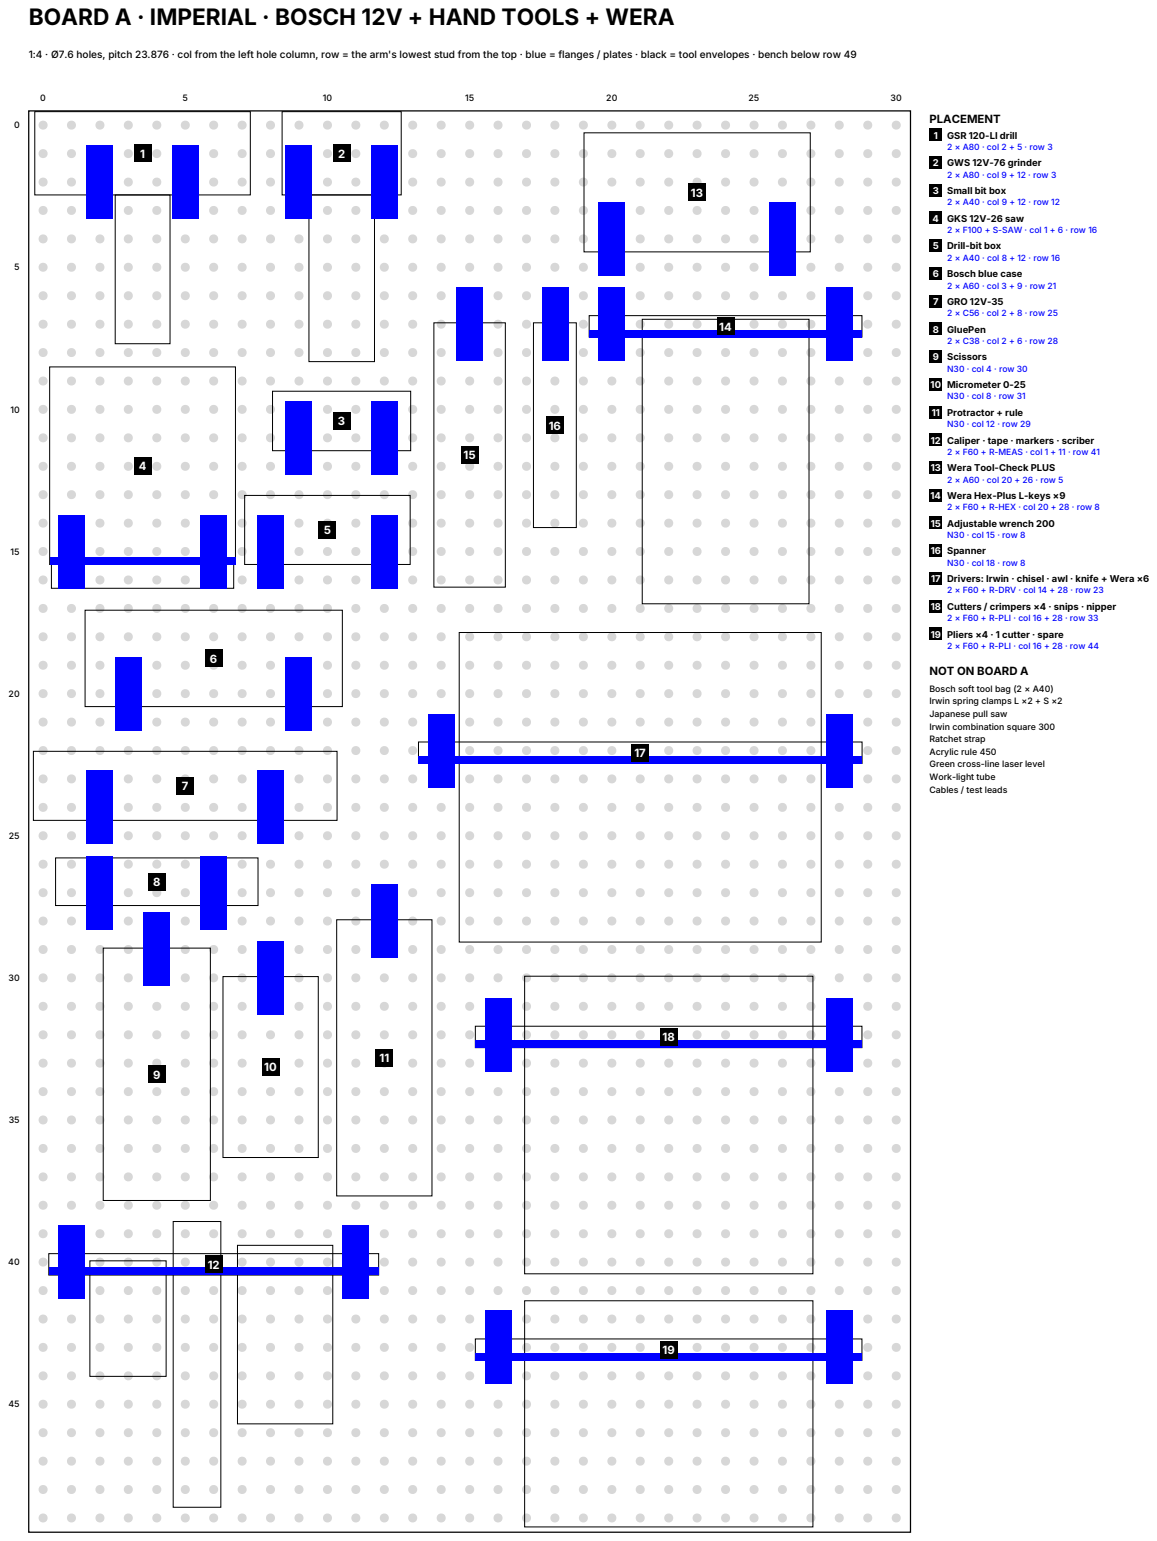
[picture p105: page 1]

BOARD A · IMPERIAL · BOSCH 12V + HAND TOOLS + WERA

1:4 · Ø7.6 holes, pitch 23.876 · col from the left hole column, row = the arm's lowest stud from the top · blue = flanges / plates · black = tool envelopes · bench below row 49

PLACEMENT
1 GSR 120-LI drill
2 × A80 · col 2 + 5 · row 3
2 GWS 12V-76 grinder
2 × A80 · col 9 + 12 · row 3
3 Small bit box
2 × A40 · col 9 + 12 · row 12
4 GKS 12V-26 saw
2 × F100 + S-SAW · col 1 + 6 · row 16
5 Drill-bit box
2 × A40 · col 8 + 12 · row 16
6 Bosch blue case
2 × A60 · col 3 + 9 · row 21
7 GRO 12V-35
2 × C56 · col 2 + 8 · row 25
8 GluePen
2 × C38 · col 2 + 6 · row 28
9 Scissors
N30 · col 4 · row 30
10 Micrometer 0-25
N30 · col 8 · row 31
11 Protractor + rule
N30 · col 12 · row 29
12 Caliper · tape · markers · scriber
2 × F60 + R-MEAS · col 1 + 11 · row 41
13 Wera Tool-Check PLUS
2 × A60 · col 20 + 26 · row 5
14 Wera Hex-Plus L-keys ×9
2 × F60 + R-HEX · col 20 + 28 · row 8
15 Adjustable wrench 200
N30 · col 15 · row 8
16 Spanner
N30 · col 18 · row 8
17 Drivers: Irwin · chisel · awl · knife + Wera ×6
2 × F60 + R-DRV · col 14 + 28 · row 23
18 Cutters / crimpers ×4 · snips · nipper
2 × F60 + R-PLI · col 16 + 28 · row 33
19 Pliers ×4 · 1 cutter · spare
2 × F60 + R-PLI · col 16 + 28 · row 44
NOT ON BOARD A
Bosch soft tool bag (2 × A40)
Irwin spring clamps L ×2 + S ×2
Japanese pull saw
Irwin combination square 300
Ratchet strap
Acrylic rule 450
Green cross-line laser level
Work-light tube
Cables / test leads
