mdrndesigns/pegboardlab/plan/bosch12v/bosch12v_map.pdf

# BOSCH 12V · BOARD A · IMPERIAL

## PLACEMENT

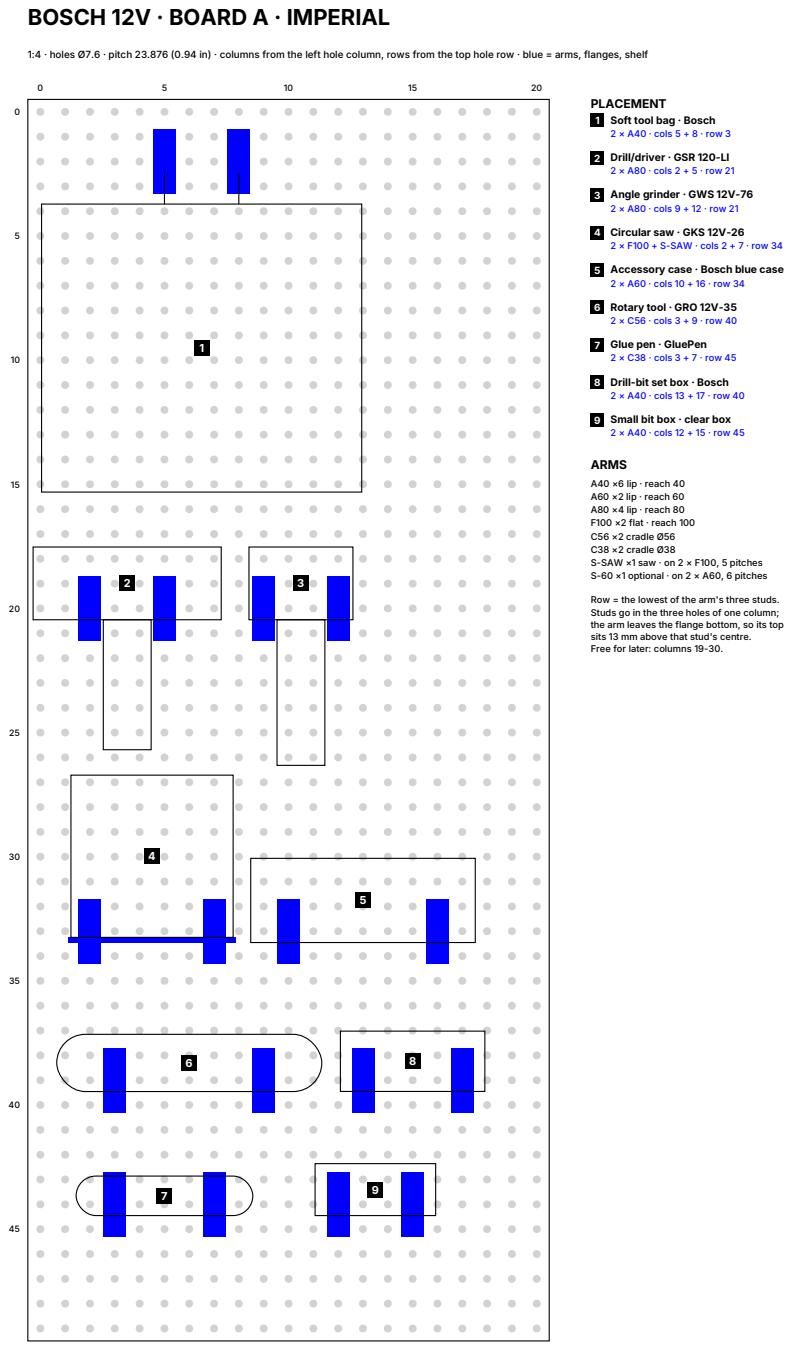
[picture p106: page 1]

1:4 · holes Ø7.6 · pitch 23.876 (0.94 in) · columns from the left hole column, rows from the top hole row · blue = arms, flanges, shelf

1 Soft tool bag · Bosch
2 × A40 · cols 5 + 8 · row 3
2 Drill/driver · GSR 120-LI
2 × A80 · cols 2 + 5 · row 21
3 Angle grinder · GWS 12V-76
2 × A80 · cols 9 + 12 · row 21
4 Circular saw · GKS 12V-26
2 × F100 + S-SAW · cols 2 + 7 · row 34
5 Accessory case · Bosch blue case
2 × A60 · cols 10 + 16 · row 34
6 Rotary tool · GRO 12V-35
2 × C56 · cols 3 + 9 · row 40
7 Glue pen · GluePen
2 × C38 · cols 3 + 7 · row 45
8 Drill-bit set box · Bosch
2 × A40 · cols 13 + 17 · row 40
9 Small bit box · clear box
2 × A40 · cols 12 + 15 · row 45

ARMS
A40 ×6 lip · reach 40
A60 ×2 lip · reach 60
A80 ×4 lip · reach 80
F100 ×2 flat · reach 100
C56 ×2 cradle Ø56
C38 ×2 cradle Ø38
S-SAW ×1 saw · on 2 × F100, 5 pitches
S-60 ×1 optional · on 2 × A60, 6 pitches

Row = the lowest of the arm's three studs.
Studs go in the three holes of one column;
the arm leaves the flange bottom, so its top
sits 13 mm above that stud's centre.
Free for later: columns 19-30.
